NikitaSM5/ATmega-16-RTD/СМ5-81_ДЗ_Зельницкий_НА.docx

Gerb-BMSTU_01

| Министерство науки и высшего образования Российской Федерации Федеральное государственное бюджетное образовательное учреждение высшего образования «Московский государственный технический университет имени Н.Э. Баумана (национальный исследовательский университет)» (МГТУ им. Н.Э. Баумана)

ФАКУЛЬТЕТ | Специальное машиностроение

КАФЕДРА | Автономные информационные и управляющие системы

дисциплина | Цифровые устройства и микропроцессоры

домашнее задание

Устройство измерения температуры

название домашнего задания

Группа | СМ5-81

Студент | | | | | Зельницкий Н.А.
| | | подпись | | фамилия, и.о.

Преподаватель | | | Кичигин А.А.
| подпись | | фамилия, и.о.

1 Техническое задание

Устройство должно измерять температуру окружающей среды, выдавать ее на 4 семисегментных индикатора в формате "xx.xx" и записывать на sd карту с указанием метки времени в формате "<номер измерения> дд:мм:гггг чч:мм <температура>". В качестве датчика использовать RTD Pt100. В качестве микросхемы преобразователя данных с RTD использовать MAX31865. Измерение происходит каждый час. Должна быть предусмотрена возможность чтения данных записанных на sd карту на ПК (например, по интерфейсу RS-232). Так же на LCD дисплее отображается текущее время, количество измерений на SD карте. Должна быть предусмотрена возможность отображения сохраненных измерений на SD карте. Частота тактирования микроконтроллера ATmega-16 - 8МГц, питание микроконтроллера, индикаторов и дисплея LCD - 5В, периферийных устройств (MAX31865, SD карта, часы реального времени) - 3.3В.

2 Разработка схемы электрической структурной

Схема электрическая структурная приведена в приложении А.

Схема электрическая структурная состоит из следующих блоков:

1) кварцевый резонатор,

2) кнопки,

3) 4 семисегментных индикатора,

4) разъем SD,

5) микроконтроллер,

6) преобразователь UART RS-232,

7) разъем программирования SPI,

8) микросхема max31865,

9) разъем DB9,

10) датчик Pt100,

11) микросхема реального времени PCF 8583,

12) разъем питания 5В,

13) фильтр по питанию,

14) защита от переполюсовки,

15) линейный преобразователь напряжения.

Блок кварцевый резонатор предназначен для стабилизации тактовой частоты микроконтроллера.

Блок кнопки, состоит из 4-х кнопок подключенных к выводам PC3, PC5, PC6, PC7 микроконтроллера, назначение кнопок следующее: при удержании PC3 на семисегментные индикаторы выводится текущее время в формате "мм.сс", нажатие кнопки PC5 позволяет посмотреть следующую запись на SD карте, кнопка PC6 возвращает счетчик записей в начало (к первой записи), по нажатию PC7 все содержимое SD карты отправляется по UART на ПК.

Блок семисегментные индикаторы включает в себя четырехразрядный семисегментный индикатор для отображения температуры или времени.

Блок SD карты включает в себя SD карту, которая по интерфейсу SPI обменивается данными с микроконтроллером.

Блок микроконтроллер состоит из микроконтроллера ATmega-16PU, к нему подключены все остальные блоки.

Блок преобразователь UART RS-232, предназначен для подключения приемо-передатчика UART к физическому разъему DB9.

Блок разъем программирования SPI предназначен для программирования микроконтроллера.

Блок микросхема MAX31865 включает в себя микросхему MAX31865 представляющую собой 15-ти битный АЦП, обменивающийся с микроконтроллером по интерфейсу SPI.

Блок разъем DB9 предназначен для передачи данных между ПК и микроконтроллером.

Блок датчик Pt100 представляет собой датчик температуры Pt100, на основе сопротивления данного датчика и микросхемы MAX31865 микроконтроллер получает данные о температуре.

Блок микросхема реального времени PCF 8583 представляет собой часы реального времени, необходимые для фиксирования времени измерения температуры, а также часовых интервалов, обменивается с МК по интерфейсу I2C.

Блок разъем питания 5В предназначен для подключения питания к микроконтроллеру.

Блок фильтр по питанию необходим для фильтрации питания МК.

Блок защита от переполюсовки предназначен для защиты МК от переполюсовки питания.

Блок линейный преобразователь напряжения предназначен для питания периферийных устройств, таких как SD карта, и MAX31865.

3 Разработка схемы электрической принципиальной

Схема электрическая принципиальная и перечень элементов приведены в приложении А.

Блок кварцевый резонатор, представлен кварцевым резонатором ZQ1 8 МГц, кристалл подключён между выводами XTAL1/XTAL2, каждая нога заземлена через конденсаторы C16 и C17 по 22 пФ.

Блок кнопки, SB1 — аппаратный «RESET»: при нажатии замыкает вывод RESET МК на землю, а R7 10 кОм держит линию подтянутой к питанию в остальное время. SB2–SB5 — пользовательские. Каждый соединён с портами PC3, PC5, PC6, PC7. Перед микроконтроллером стоят токоограничивающие резисторы R15–R18 по 1 кОМ; сами выводы подтянуты к VDD внутренним pull-up МК, поэтому логика «активный 0».

Блок четырёхразрядный 7-сегментный индикатор, сам индикатор HG1 CC56-12SRWA подключён по классической схеме мультиплексирования: сегменты A…DP (всего 8 линий) подключены к порту A; общие катоды/аноды разрядов коммутируют транзисторы VT1–VT4 (маломощные NPN) через базовые резисторы R9–R12 10 кОм. Базы управляются портом PB0–PB3. МК быстро «перещёлкивает» VT1–VT4, выводя в тот же момент код сегментов.

Блок разъем SD, X1 «SD_card» имеет выводы CMD (MOSI), CLK (SCK), DAT0 (MISO), CS, CD. На линиях данных стоят подтяжки R1, R3, R5, R6 по 10 кОм к шине 3V3, чтобы SD корректно себя вела до инициализации. Сразу у разъёма стоят конденсаторы C3, C4 0,1 µF для борьбы с импульсными бросками тока.

Передача идёт по SPI, линию SCK формирует PB7, MOSI — PB6, MISO — PB7, а PC4 служит выбором CS (совместно с MAX31865).

Блок микроконтроллер, чип разбит на два УГО D2.1/D2.2. Питается от +5 В (VCC): локальная развязка выполнена керамиками C2, C5, C7 по 0,1 µF прямо у ножек питания.

Блок преобразователь UART RS-232, Функциональный узел реализован одной микросхемой MAX202CDR (позиция D3) . MAX202 содержит два драйвера и два приёмника с интегрированным зарядовым насосом, формирующим на базе внешних конденсаторов C1–C4 = 0,1 µF уровни V+ ≈ +9 В и V − ≈ −9 В из однополярного питания +5 В. TTL-выводы T1IN/R1OUT связаны соответственно с линиями TXD (PD1) и RXD (PD0) микроконтроллера, а выходы T1OUT/R1IN подают сигналы уровня EIA-232 на разъём DBR-9M (X2), контакты 2 (TX) и 3 (RX). Такой подход обеспечивает двусторонний обмен данными со скоростями до 120 кбит/с при гальванической развязке по потенциалам ±10 В, что соответствует спецификации TIA/EIA-232-F.

Блок разъем программирования SPI, Разъём XP4 «PLD-4» предоставляет стандартный шлейф AVR-ISP (MISO, MOSI, SCK, RESET, VCC, GND). Проводимость линий SPI обеспечивается непосредственно выводами МК (PB5/MOSI, PB6/MISO, PB7/SCK), а общий сброс формируется выводом RESET через подтяжку R7 = 10 kОМ. Такой интерфейс позволяет выполнять внутрисистемное программирование флэш-памяти ATmega16 без демонтажа микросхемы.

Блок микросхема max31865, Измерительный канал построен на специализированном Δ-Σ-АЦП MAX31865 (D1). Эталонный резистор R2 = 430 Ом формирует токовый источник ≈ 2,05 мА для платинового датчика. Четырёхпроводное подключение (пары FORCE ± и RTDIN ±) компенсирует омическое сопротивление линий. Декуплирующие конденсаторы C1, C6, C8 = 0,1 µF шунтируют аналого-цифровое и цифровое питания чипа. Управление осуществляется по интерфейсу SPI (SDI, SDO, SCLK), однако для защиты временных шин модуль имеет индивидуальный сигнал CS. MAX31865 выполняет 15-битное оцифровывание, что даёт разрешение ≈ 0,0076 °C на диапазоне 0–400 °C при Pt100.

Блок разъем DB9, разъём DBR-9M (X2) служит физическим интерфейсом к внешнему СOM-порту персонального компьютера, принимая уровни ±9 В с микросхемы MAX202. Назначения ножек выведены прямо на схеме: 2 — RS232TX, 3 — RS232RX, 5 — GND.

Блок датчик Pt100, к контактам FORCE ± подаётся стабильный токовый источник чипа MAX31865, напряжение на выводах RTDIN ± считывается тем же чипом; возвратный токовый вывод ISENSOR позволяет измерителю контролировать реальный ток через датчик. Трех проводная схема исключает погрешность, вызванную омическим сопротивлением кабеля и разъёмов.

Блок микросхема реального времени PCF 8583, микросхема PCF8583P (D2) питается от стабилизированного напряжения 3,3 В и стабилизируется кварцевым резонатором ZQ2 = 32,768 кГц с нагрузочными конденсаторами C18, C19 = 22 пФ. Информационный обмен ведётся по шине I²C (SCL — PC0, SDA — PC1). Вывод NINT обеспечивает аппаратное прерывание будильника на вход МК PC2. Локальная фильтрация питания реализована конденсаторами C11–C13 = 0,1 µF, что позволяет RTC сохранять ход времени при импульсных помехах.

Блок разъем питания 5В, Коннектор XP3 (DJB-02B) имеет нумерацию: контакт 1 — +5 В, контакт 3 — GND . Далее напряжение поступает на цепи защиты и фильтрации, после чего распределяется по функциональным узлам.

Блок защита от переполюсовки, выполнен шоттки-диодом VD1 в прямом включении между входом +5 В и потребителями. При обратном подключении источника питания диод запирается, ограничивая обратный ток до единиц микроампер и предотвращая выход из строя downstream-электроники. Применение шоттки-структуры минимизирует прямое падение (≈ 0,3 В) при штатной полярности.

Блок фильтр по питанию, представлен конденсатором C2.

Блок линейный преобразователь напряжения, LDO ADP165 (DA1) формирует шину 3V3 из входных +5 В . Типичный ток нагрузки — до 150 мА; остаточное падение напряжения ΔV ≈ 250 мВ при 100 мА. Конденсаторы C3, C4, C12 = 0,1 µF рекомендуются даташитом для устойчивости петли обратной связи и подавления шумов. Логический вход EN подтянут резистором R4 = 10 kОм к выходному напряжению, что обеспечивает автозапуск без внешнего сигнала. Сформированная шина 3,3 В питает SD-накопитель, MAX31865, PCF8583 и логические каскады индикации, что снижает тепловые потери и электромагнитные выбросы относительно прямого питания от 5 В.

4 Разработка алгоритма программы

Блок схема алгоритма программы представлена в приложении А.

Таблица 1 — Глобальные переменные объявленные в main

Переменная | Тип | Назначение
fwd_hold_cnt, bwd_hold_cnt | volatile uint16_t | Сколько миллисекунд удерживается соответствующая кнопка «вперёд/назад»; используется для определения долгого нажатия.
fwd_rep_cnt, bwd_rep_cnt | volatile uint16_t | Таймер повтора событий при удержании кнопок (автоповтор навигации).
ms_ticks | volatile uint32_t | Счётчик миллисекунд, увеличивается в прерывании TIMER0_OVF; служит единой «системной» временной базой.
nav_end_event, nav_start_event | volatile uint8_t | Одноразовые флаги «перейти в конец лога» / «в начало лога», выставляются на двойной клик соответствующих кнопок.
last_sent_meas | volatile uint32_t | Кол-во записей, уже выгруженных по UART, чтобы продолжать нумерацию после дампа.
meas_no | uint32_t | Текущий номер измерения, считая с 1 (заполняется при старте размером файла SD).
nav_pos | uint32_t | «Курсор» при просмотре лога: номер строки, показанной на LCD.
rtc_time | struct pcf_time | Последнее прочитанное время из RTC PCF8583.
disp_digits[4] | volatile uint8_t[4] | Четыре BCD-разряда, которые мультиплексно отображаются на 7-сегментном индикаторе.
linebuf[32], linebuf_hist[32] | char[32] | Рабочие буферы для текущей строки лога (основной/исторический режим).
scroll_buf[32], scroll_len, scroll_ofs, scroll_t0 | char[32], uint8_t, uint8_t, uint32_t | Хранят текст бегущей строки на LCD и параметры её прокрутки.
last_sent_entry | uint32_t | Запоминает номер последней строки, успешно отправленной по UART (для прогресс-бара во время дампа).

Таблица 2 — Глобальные массивы с областью видимости во всем проекте

Модуль | Массив | Назначение
main.c | disp_digits | Данные для 7-сегментника.
sdcard.c | sec_buf[512] | RAM-буфер целого сектора SD-карты; заполняется перед чтением/записью.
sevseg.c | dec2sevseg[10] | Таблица кодов сегментов для цифр 0–9. ctrl_pins[4] — маски выводов катодов/анодов.

Файл main.c — это центральный модуль, управляющий всей работой измерительного стенда на МК ATmega16

Подключаемые файлы и стандартные заголовки: в начале подключаются пакеты для работы с семисегментными индикаторами, MAX31865, шины TWI, часов RTC PCF8583, SD-карты, LCD 16×2, а также стандартные заголовки AVR (avr/io.h, avr/interrupt.h, util/delay.h, stdlib.h, string.h). Благодаря этим включениям в main.c почти нет «ручной» работы с аппаратными регистрами — исключение составляет настройка таймеров и портов ввода-вывода.

Макросы и константы: частота F_CPU задаётся 8 000 000 Гц, чтобы функции _delay_ms() и _delay_us() рассчитывали правильные паузы. Определены маски кнопок (PC3 — переключение режима, PC5 и PC6 — навигация вперёд / назад, PC7 — дамп журнала и регистр маски всех семисегмент-катодов. Для автоповтора кнопок заданы задержка перед первым повтором 250 мс, базовый период повторов 500 мс и минимально допустимый период 1 мс. Для бегущей строки на LCD заданы пауза в начале и конце 1000 мс и шаг прокрутки 250 мс.

Глобальные переменные ms_ticks — глобальный счётчик миллисекунд, который увеличивается в прерывании TIMER0. fwd_hold_cnt и bwd_hold_cnt — время удержания кнопок «вперёд» и «назад» в миллисекундах. fwd_rep_cnt и bwd_rep_cnt — обратные таймеры автоповтора для тех же кнопок. last_sent_meas — число строк, уже переданных на ПК; нужно, чтобы после дампа продолжить нумерацию журнала. scroll_t0, scroll_len и scroll_ofs — параметры бегущей строки (момент запуска, общая длина текста и текущий сдвиг). Структура flags (8 бит) содержит флаги: one_sec, ten_sec, nav_fwd, nav_bwd, uart_dump, btn_lock, history, hist. Первый выставляется каждую секунду, второй — раз в десять секунд (для проверки) или раз в час согласно тз, следующие два инициируют навигацию на одну строку, uart_dump стартует выгрузку лога в UART, btn_lock временно блокирует действия кнопок во время записи или дампа, history сообщает, что пользователь нажал кнопку переключения режима, а hist хранит текущий режим «история активна / неактивна». disp_digits[4] — четыре ВCD-цифры для семисегментника. linebuf — строка с актуальным измерением, выводимая во втором ряду LCD в режиме Live. linebuf_hist — строка, показанная в режиме History. scroll_buf[32] — копия той же строки для плавной прокрутки.

Вспомогательные функции bcd2dec() преобразует один BCD-байт из регистра часов в десятичное число. time2str() формирует строку «ЧЧ:ММ:СС» из структуры времени RTC.

temperature_to_digits_tenth() переводит число с плавающей точкой (градусы) в четыре BCD-разряда с одной десятичной точкой и знаком, помещая результат в disp_digits. go_to_log_start() и go_to_log_end() позиционируют взаимодействующий с SD-картой итератор на первую или последнюю запись журнала, считывают строку, обрезают перевод строки, перерисовывают вторую строку LCD и запускают скролл.

scroll_update() каждые 250 мс сдвигает 16-символьное «окно» по scroll_buf и печатает его на LCD; в начале и в конце строки выдерживается секундная пауза. uart_putc() и uart_puts() передают байт или строку по UART, опрашивая флаг готовности UDRE. uart_dump_log() перебирает все записи SD-карты, отправляет их в UART, выводит прогресс на LCD, корректирует счётчик last_sent_meas, а в конце очищает SD-файл.

Обработчики прерываний ISR(TIMER1_COMPA_vect) срабатывает раз в 1024 мс, поднимает флаг one_sec; через 10/60 итерации устанавливает ten_sec. ISR(TIMER0_OVF_vect) тикает каждую миллисекунду. Он обслуживает динамическую индикацию семисегментника (если не идёт дамп), увеличивает ms_ticks, опрашивает кнопки, ловит фронты, измеряет длительность удержания и двойные клики, рассчитывает период автоповтора и выставляет соответствующие флаги навигации, переключения режима или запуска дампа.

Инициализационные функции: uart_init() включает передатчик и приёмник, настраивает скорость 56 кбод в режиме удвоенной скорости. timer0_init() задаёт предделитель 64, разрешает прерывание TOIE0. timer1_init() включает режим CTC, ставит делитель 256 и значение OCR1A = 1023, что даёт ровно 1024 тиков F_CPU и интервал ≈ 1,024 с. port_init() переводит PC3, PC5, PC6 и PC7 во входы с подтяжками; остальные линии настраиваются драйверами периферии.

Ход работы функции main(): после подключения заголовков и объявления глобальных переменных вызываются: uart_init, port_init, sevseg_init, lcd_init. На LCD временно выводится цифра 1 как индикатор этапа загрузки. Затем выполняется max31865_init (на LCD появится цифра 2), функция timer0_init, функция timer1_init, далее — sd_iter_reset (логический «курсор» ставится на конец файла на SD-карте), twi_init, глобальное разрешение прерываний sei() и инициализация RTC pcf_init(). Число уже существующих записей считывается функцией sd_get_entry_count и сохраняется в переменную meas_no.

Далее запускается бесконечный цикл. Если установлен флаг history, программа меняет текущий режим: если режим History выключен, она копирует текущую строку лога из linebuf_hist на LCD и подготавливает скролл; если включён — возвращается к режиму Live. При флаге one_sec считывается время через TWI из RTC, запускается преобразование RTD-значения в температуру, число формируется на семисегментнике, LCD получает строку «ЧЧ:ММ:СС #N». При флаге ten_sec (и если кнопки не заблокированы) формируется строка «HH:MM:SS;T=xx.x», записывается на SD-карту, копируется в linebuf_hist, а режим History при необходимости обновляет индикацию и бегущую строку; после записи кнопки вновь разрешены. При флагах nav_fwd или nav_bwd итератор двигается на одну запись вперёд или назад; при nav_*_event (двойной клик) он прыгает в начало или конец журнала соответственно. При флаге uart_dump вызывается uart_dump_log, после чего SD-карта очищается, а переменные счётчика и буферы обновляются. Каждую итерацию цикла вызывается scroll_update, которая сдвигает бегущую строку.

Алгоритм обработки кнопок и автоповтора ISR TIMER0 обнаруживает фронт кнопки, сохраняет время нажатия, через 250 мс активирует первую автоповторную прокрутку и далее уменьшает интервал до 1 мс пропорционально объёму журнала. Второй фронт, пришедший раньше 70 мс после первого, трактуется как двойной клик; это поднимает специальные флаги nav_start_event или nav_end_event.

Сенсор через MAX31865 работает в непрерывном режиме; каждую секунду считывается регистр RTD, преобразуется в температуру и отображается. Каждые десять секунд строка журнала записывается на SD; при удержании кнопки PC7 весь журнал побайтно передаётся в UART и затем файл на карте очищается. Семисегментник обновляется из ISR TIMER0, а LCD обновляется только из главного цикла, чтобы не нарушать тайминги дисплея.

Назначение модуля: sevseg.c реализует полный пакет для работы четырёхразрядного семисегментного индикатора. Драйвер выполняет инициализацию портов, преобразует двоичное 16-битное число в BCD-4, обеспечивает циклический вывод разрядов с возможностью гашения ведущих нулей, установки десятичной точки и отображения знака «минус».

Аппаратная привязка: в начале файла заданы макросы DATA_PORT/ DATA_DDR, указывающие на порт A, к которому подключены сегменты, и CTRL_PORT/CTRL_DDR, указывающие на порт B, где расположены управляющие выводы общих анодов/катодов разрядов. Для индивидуальных линий выбраны биты PB0…PB3, а маска CTRL_PIN_MASK объединяет их для массовых операций. Эта схема даёт возможность за один такт гасить все разряды или включать любой из них.

Глобальные статические параметры: dot_pos хранит номер разряда (0–3), возле которого следует зажечь точку; значение 0xFF означает, что точка выключена. Флаг blank_leading определяет, нужно ли подавлять вывод ведущих нулей. Для знака «минус» зарезервирован сегментный шаблон SEVSEG_MINUS_CODE = 0b00000010, соответствующий зажиганию только среднего горизонтального сегмента.

Константные таблицы: ctrl_pins[4] и dec2sevseg[10] помещены в flash-память (PROGMEM), чтобы не расходовать ОЗУ. Первая таблица содержит готовые маски включения нужного разряда, вторая — коды сегментов для цифр 0…9. Использование pgm_read_byte() исключает лишнее копирование в SRAM и ускоряет доступ.

Инициализация: sevseg_init() переводит все восемь линий порта A и четыре линии порта B в режим выхода, гасит сегменты (DATA_PORT = 0) и разряды (CTRL_PORT &= ~CTRL_PIN_MASK). В конце дополнительно активируется первый индикатор; замечание TODO в комментарии предлагает проверить необходимость этой строки, но она полезна как тест на целостность схемы при старте.

Преобразование числа: sevseg_bin2bcd() разбивает 16-битное беззнаковое значение на тысячи, сотни, десятки и единицы простой последовательностью делений и модулей. Заполнение массива идёт от старшего разряда к младшему, поэтому достаточно один раз сдвинуть указатель в конец и декрементировать его по мере работы. Максимально поддерживаемое число — 9999.

Внутренний счётчик разрядов: статическая функция inc_number_digit() инкрементирует локальную переменную num_dig и маскирует её по & 0x03, получая циклическую последовательность 0 → 1 → 2 → 3 → 0. Такой счётчик позволяет вызывать диспетчер вывода из прерывания таймера с частотой ≈1 кГц, обеспечивая частоту обновления каждого разряда ≈250 Гц без избытка вычислений. sevseg

Отрисовка одного разряда: display_digit() сначала гасит всё (обнуляет порт данных и снимает все управляющие биты), затем выбирает нужный символ: если код ≤ 9, берётся шаблон из dec2sevseg; если код 0x0A, отображается «минус»; любые иные коды игнорируются, что даёт универсальный «пустой» символ. Для подавления лидирующих нулей функция проверяет, нет ли ненулевых разрядов старше текущего; если их нет и цифра равна нулю, разряд просто остаётся выключенным. При совпадении num_dig с dot_pos в шаблон OR’ом добавляется бит десятичной точки (LSB). После формирования маски сегментов она выводится в DATA_PORT, а в CTRL_PORT устанавливается бит выбранного разряда. Cхема алгоритмаCхема алгоритма

Процесс отображения: sevseg_display_process() является внешним интерфейсом для приложения. На каждый вызов она запрашивает очередной номер разряда у inc_number_digit() и передаёт управление display_digit(). Таким образом за четыре последовательных вызова (например, четыре тика таймера) отрисовывается полное число.

Выключение: sevseg_off() сбрасывает DATA_PORT, мгновенно гасит все сегменты и может использоваться для экономии энергии во время длительного сна МК или при передаче буфера UART, когда световой шум нежелателен.

Взаимодействие с остальной прошивкой: главный модуль (main.c) предварительно преобразует температуру или счётчики в BCD-4 через sevseg_bin2bcd(), затем помещает результат в глобальный массив disp_digits. Прерывание TIMER0 вызывает sevseg_display_process(disp_digits) с частотой 1 кГц; если идёт дамп журнала, отображение временно останавливается, и порт A обнуляется.

Назначение модуля: max31865.c формирует полностью автономный драйвер SPI-конвертера, обеспечивая инициализацию, считывание «сырых» данных RTD, перевод сопротивления сенсора Pt100 в температуру по уравнению Каллендара–Ван Дюзена, а также обработку и сброс флагов неисправностей.

Аппаратная привязка: вывод CS приёмника назначен PB4; макросы MAX31865_CS_PORT, MAX31865_CS_DDR, MAX31865_CS_PIN задают этот вывод и используются в inline-процедурах cs_low() и cs_high() для формирования SPI-кадров .

Регистровая карта: заголовок описывает восьмибитные адреса 0×00…0×07; конфигурационный регистр (адрес 0) содержит биты CFG_BIAS, CFG_MODE_AUTO, CFG_3WIRE, CFG_FILT50HZ и проч., а регистр RTD_MSB/LSB (адреса 1/2) хранит 15-битное измеренное значение сопротивления.

Калибровочные константы: номинальное сопротивление RTD R0 = 100 Ω, опорный резистор платы RREF = 430 Ω, а также коэффициенты A, B и C классического полинома Pt100 (значение C используется только ниже 0 °C).

Базовые операции SPI: функции write_reg() и read_reg() формируют однобайтовые транзакции (бит 7 адреса отвечает за признак записи), read_reg16() расширяет процедуру до приёма двух последовательных байт; каждая транзакция обрамляется опусканием и подъёмом CS, что гарантирует атомарность обмена.

Процедура инициализации: max31865_init(three_wire, filter50Hz) настраивает CS-пин как выход, активирует общий драйвер SPI, производит начальную инициализацию SD-карты, формирует байт cfg, в который при необходимости включаются биты трёхпроводной компенсации и 50-герцового фильтра, далее включает ток RTD (CFG_BIAS), выдерживает 10 мс для термостабилизации и переводит микросхему в непрерывный режим измерения (CFG_MODE_AUTO).

Чтение «сырых» данных: max31865_read_raw() извлекает 16-битное поле RTD, сдвигает его вправо на 1 бит (убирая флаг ошибки) и маскирует до 15 бит – результат соответствует диапазону 0…32767 .

Нормирование сопротивления: функция max31865_read_temperature() умножает «сырое» число на RREF/32768, получая реальное сопротивление Rt; далее вычисляет относительное значение Z = Rt/R0 .

Диагностика: max31865_read_fault() читает регистр FAULT_STATUS и возвращает маску флагов обрыва, короткого замыкания и других сбоев; max31865_clear_fault() временно останавливает преобразования, записывает в CFG_CLEAR_FAULT, затем перезапускает режим bias + auto, полностью очищая регистр ошибок max31865max31865.

Интеграция с прошивкой: главный цикл проекта извлекает температуру через max31865_read_temperature() раз в секунду и передаёт её в процедуру temperature_to_digits_tenth() для отображения; кроме того, «сырое» значение может быть журналировано на SD для последующего анализа. Модуль не содержит блокирующих задержек, кроме 10-миллисекундной паузы в инициализации, и поэтому не препятствует выполнению остальных задач системы.

Назначение модуля: sdcard.c реализует фундаментальный слой доступа к съёмному энергонезависимому запоминающему устройству стандарта Secure-Digital в режиме SPI. Принята парадигма «одна строка журнала — один логический сектор»: каждое сообщение длиной до 510 байт помещается целиком в сектор объёмом 512 байт, завершается символом LF, а оставшееся пространство заполняется маркером 0xFF — этот приём избавляет от расчётов смещения внутри блока и ускоряет навигацию по журналу.

Аппаратная привязка и базовые макросы: линия Chip-Select карты подключена к выводу PC4. Шаблоны spi_x() (полудуплексная передача) опираются на универсальный драйвер spi_transfer() и используются во всех транзакциях протокола SD SPI.

Глобальные структуры данных: статический буфер sec_buf[512] хранит содержимое текущего сектора; флаг card_sdhc различает карты адресных пространств SDSC (байтовая адресация) и SDHC (блочная адресация); счётчики next_sector и it_sector задают точку очередной записи и позицию итератора чтения соответственно; переменная eeprom_next_sector, размещённая в области EEPROM, обеспечивает устойчивость журнала к выключениям питания .

Командный интерфейс: функция sd_cmd() формирует пять-байтную команду SD-SPI (префикс 0x40|CMD, аргумент 32 бит, контрольная сумма) и далее опрашивает карту до появления ответа с битом ready=0 . Такой неспешный 10-байтовый цикл выбран как компромисс между латентностью и совместимостью с медленными носителями.

Процедура инициализации (sd_init): 1) CS переводится в высокий уровень (passive); 2) передаются 80 тактных импульсов SCK «вхолостую» для выхода карты из приёмника ; 3) выполняется команда CMD0 — переход в состояние IDLE; 4) через CMD8 проверяется поддержка напряжения 3,3 В и версии V2.0; 5) циклическим ACMD41 карта выводится из IDLE с возможным указанием бита HCS; 6) CMD58 считывает регистр OCR, по 30-му биту которого устанавливается тип SDHC/SDSC . Завершается инициализация чтением сохранённого в EEPROM номера хвостового сектора; при отсутствии корректного значения задействуется резервная процедура поиска хвоста (find_tail).

Низкоуровневое чтение: read_sector(lba) запрещает обращение к логическому сектору 0 (защита MBR), затем, учитывая тип карты, конвертирует LBA в адрес (для SDSC — умножение на 512), посылает CMD17, ждёт токен 0xFE не более 100 мс, и считывает 512 байт полезных данных плюс фиктивный CRC .

Низкоуровневая запись: write_sector(lba) выполняет пред-ожидание готовности шины (wait_ready ≤ 250 мс), посылает CMD24, токен 0xFE, пересылает содержимое буфера и две фиктивные контрольные суммы, после чего анализирует поле data-response (ожидается 0b101) и вновь ждёт выхода карты из состояния busy.

Логический формат хранилища: строка измерения копируется в начало sec_buf, после чего запись завершается переводом строки '\n', а оставшиеся байты сектора инициализируются 0xFF. Ограничение 510 байт гарантирует, что вместе с \n и заполняющим шаблоном объём строго равен 512 байтам. Длина 0 запрещена — это рассогласовывает нумерацию и даёт код ошибки 4 sdcard.

Функции журналирования: sd_write_line() сохраняет сектор по адресу next_sector, затем атомарно увеличивает счётчик и асинхронно обновляет копию в EEPROM, обеспечивая сохранность индекса даже при внезапном обесточивании sdcardsdcard. sd_clear_log() заполняет заданное число секторов 0xFF и сбрасывает указатель хвоста в 1.

Итеративное чтение: sd_iter_reset() обнуляет позицию, а sd_read_line(dir, dst, sz) реализует двунаправленный алгоритм: при dir>0 сектора читаются по возрастанию, при dir<0 — по убыванию, пропуская пустые блоки 0xFF; данные копируются функцией copy_line(), которая отсекает либо символ LF, либо маркер конца блока — 0xFF sdcardsdcard. Функция sd_read_line_at() поддерживает прямую адресацию по номеру записи; диапазон контролируется относительно динамического next_sector для предотвращения вычитки вне текущего журнала.

Обнаружение хвоста: резервная функция find_tail() (в данный момент закомментирована ради ускорения старта) последовательно просматривает карту от сектора 1, пока не встретит полностью пустой блок 0xFF; найденное значение становится новым next_sector.

Хранение указателя хвоста: использование ячейки EEPROM как однонаправленного счётчика позволяет не тратить ресурс перезаписи — счётчик инкрементируется строго вперёд и обнуляется только при ручном очистке лога, что соответствует циклическому ресурсу >10⁵ записей.

Синхронизация по времени: задержки wait_token() и wait_ready() реализованы на основе миллисекундных busy-loop с _delay_ms(1), что обеспечивает детерминированную верхнюю границу ожидания и минимизирует влияние скорости конкретного носителя.

Обработка ошибок: все публичные API возвращают ненулевой код при отказе, детализируя причину (тайм-аут, некорректный ответ, попытка записи в LBA 0, выход за границы журнала, превышение длины строки и т.д.); значения кодов документированы в комментариях возле каждого return sdcardsdcard.

Взаимодействие с системой: модуль вызывается из главного цикла для периодического sd_write_line(), из навигационных обработчиков для sd_read_line() и из процедуры дампа -‐ uart_dump_log(). Благодаря полносекторному формату запись никогда не требует предварительного чтения, а чтение — лишних копирований, что снижает латентность и упрощает энергобаланс микроконтроллера при работе с картой.

Модуль TWI: драйвер формирует полный стек обмена по дву-проводной шине I2C в режиме Master-transmitter/Master-receiver с частотой 100 кГц. После вызова twi_init() регистр TWBR вычисляется как (F_CPU / LINE_FREQ – 16)/2, что при 8 МГц генерирует требуемый SCL≈100 кГц. Биты TWEN и TWIE одновременно включают модуль и разрешают прерывание по любому событию на шине; глобальный маркер twi_status переводится из состояния “не инициализирован” в TWI_STATUS_READY. Для каждой транзакции высокоуровневые процедуры twi_write() и twi_read() вызывают скрытую twi_txrx(), которая заполняет структуру twi { SLA+W, начальный регистр, указатель буфера, счётчик байт } и запускает состояние START, записав в TWCR комбинацию TWINT|TWSTA|TWEN|TWIE. Сразу после запуска twi_status выставляется в TWI_STATUS_TX_BUSY либо TWI_STATUS_RX_BUSY, что позволяет остальной прошивке опрашивать завершение операции.

Вектор ISR(TWI_vect) реализует конечный автомат: код состояния (TWSR & 0xF8)>>3 служит индексом в таблице указателей функций line_actions_table[LINE_CNT] — таким образом логика развёрнута в компактный jump-table в PROGMEM. Базовые под-процедуры включают line_send_slaw(), line_send_reg_addr(), line_tx_data() (передача данных при записи или генерация повторного START для чтения), line_rx_data() и line_rx_last_data(); есть и line_error_stop(), замыкающая TWI на STOP при любой ошибке — потеря арбитража, NACK или bus-error .

При передаче драйвер сначала посылает SLA+W, получает ACK, отсылает адрес регистра, а затем n-байт полезных данных; когда счётчик reach 0, ISR выставляет TWSTO, а twi_status переключается на TWI_STATUS_TX_COMPLETE. При чтении после повторного START и SLA+R приём каждого байта подтверждается ACK, пока не останется последний — для него ISR очищает TWEA, тем самым формируя NACK и закрывая цикл; по приходу последнего байта выставляется STOP и статус TWI_STATUS_RX_COMPLETE. Любая ошибка сразу переводит twi_status в TWI_STATUS_ERROR, что гарантирует выход из неопределённого состояния шины.

Таким образом, обмен выполняется полностью неблокирующим образом: основной код лишь инициирует twi_write/twi_read и затем асинхронно ждёт смены twi_status, как это сделано в main.c перед использованием свежих данных часов реального времени twi.

Модуль PCF8583: заголовок pcf8583.h определяет SLA-адрес 0xA0 (байт SLA+W), внутренние адреса регистров PCF8583 и компактную структуру pcf_time { seconds, minutes, hours }. Функция pcf_init() формирует массив из пяти байтов: секунды, минуты, часы, дата/месяц и день недели. Значения кодируются прямо из макросов TIME и DATE, переводя каждую цифру в BCD; дата конкатенируется по правилу производителя (два бита номера года, поля даты и месяца). Затем twi_write() передаёт массив в регистр SEC устройства, тем самым одновременно задавая полный набор временных счётчиков. Функция блокируется busy-loop’ом до тех пор, пока ISR не поставит twi_status = TWI_STATUS_TX_COMPLETE, после чего драйвер возвращается к состоянию READY, что гарантирует, что часы действительно приняли новые данные twimain.

Для выборки времени используется pcf_read_time(): она вызывает twi_read() с тем же базовым адресом SEC и размером структуры pcf_time. Из-за неблокирующего характера TWI чтению не требуется ждать — главный цикл опрашивает twi_status, и как только ISR завершит транзакцию, данные уже находятся в буфере, готовые к обработке (преобразованию bcd→dec и отображению) pcf8583.

В совокупности два модуля образуют иерархию: низкоуровневый twi.c реализует реентерабельный конечный автомат I2C, а pcf8583.h использует его абстракцию для инициализации и периодического опроса аппаратных часов PCF8583 без участия задержек в основном потоке программы, что соответствует требованиям реального времени и минимизирует джиттер в цикле измерений.

Назначение модуля lcd16x2: реализация низкопроизводительного драйвера символьного индикатора HD44780-совместимого формата 2×16 знаков, работающего в 4-битном полудуплексном режиме. Модуль обеспечивает программное (bit-bang) формирование полубайтового интерфейса, начальную и вторичную инициализацию контроллера, передачу команд и данных, управление курсором и простые высокоуровневые сервисы вывода буфера/строки.

Структура аппаратной привязки: сигнал RS размещён на PD2, строб E на PD3, линии данных DB7…DB4 — на PD7…PD4 (старшие биты порта D). Маска LCD_DATA_MASK==0xF0 позволяет атомарно обновлять лишь нужные линии, не затрагивая нижние четыре бита порта.

Алгоритм инициализации: функция lcd_init() после 15-мс паузы, описанной в datasheet, трижды посылает полубайт 0b0011 (команда «8-битный интерфейс»), постепенно сокращая паузу до 100 мкс, затем однократно — 0b0010 (переход в 4-битный протокол). Далее передаются полноформатные команды Function Set (0b0010 0100 — двухстрочный, 5×8 точек), Clear Display и Display ON; строгие задержки 1,5 мс/50 мкс соблюдаются документированными вызовами _delay_ms/_delay_us.

Примитивы передачи: lcd_send_hfbyte() выставляет старший полубайт на шину, генерируя фронт E→0—1, тем самым защёлкивая данные в HD44780. lcd_send_byte() упаковывает полный байт, вызывая hfbyte-процедуру дважды с длительностью 50 мкс. lcd_send_cmd()/lcd_send_char() различаются лишь состоянием RS: команда «0», данные «1» .

Высокоуровневые сервисы: lcd_disp_buf() и lcd_disp_str() выводят массив фиксированной длины или С-строку соответственно, пузырьковой логикой «post-increment», что экономит четыре такта AVR на циклическом условии lcd16x2. lcd_mov_cursor() конвертирует абсолютную позицию 0…31 в два окна DDRAM и формирует адресную команду (1<<LCD_DDRAM)|addr; таким образом достигается унификация двух строк дисплея.

Чистая программо-ориентированная модель задержек (busy-flag HD44780 не читается) облегчает разводку платы — требуется только выходное соединение; побочным эффектом является гарантированная верхняя граница длительности операций, критичных для real-time цикла измерений.

Назначение модуля spi: предоставление минимального, но полнофункционального драйвера аппаратного контроллера SPI периферии ATmega16 для режима Master, CPOL=1, CPHA=1 (SPI-mode-1). Константа fCLK/16 (500 кГц при F_CPU = 8 МГц) задаётся битом SPR0, обеспечивая безопасную частоту для SD-карт и MAX31865.

Инициализация: spi_init() конфигурирует PB5 (MOSI) и PB7 (SCK) как выходы, PB6 (MISO) как вход; регистр SPCR получает маску (SPE|MSTR|CPOL|CPHA|SPR0). Такой набор одновременно включает модуль, фиксирует полярность SCK «неактивный 1» и выборку данных по заднему фронту, согласуя фазы со слэйвами SD и MAX31865, указанные в их datasheet .

Базовая транзакция: spi_transfer() заносит байт в SPDR, циклически опрашивает SPSR & SPIF и немедленно возвращает принятый байт. Отсутствие побочных эффектов (функция нечувствительна к прерыванию) допускает вызовы из ISR и из основного потока без аренды шины — координация доступа возложена на вышестоящие модули SD и MAX31865 lcd16x2spi.

Верхнеуровневое использование: В SD-драйвере spi_transfer() участвует в формировании CMD-кадров, в приёме токенов 0xFE и обработке busy-time-out, что иллюстрируется блок-схемой SPI стр. 1–2 • В max31865.c вызовы spi_transfer() лежат в основе write_reg/read_reg16, где на уровне CS-процедур создаётся атомарный «транзакционный» контур Cхема алгоритмаCхема алгоритма.

5 Проверка программы в симуляторе – результаты компиляции, описание методики проверки в симуляторе и результаты самой проверки.

Рисунок 1 — Результат компиляции, количество используемой памяти

Из рисунка Рисунок 1, видно, что используется 10720 байт памяти программ, 762 байта памяти данных, 4 байта EEPROM памяти.

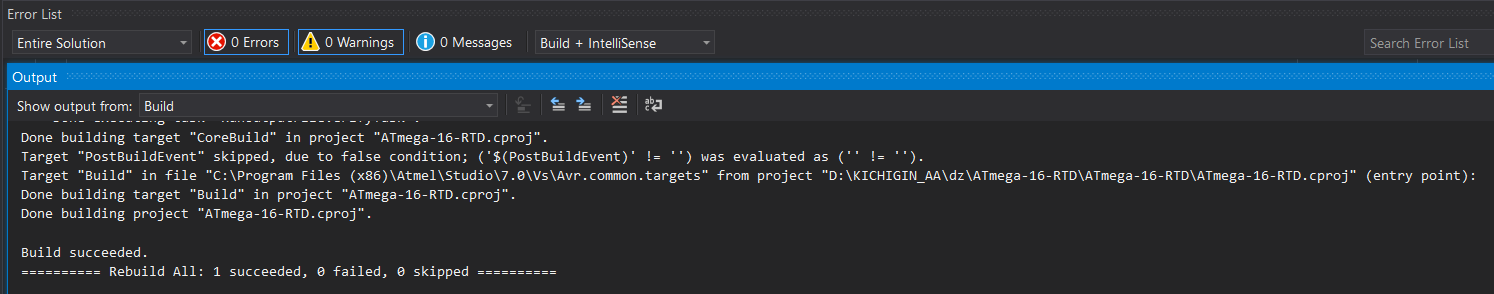
[picture p2: figure]

Рисунок 2 — Результат компиляции, предупреждения и ошибки

Из рисунка Рисунок 2 видно, что компиляция завершена успешно, ошибок и предупреждений нет.

Методика проверки в симуляторе: собрать в симуляторе Proteus схему в соответствии со схемой электрической принципиальной, проверить ее на правильность работы.

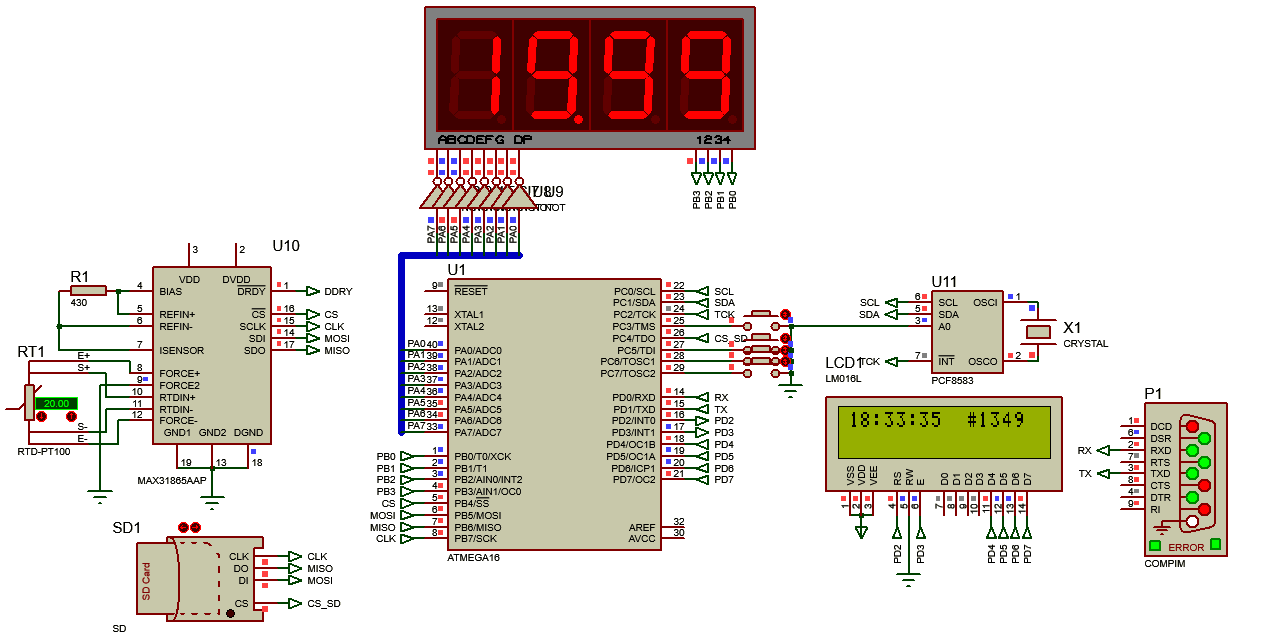
[picture p3: figure]

Рисунок 3 — Схема устройства в симуляторе Proteus

На схеме на рисунке 3 показана схема устройства в симуляторе Proteus, данная схема полностью повторяет схему реального устройства, что позволяет проверить работу устройства сразу целиком.

При проверке устройства в симуляторе необходимо: запустить симуляцию, по умолчанию устройство включается сразу и на индикаторах отображается текущая температура с микросхемы MAX31865,

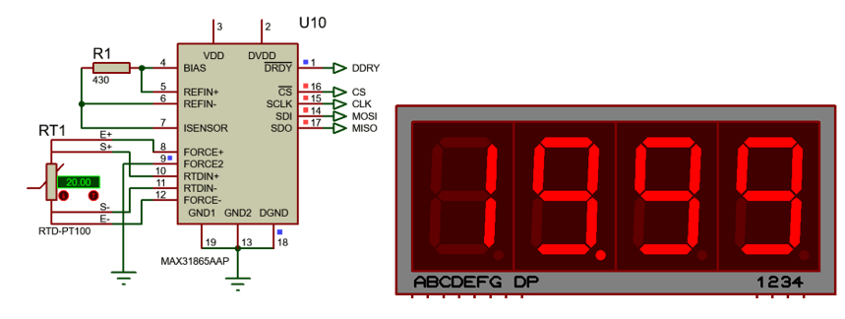
[picture p4: figure]

Рисунок 4 — Проверка устройства в симуляторе, сразу после включения

затем необходимо убедиться в том, что изменение температуры на датчике приводит к изменению отображаемой температуры на семисегментных индикаторах,

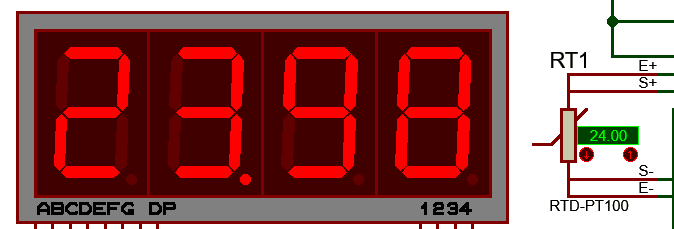
[picture p5: figure]

Рисунок 5 — Проверка устройства в симуляторе, реакция на изменение температуры

после этого необходимо убедиться в корректности записи данных на SD карту, для этого необходимо путем нажатия кнопок PC5, PC6 пролистать журнал записей и сравнить с показаниями датчика температуры,

Рисунок 6 — Проверка устройства в симуляторе, чтение с SD карты, 1 отчет

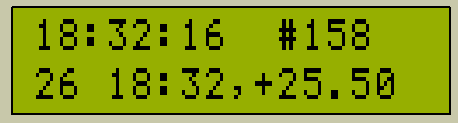
[picture p6: figure]

Рисунок 7 — Проверка устройства в симуляторе, чтение с SD карты, 26 отчет

так же в корректности данных записываемых на SD можно убедиться, открыв файл sdcard.mmc в текстовом редакторе,

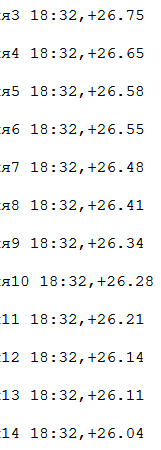
[picture p7: figure]

Рисунок 8 — Проверка устройства в симуляторе, чтение с SD, файл sdcard.mmc

после этого необходимо проверить удержание кнопок PC5, PC6, при их удержании журнал должен начать быстро перелистываться, так же при нажатии PC7 МК переходит в режим отправки данных по UART и на экране должна отобразится надпись UART.

Рисунок 9 — Проверка устройства в симуляторе, передача данных по UART

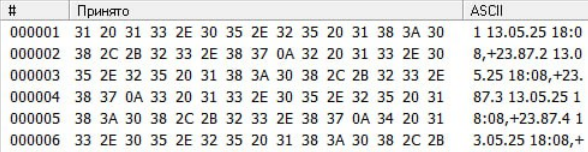
[picture p8: figure]

Рисунок 10 — Проверка устройства в симуляторе, принятые по UART данные

устройство должно отправлять данные на ПК единожды, то есть после отправки данных, вся информация на SD карте стирается, сохраняется только номер последнего измерения, чтение журнала и отправка данных, будет доступна только начиная с этого номера, при нажатии PC3 устройство переходит в режим отображения текущего измерения на LCD дисплее.

Рисунок 11 — Проверка устройства в симуляторе, проверка работы режима отображения текущего измерения

Таким образом результаты проверки работы программы в симуляторе показали, что работа программы в симуляторе полностью соответствует техническому заданию.

6 Проверка устройства на стенде – описание методики проверки на стенде EasyAVR6, настройки программатора, результаты проверки.

Методика проверки на стенде: собрать устройство согласно схеме электрической принципиальной, включить стенд, на экране должно отобразиться время, на семисегментных индикаторах - температура.

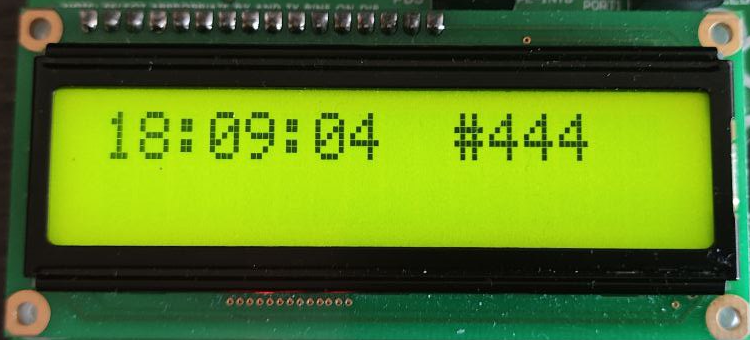
[picture p9: figure]

Рисунок 12 — Проверка устройства на стенде, сразу после включения

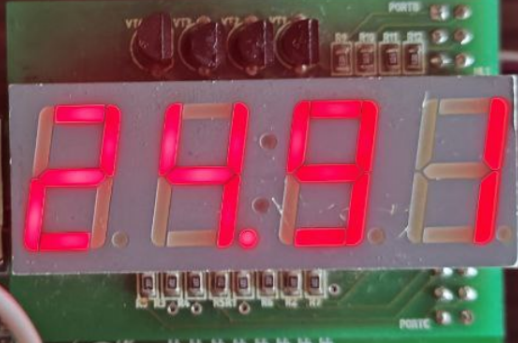
[picture p10: figure]

Рисунок 13 — Проверка устройства на стенде, сразу после включения, показания температуры

Проверить, что температура на индикаторе соответствует температуре датчика Pt100, затем нажатиями PC5 PC6 убедиться, что есть возможность чтения с SD карты, как вперед, так и назад, по двойному нажатию можно попасть, в конец/начало журнала.

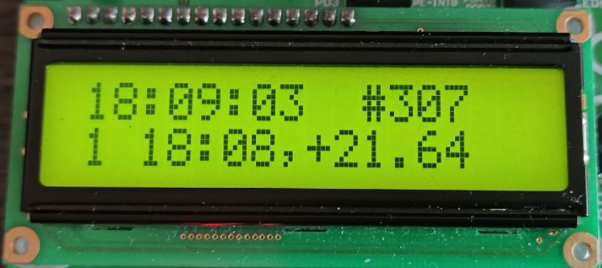
[picture p11: figure]

Рисунок 14 — Проверка устройства на стенде, отображение первой записи на SD карте

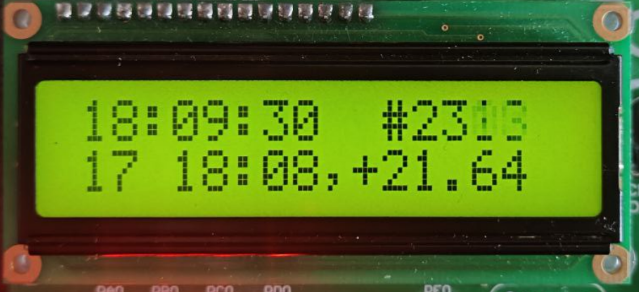
[picture p12: figure]

Рисунок 15 — Проверка устройства на стенде, отображение 17-й записи

При нажатии PC3 устройство должно переходить в режим истории и вторая строка дисплея должна отображать текущее измерение.

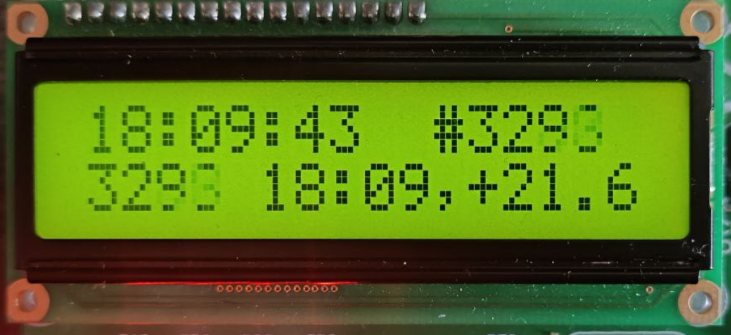
[picture p13: figure]

Рисунок 16 — Проверка устройства на стенде, режим истории

Проверить, что при отключении одного из периферийных устройств, измерения прекращаются.

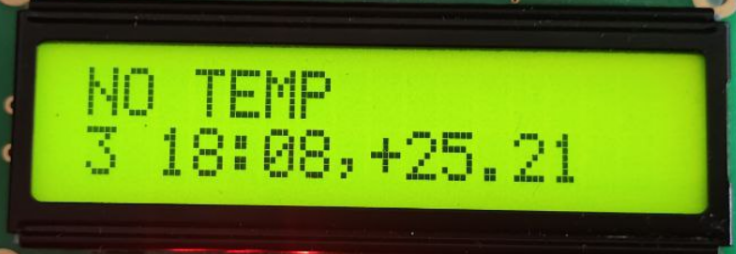
[picture p14: figure]

Рисунок 17 — Проверка устройства на стенде, нет соединения с микросхемой MAX 31865

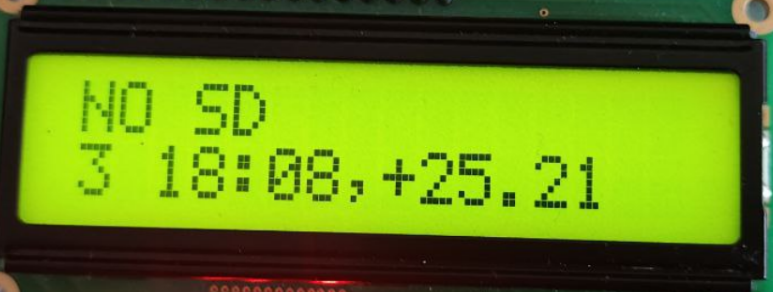
[picture p15: figure]

Рисунок 18 — Проверка устройства на стенде, нет соединения с микросхемой SD

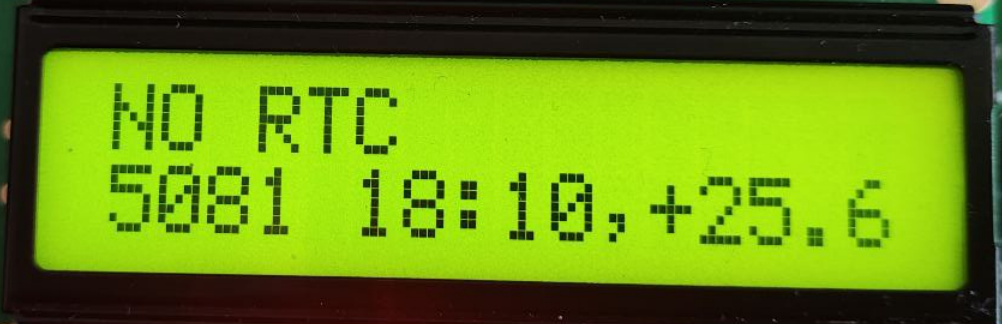
[picture p16: figure]

Рисунок 19 — Проверка устройства на стенде, нет соединения с микросхемой PCF8583

По нажатию PC7 все данные с SD карты отправляются по UART.

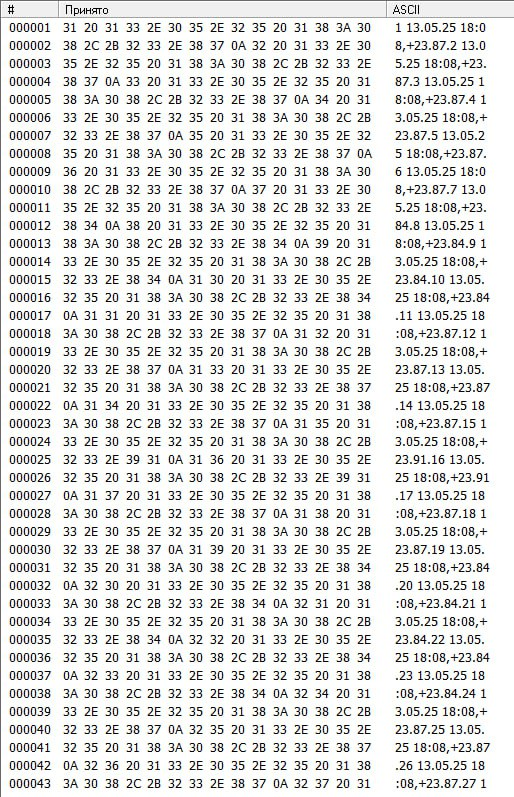
[picture p17: figure]

Рисунок 20 — Прием данных на ПК

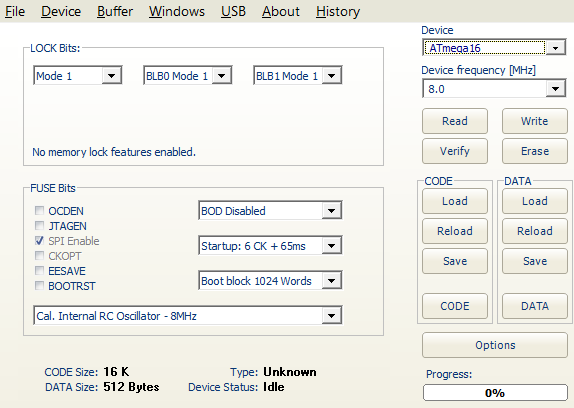
[picture p18: figure]

Рисунок 21 — Настройки программатора

Приложение А

1) схема электрическая структурная (рисунок А.1),

2) схема электрическая принципиальная (рисунок А.2),

3) перечень элементов (рисунки А.3, А.4),

4) схема алгоритма (рисунки А.5-А.33)

5) листинг файла main.c (страницы 64 - 72),

6) листинг файла lcd.h (страница 73),

7) листинг файла lcd.c (страницы 74 - 76),

8) листинг файла max31865.h (страница 77),

9) листинг файла max31865.c (страницы 78 - 79),

10) листинг файла sdcard.h (страница 80),

11) листинг файла sdcard.c (страницы 81 - 84),

12) листинг файла twi.h (страница 85),

13) листинг файла twi.c (страницы 86 - 89),

14) листинг файла sevseg.h (страница 90),

15) листинг файла secseg.c (страницы 91 - 93),

16) листинг файла spi.h (страница 94),

17) листинг файла spi.c (страница 95).

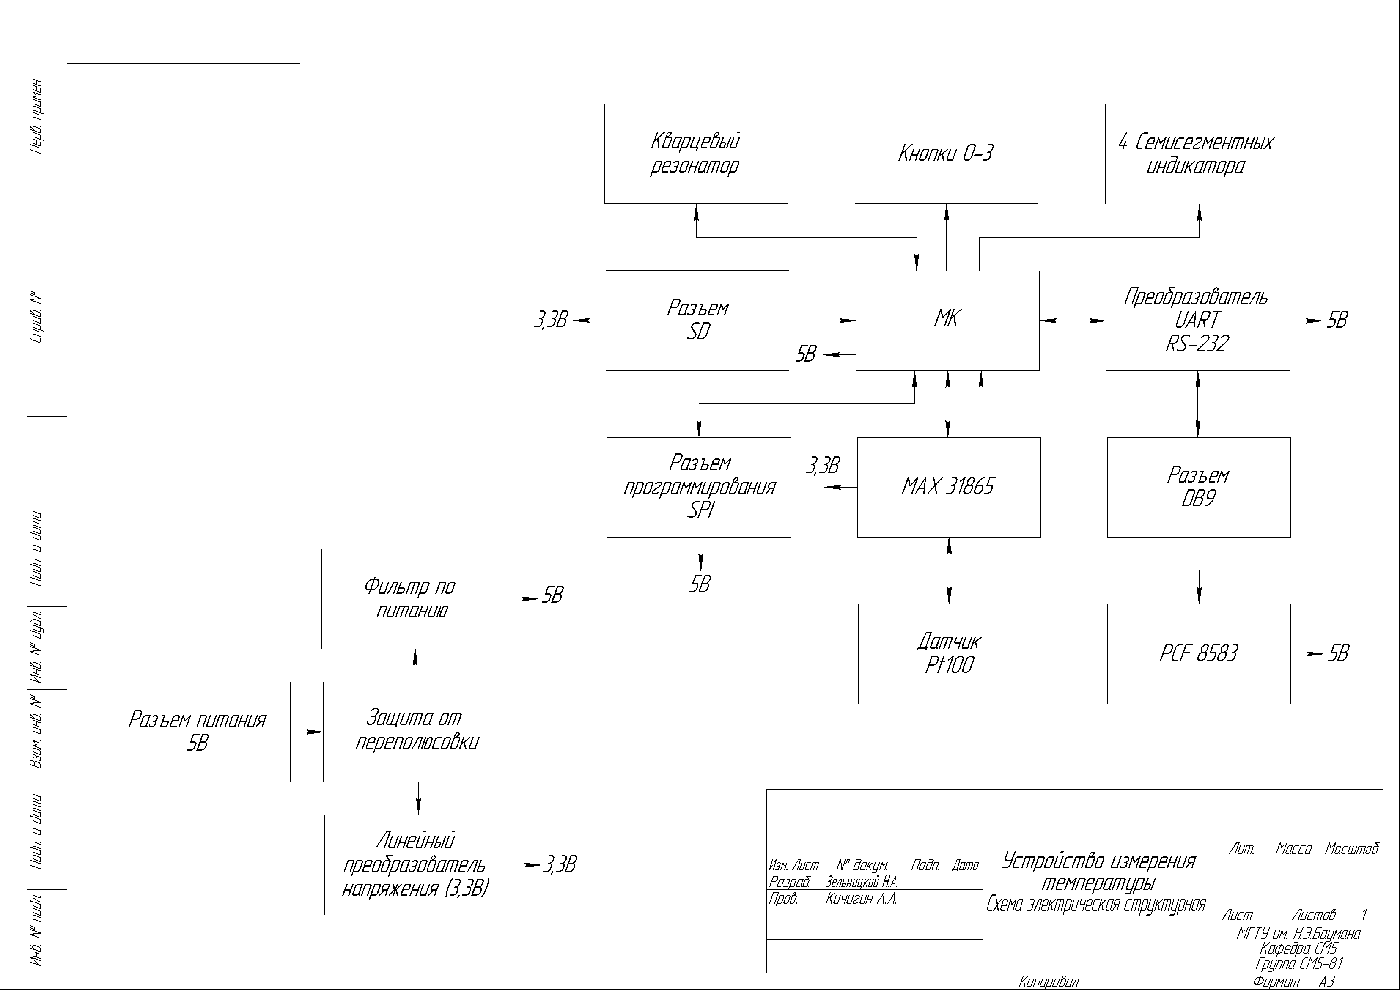
[picture p19: figure]

Рисунок А.1 — Схема электрическая структурная

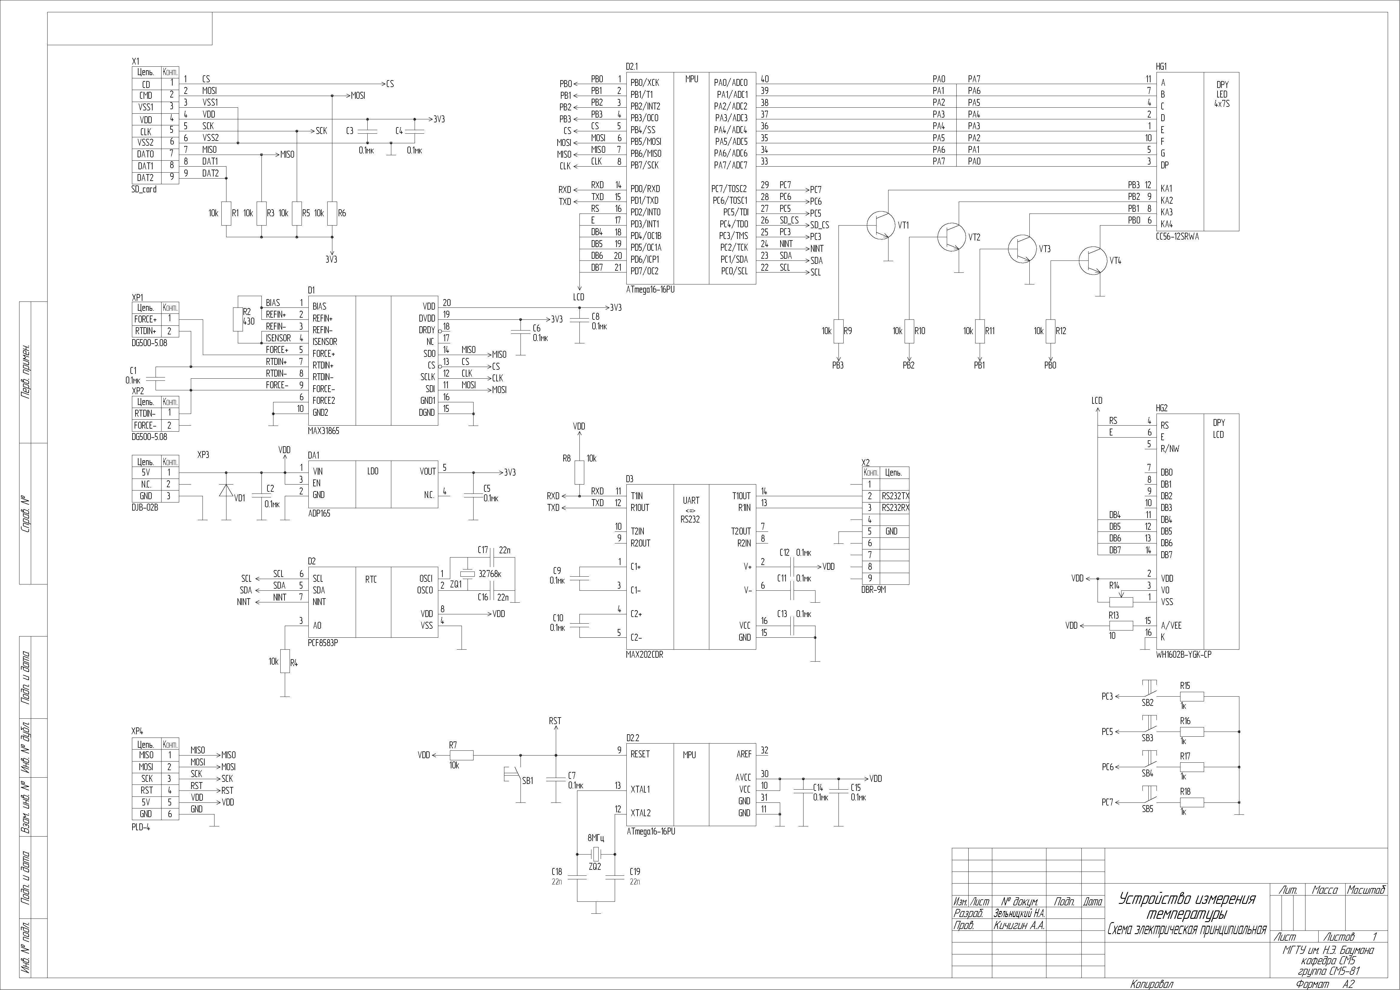
[picture p20: figure]

Рисунок А.2 — Схема электрическая принципиальная

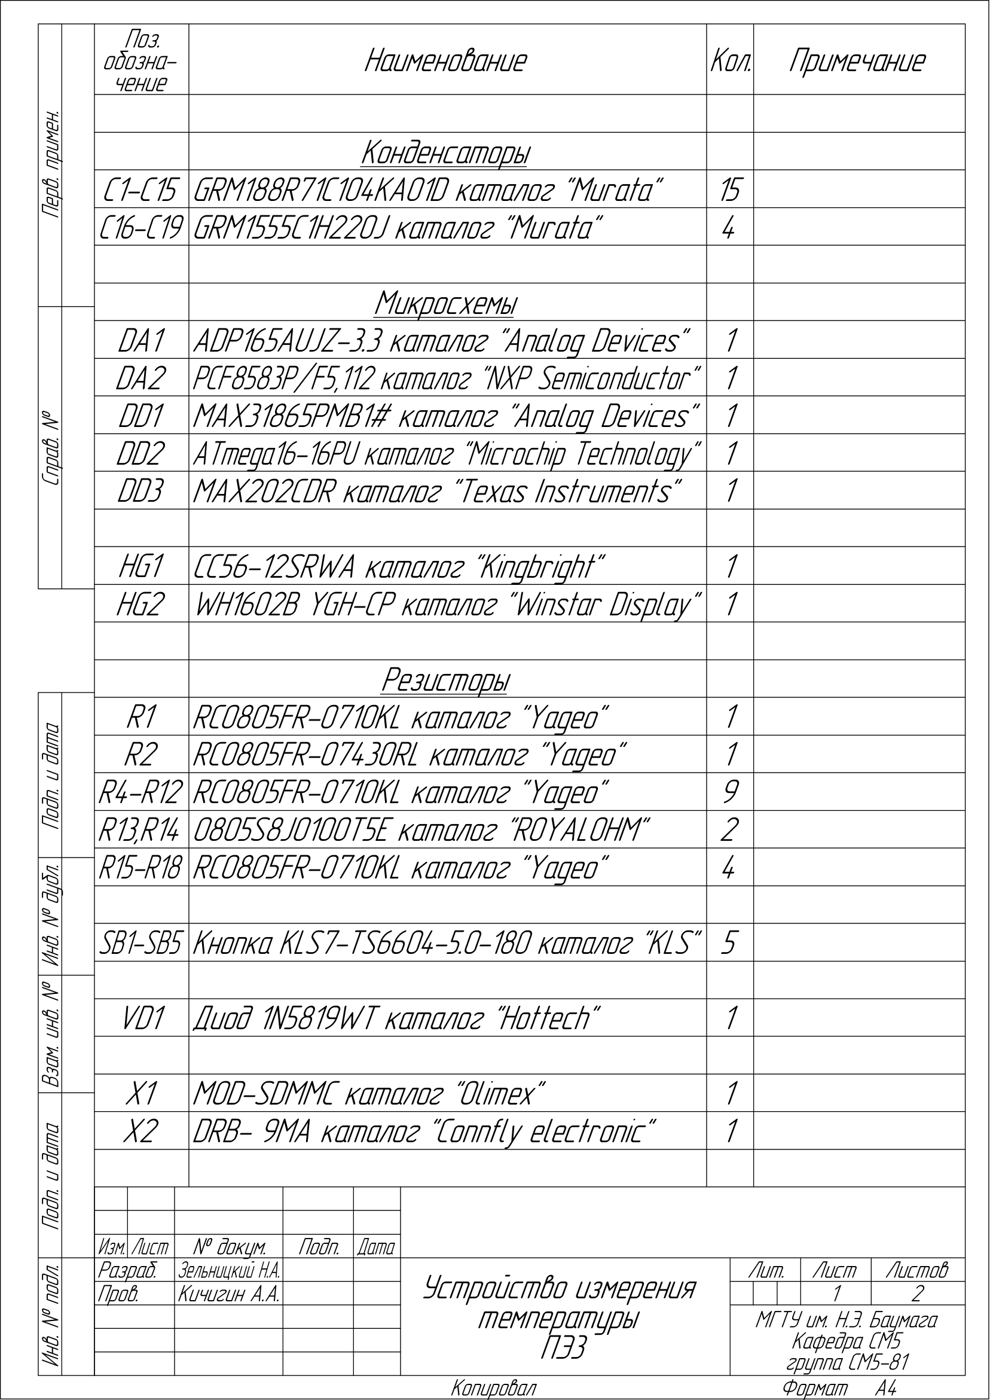
[picture p21: figure]

Рисунок А. 3 — Перечень элементов, лист 1

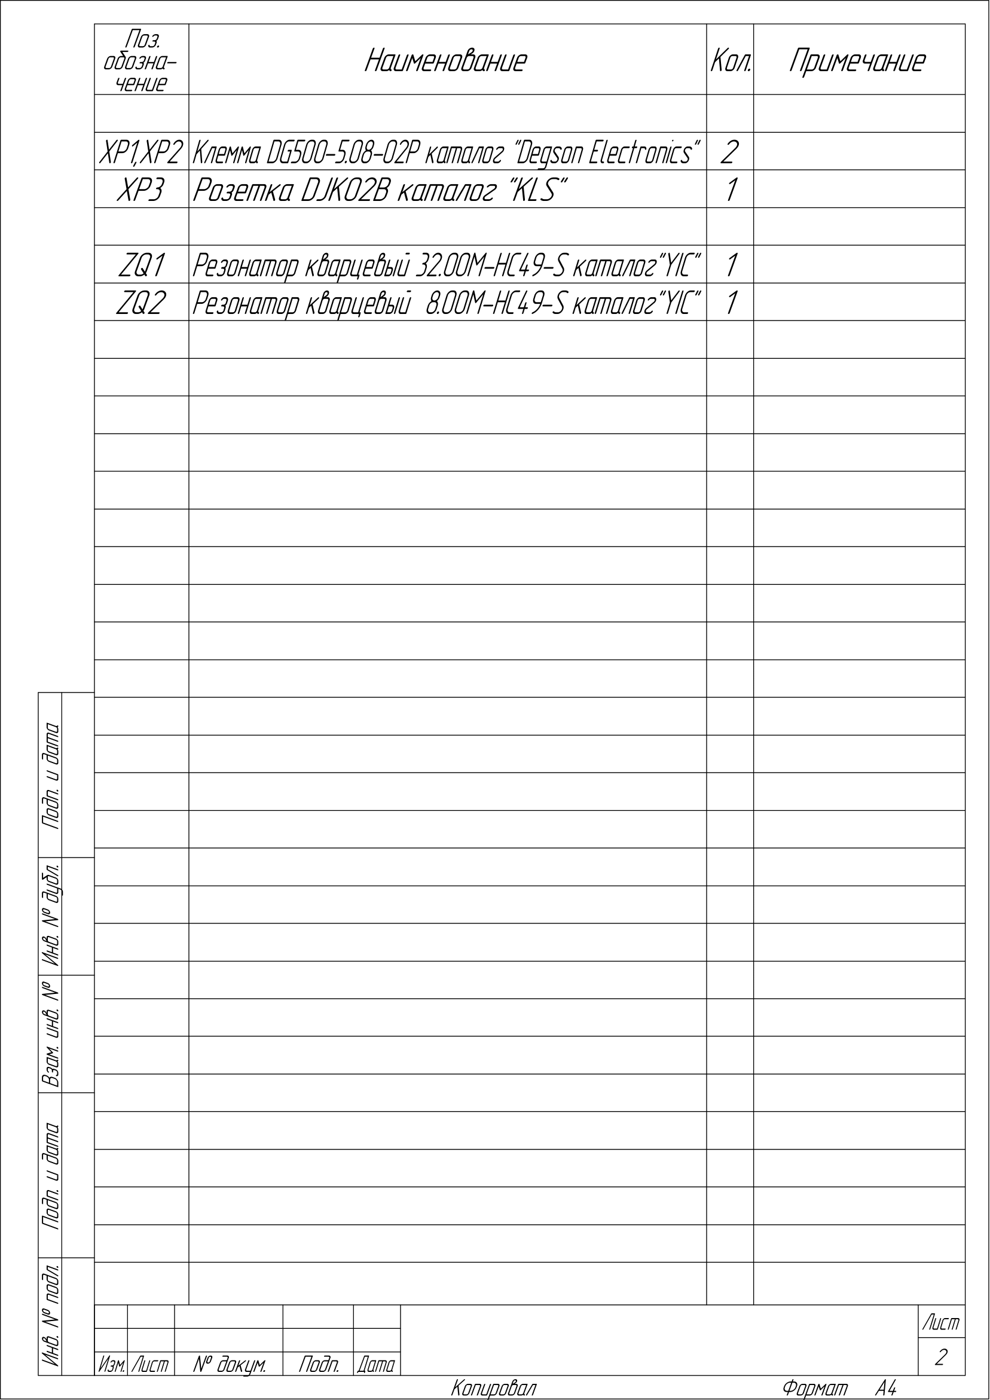
[picture p22: figure]

Рисунок А. 4 — Перечень элементов, лист 2

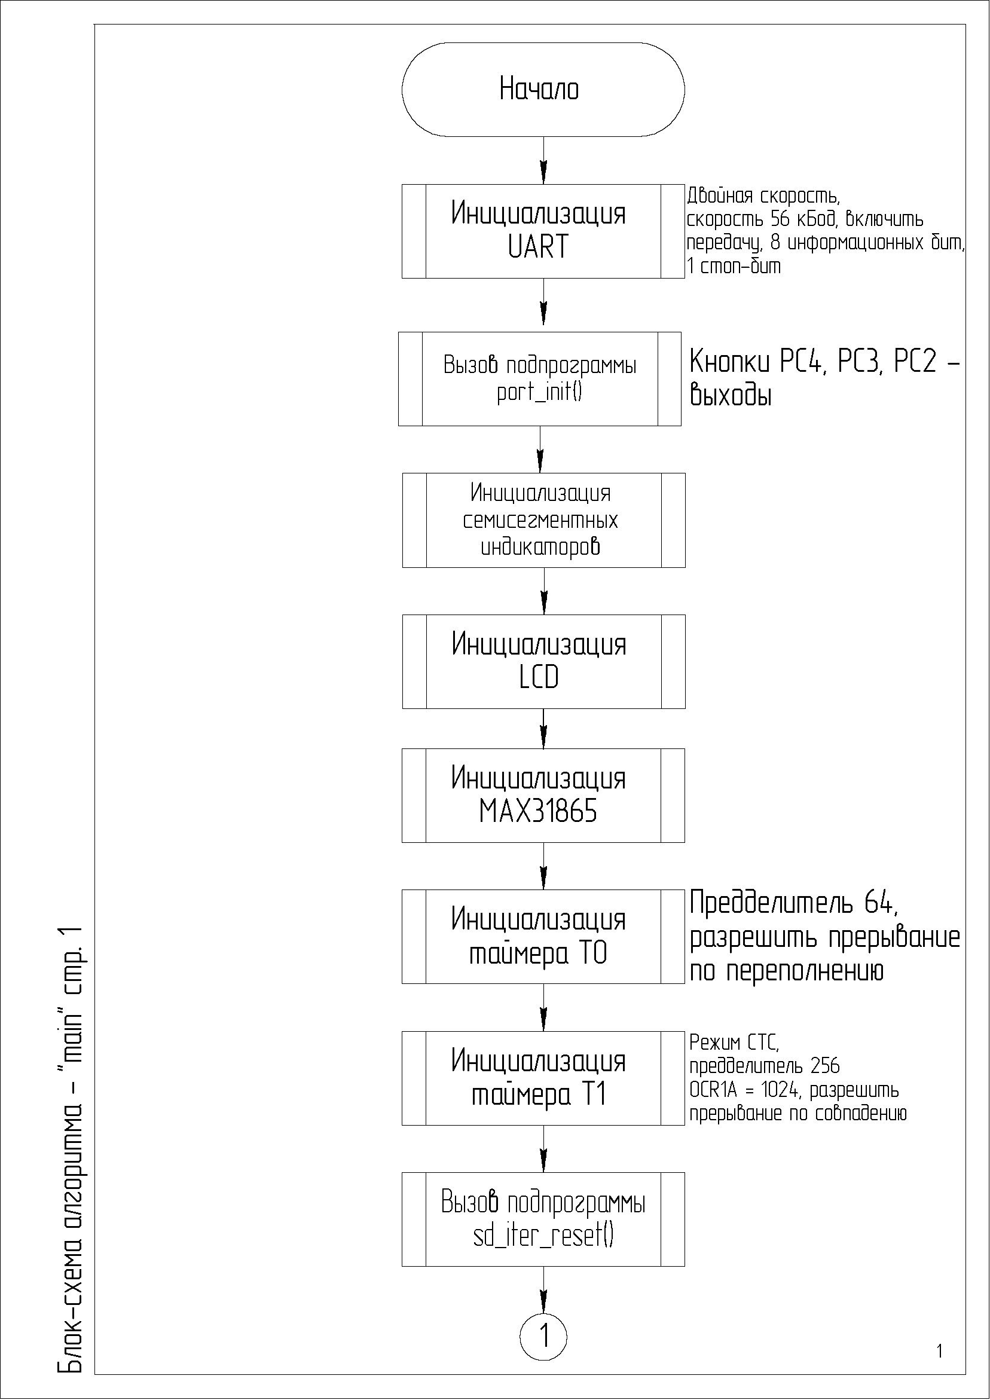
[picture p23: figure]

Рисунок А. 5 — Блок схема алгоритма, лист 1

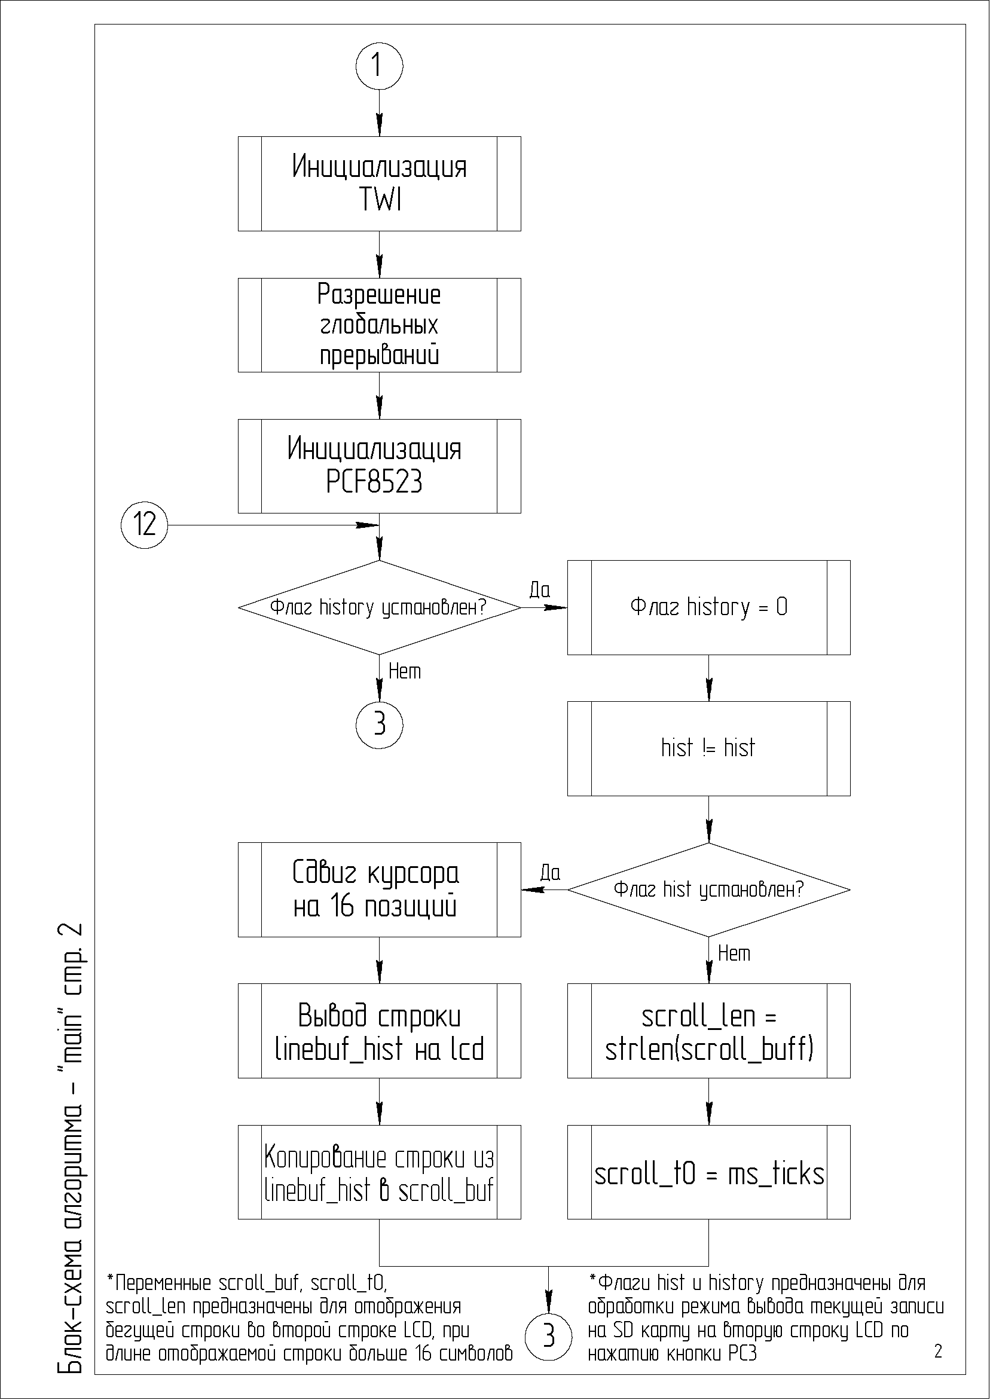
[picture p24: figure]

Рисунок А. 6 — Блок схема алгоритма, лист 2

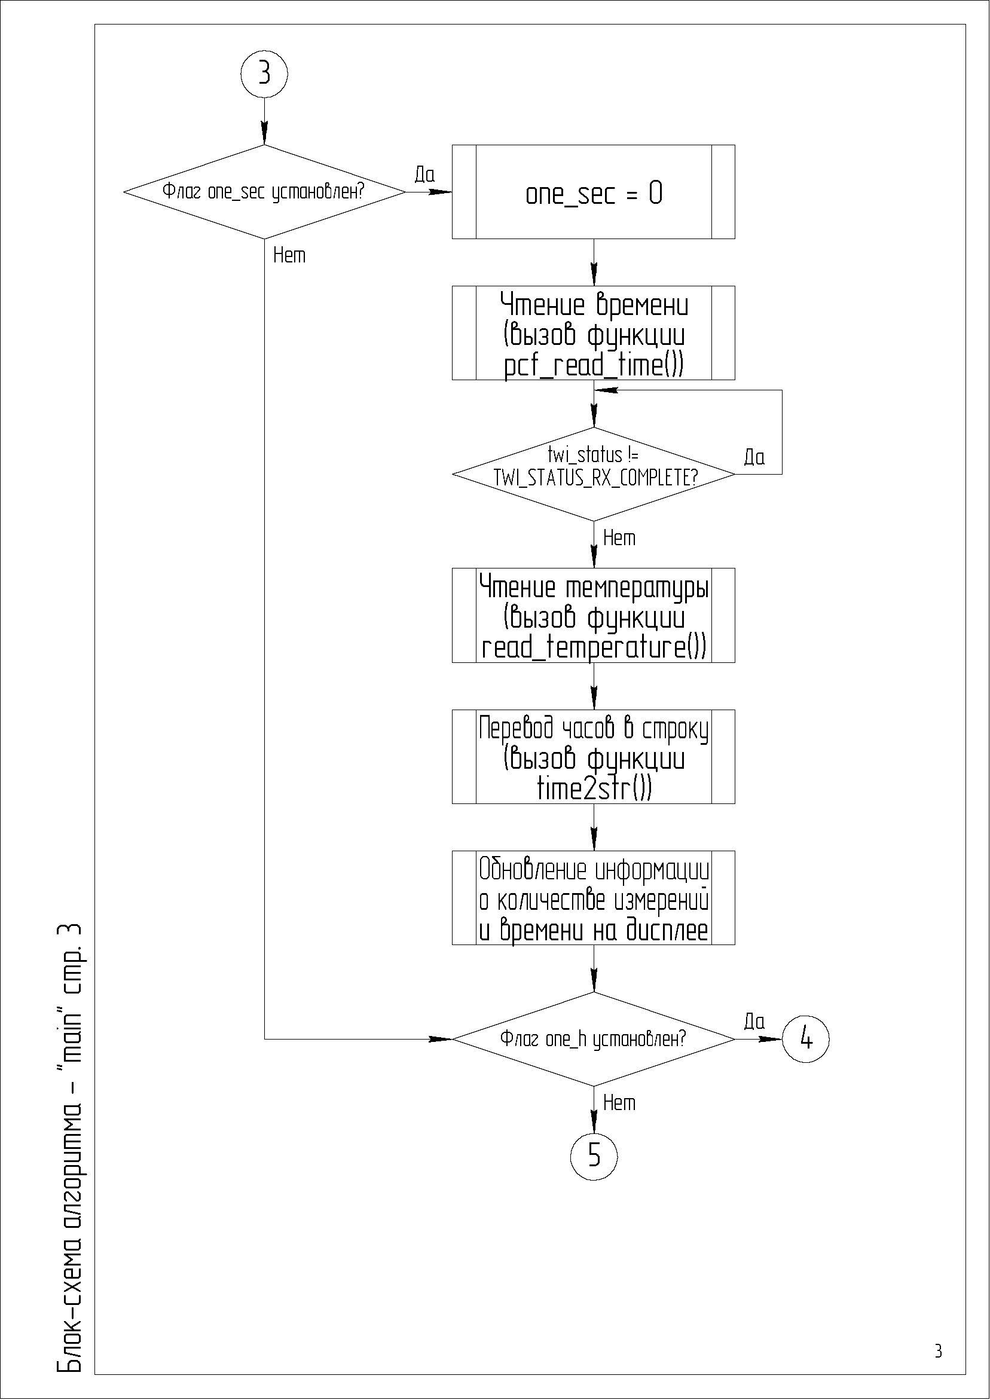
[picture p25: figure]

Рисунок А. 7 — Блок схема алгоритма, лист 3

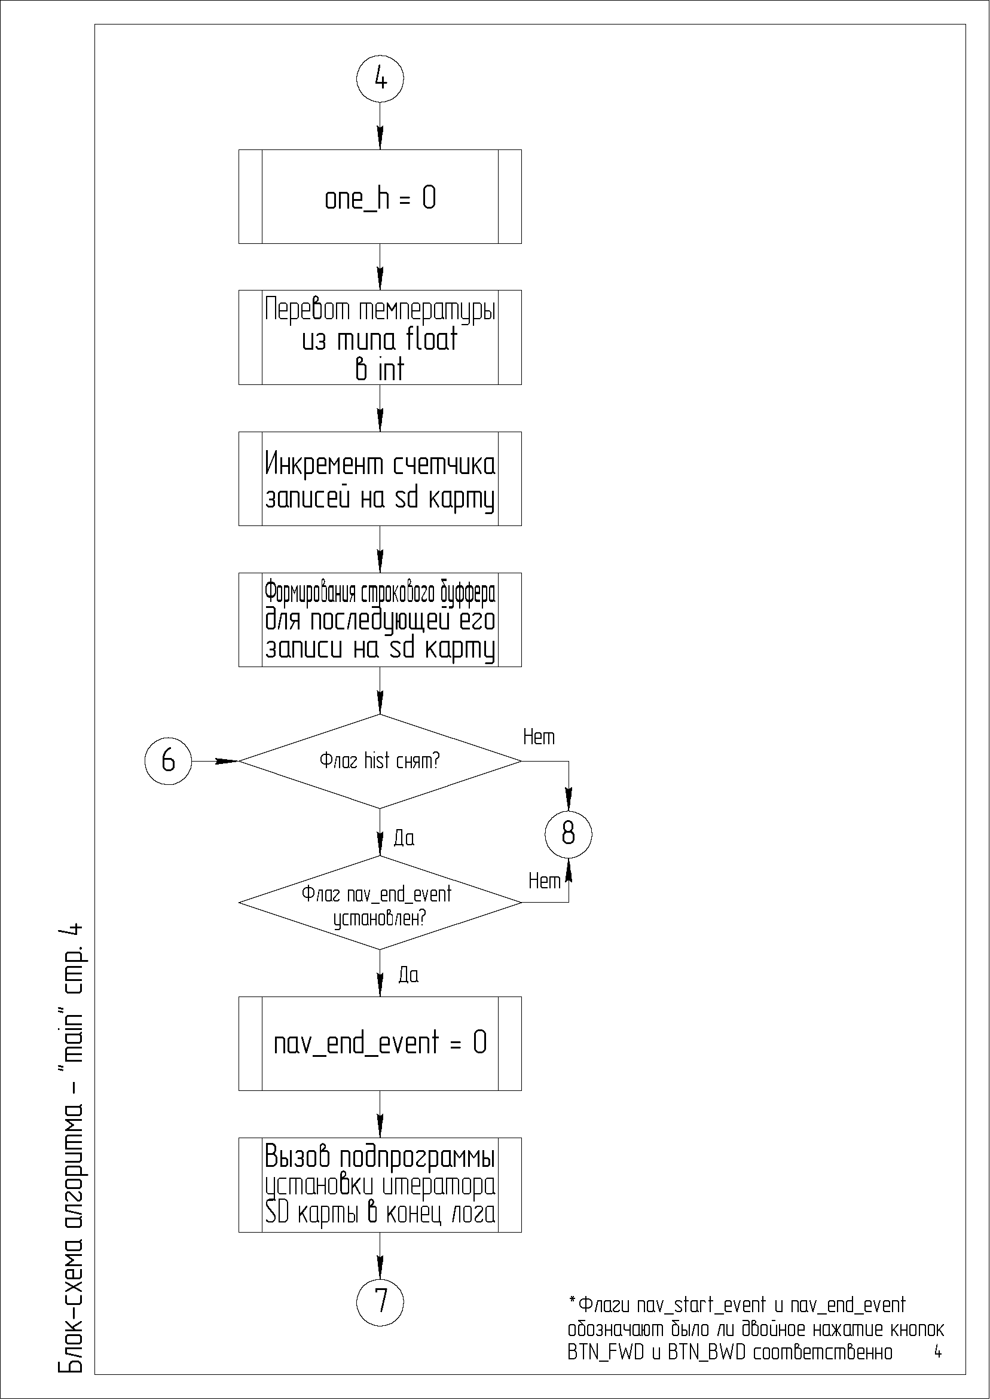
[picture p26: figure]

Рисунок А. 8 — Блок схема алгоритма, лист 4

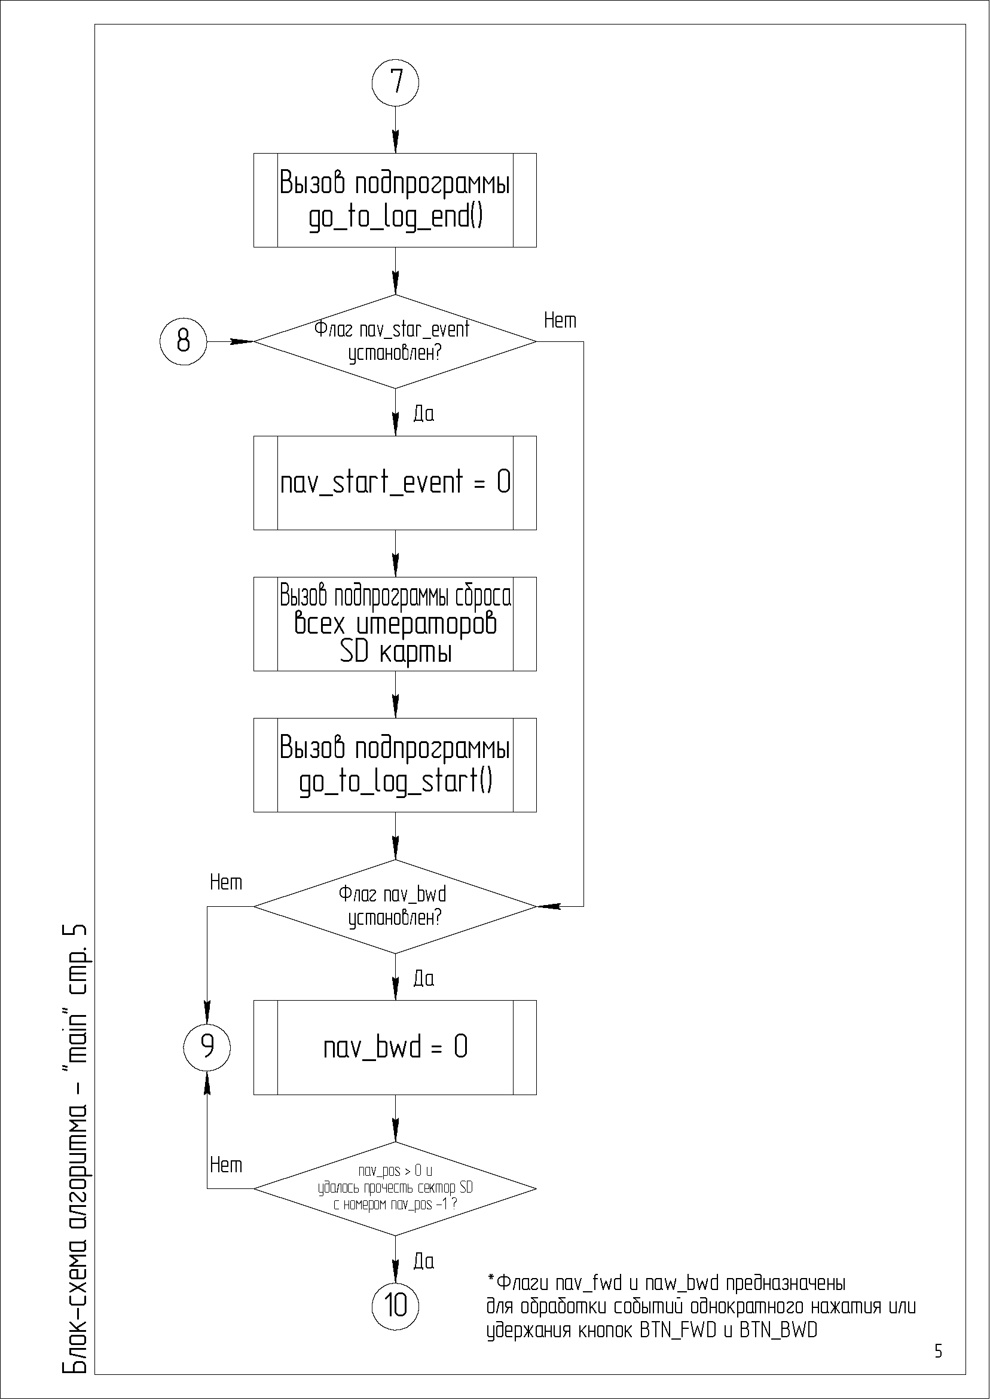
[picture p27: figure]

Рисунок А. 9 — Блок схема алгоритма, лист 5

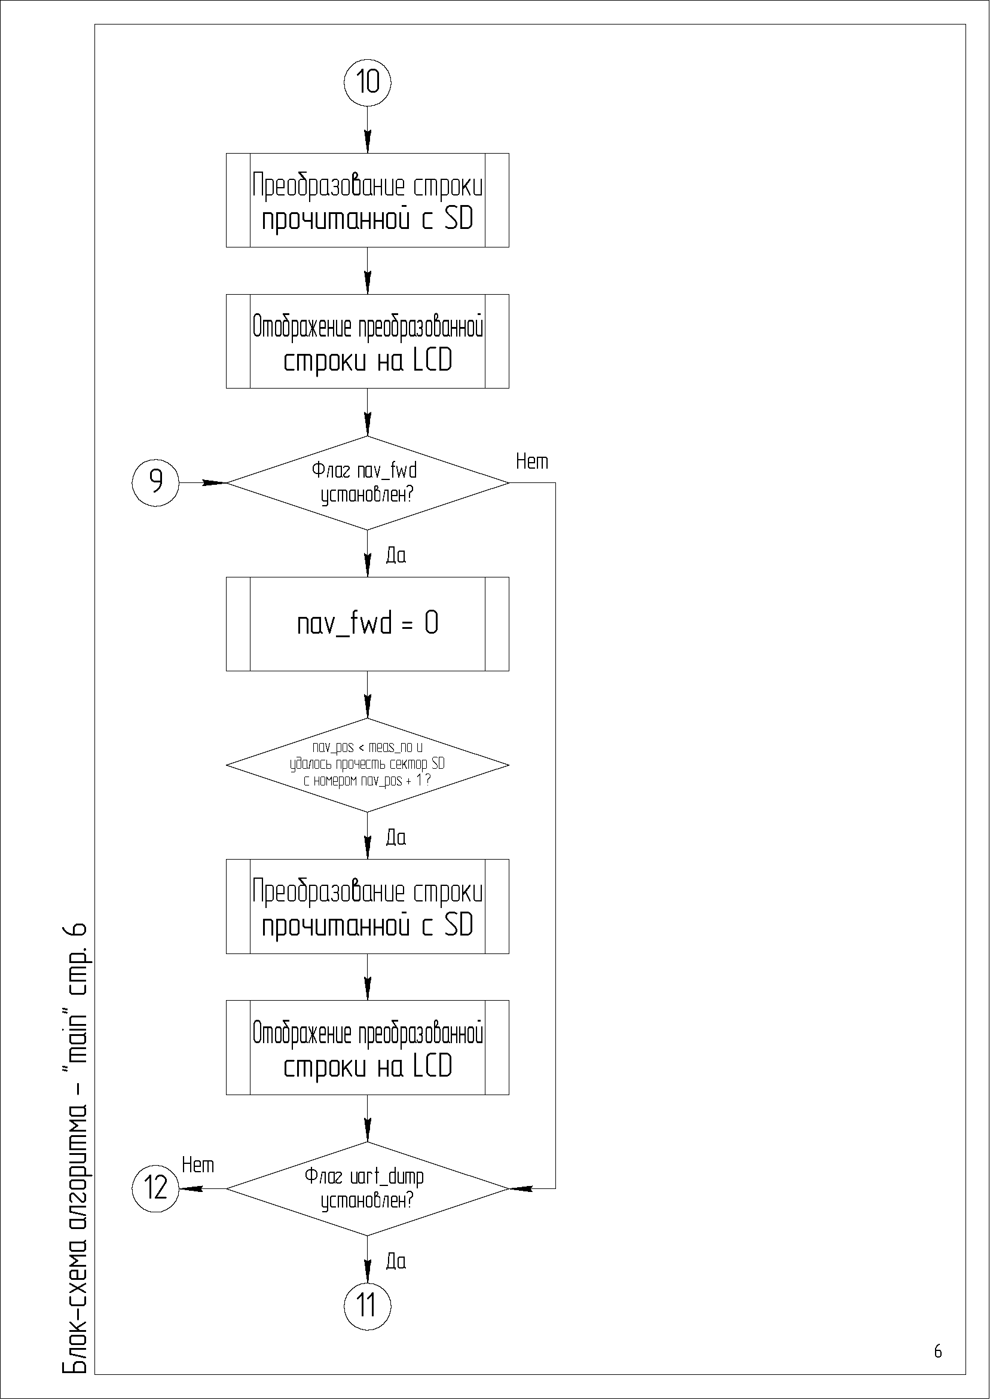
[picture p28: figure]

Рисунок А. 10 — Блок схема алгоритма, лист 6

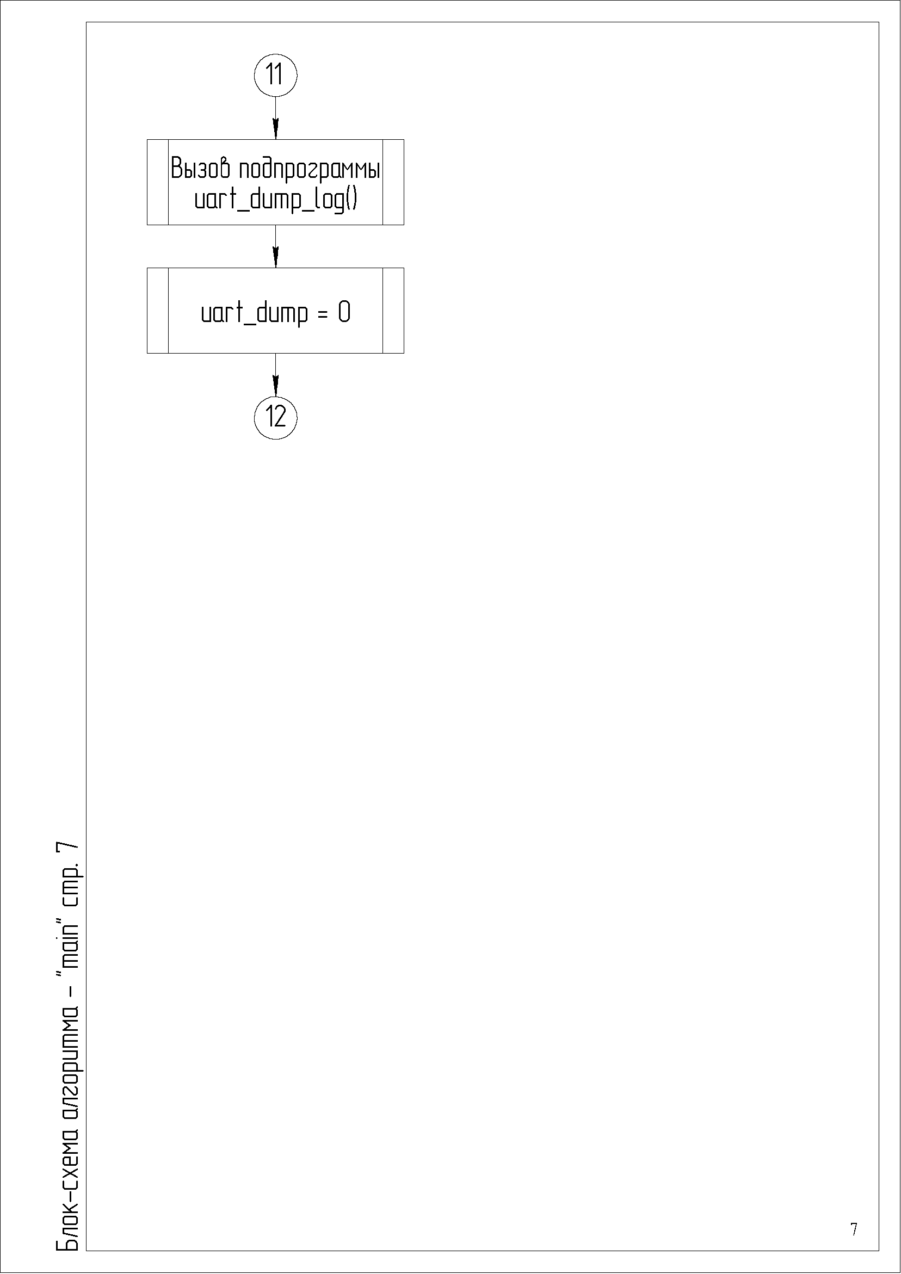
[picture p29: figure]

Рисунок А. 11 — Блок схема алгоритма, лист 7

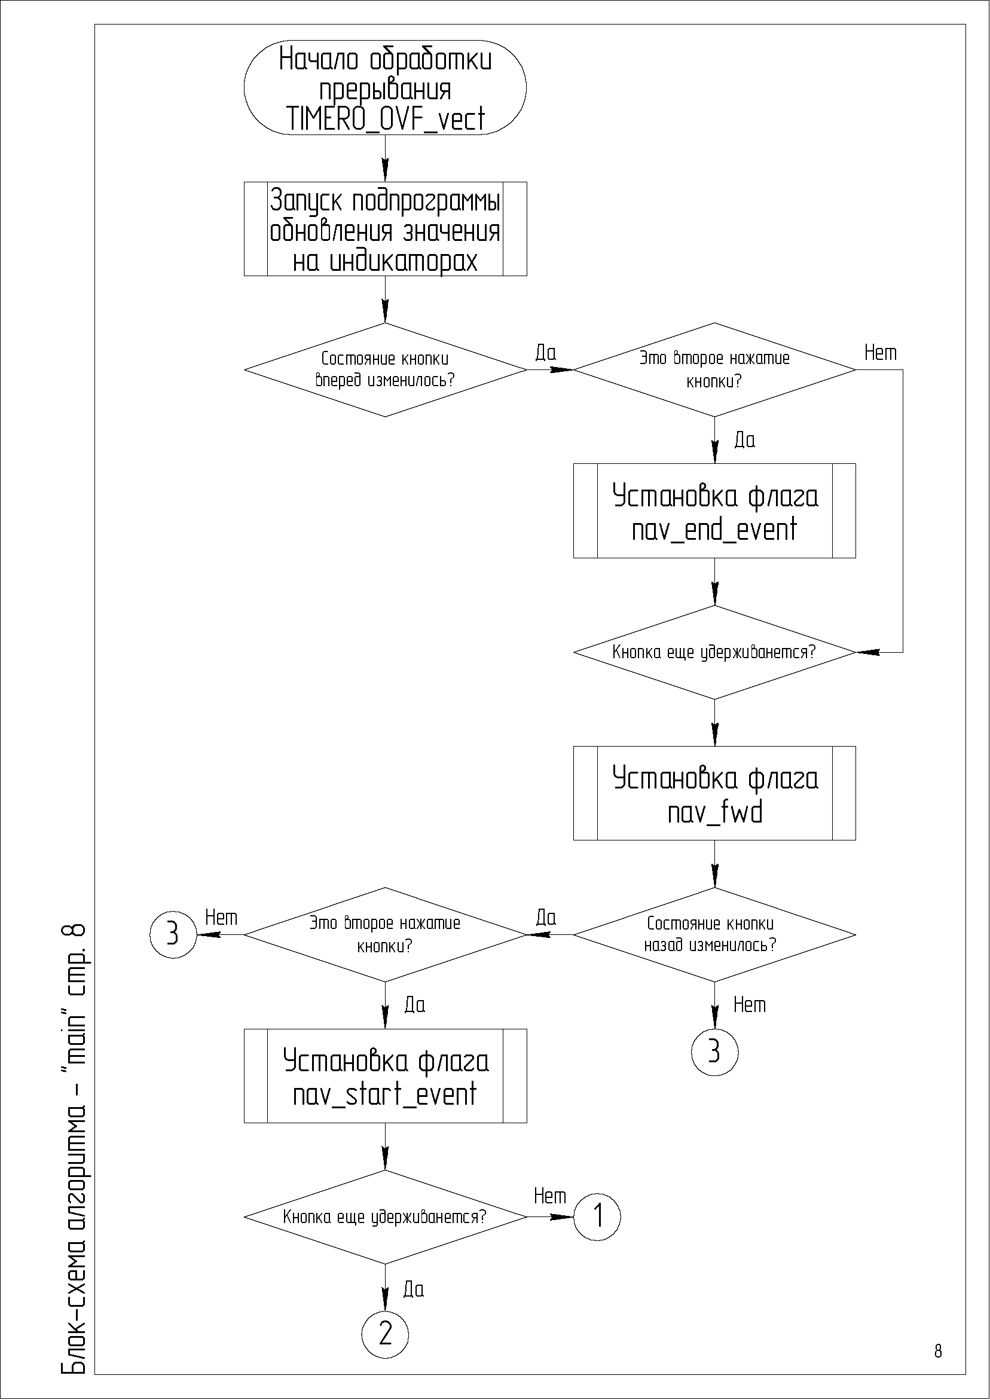
[picture p30: figure]

Рисунок А. 12 — Блок схема алгоритма, лист 8

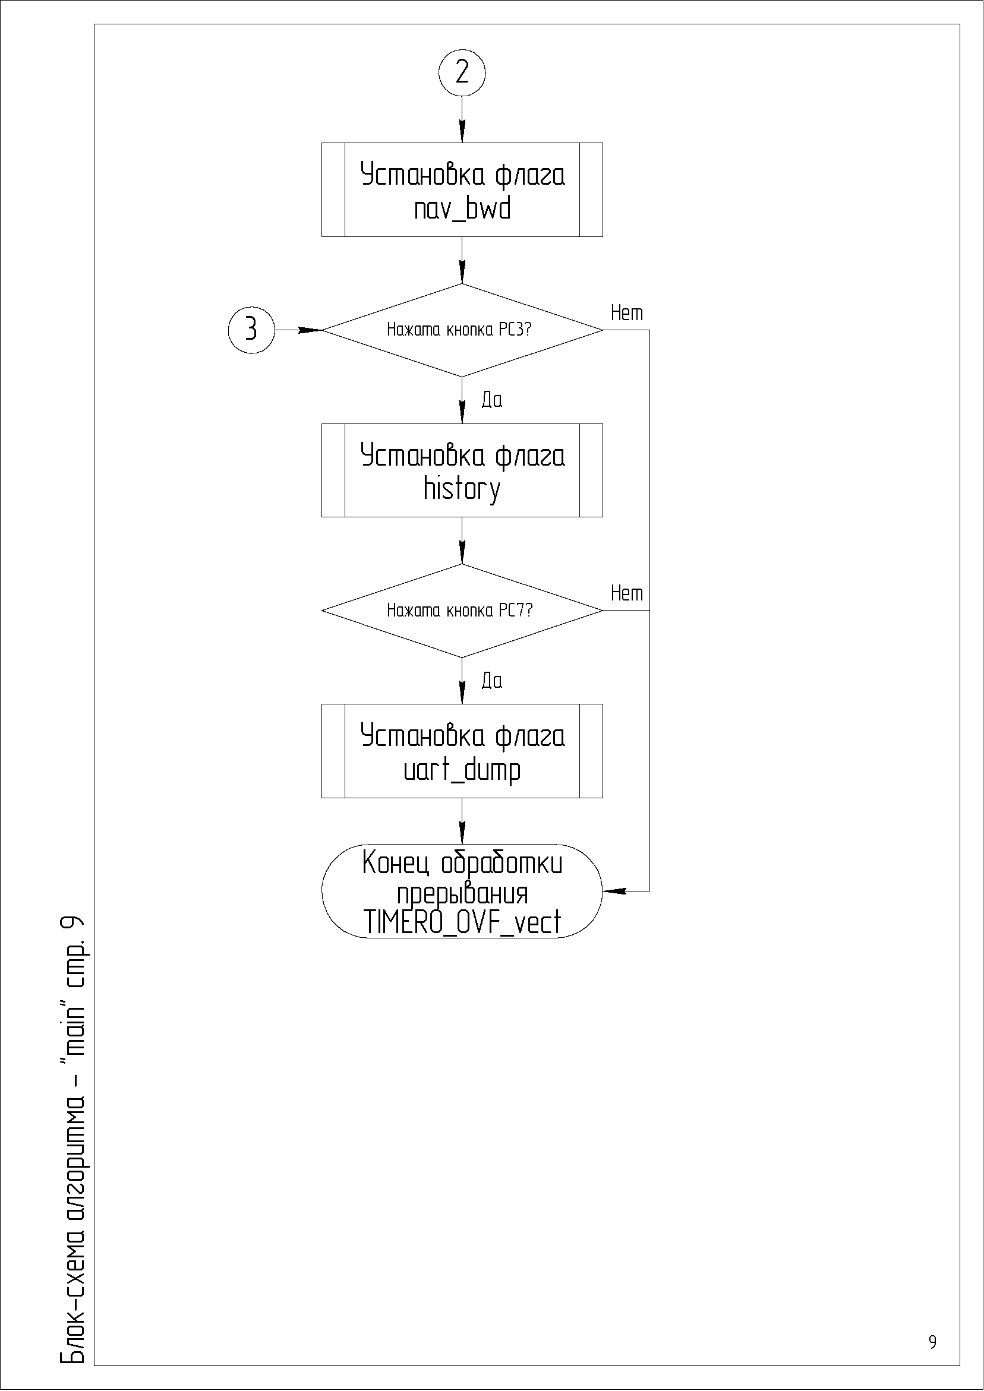
[picture p31: figure]

Рисунок А. 13 — Блок схема алгоритма, лист 9

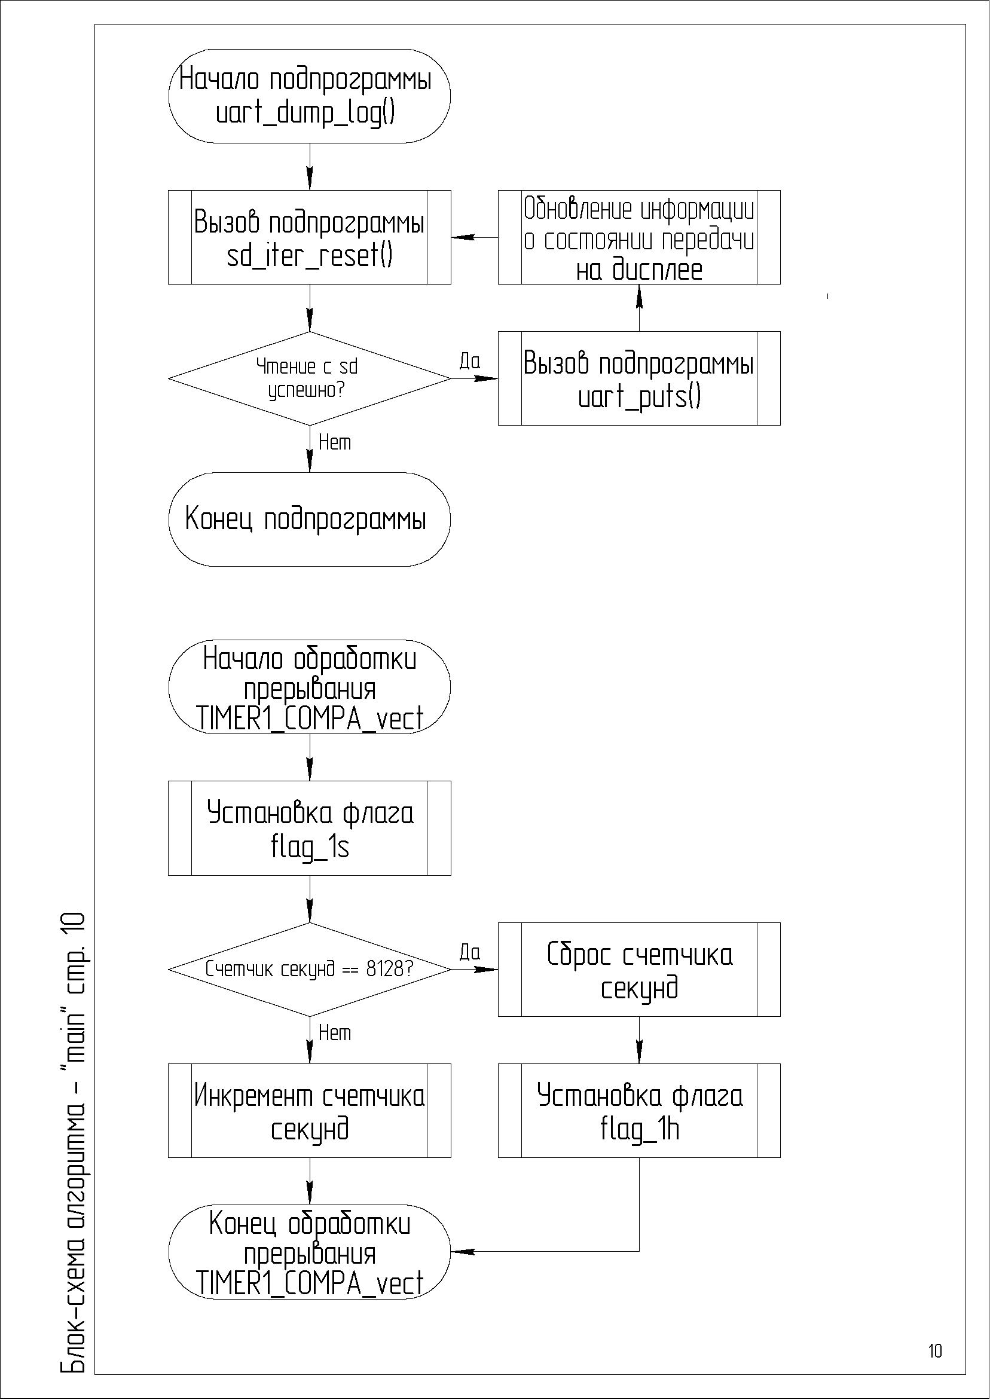
[picture p32: figure]

Рисунок А. 14 — Блок схема алгоритма, лист 10

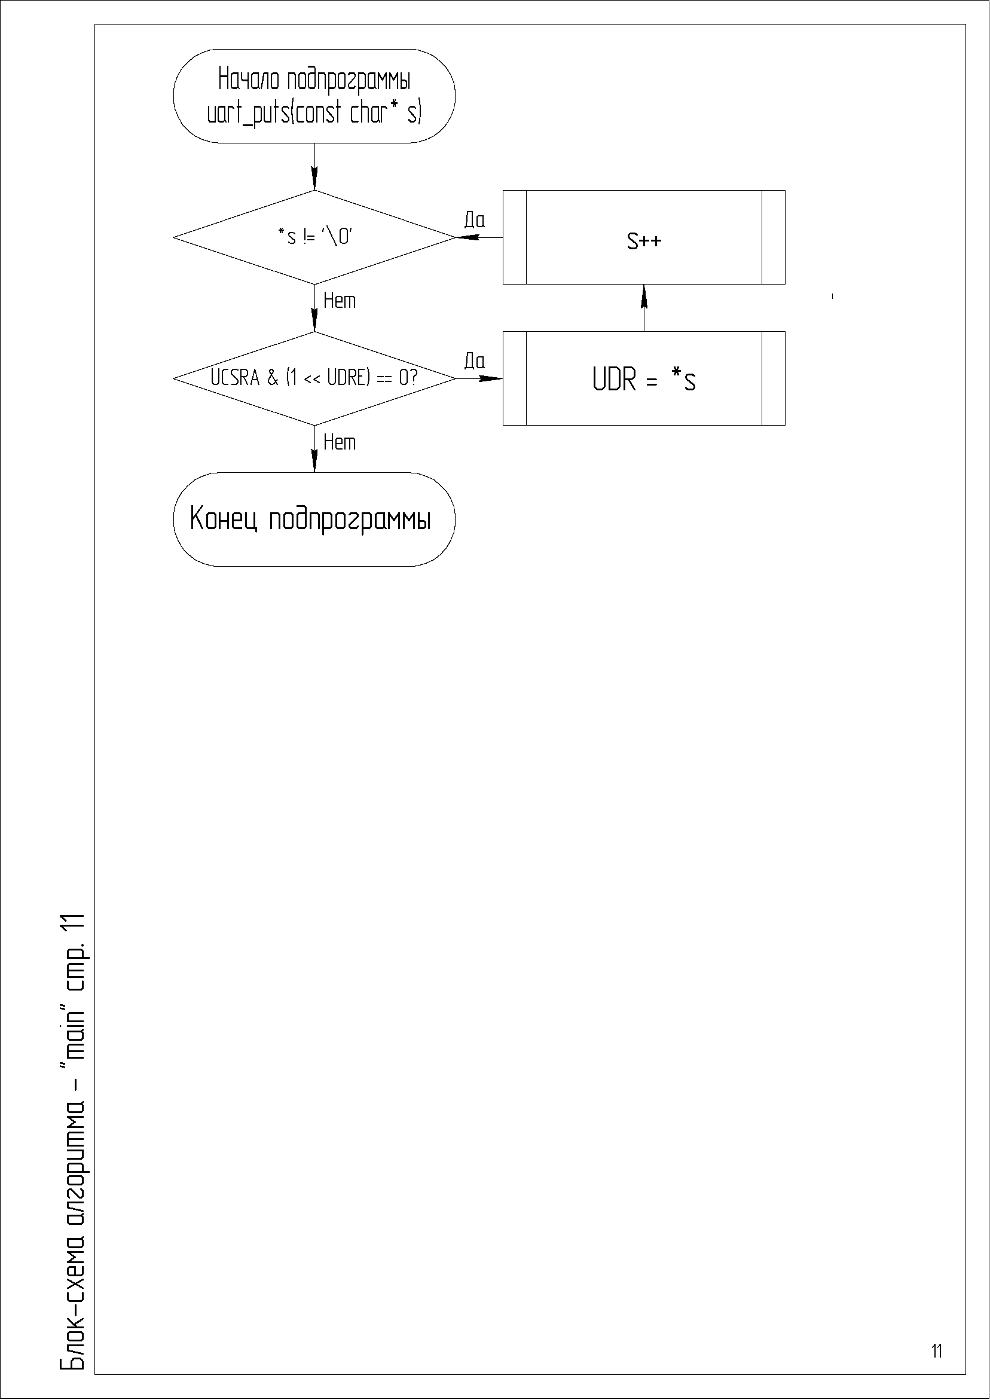
[picture p33: figure]

Рисунок А. 15 — Блок схема алгоритма, лист 11

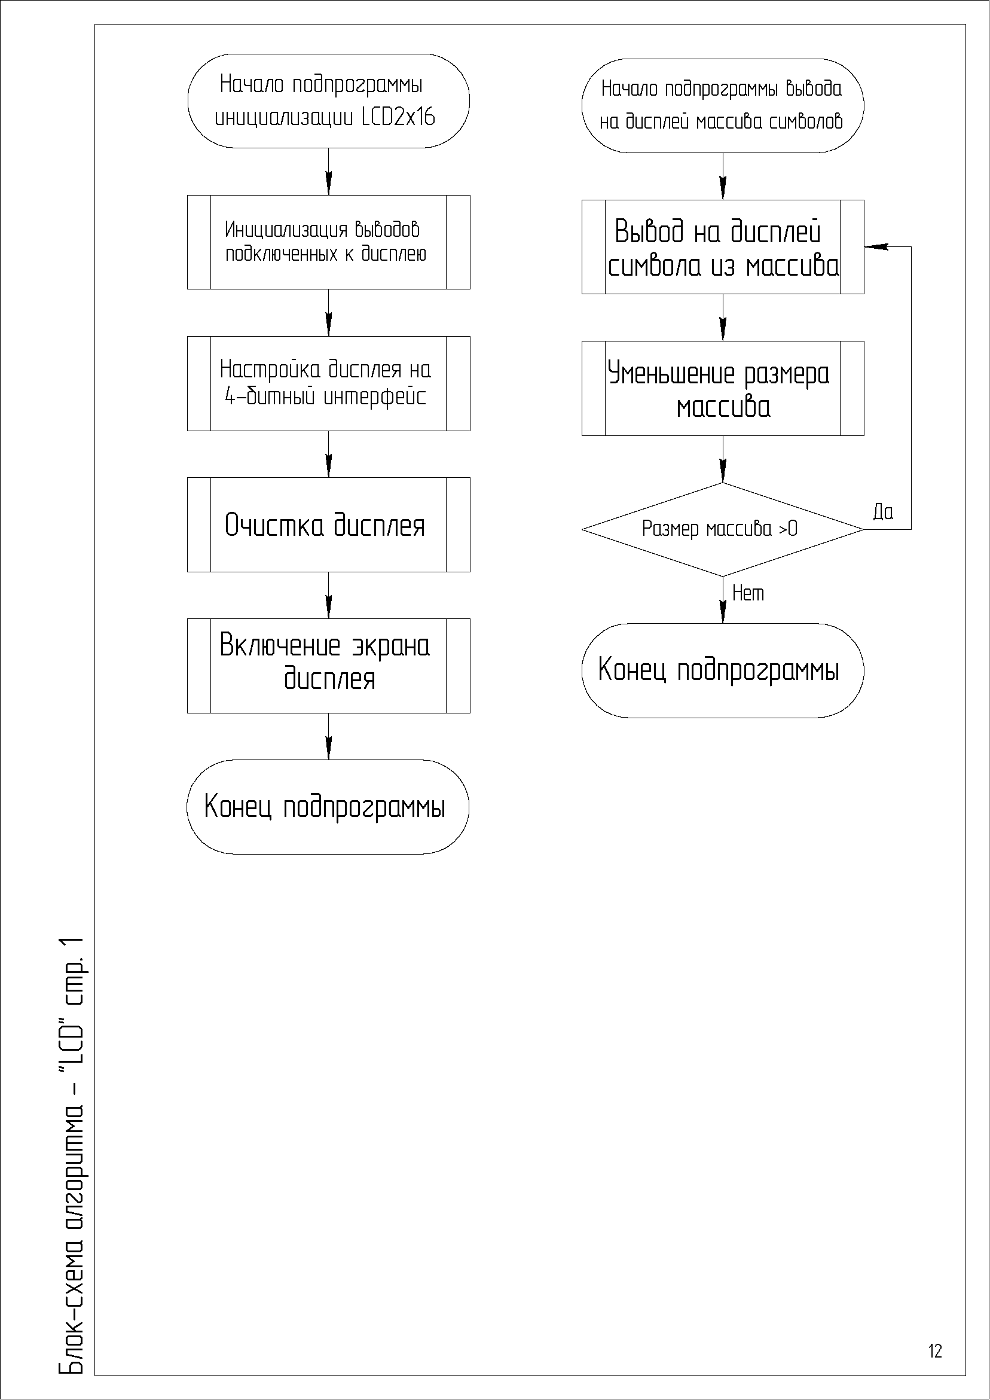
[picture p34: figure]

Рисунок А. 16 — Блок схема алгоритма, лист 12

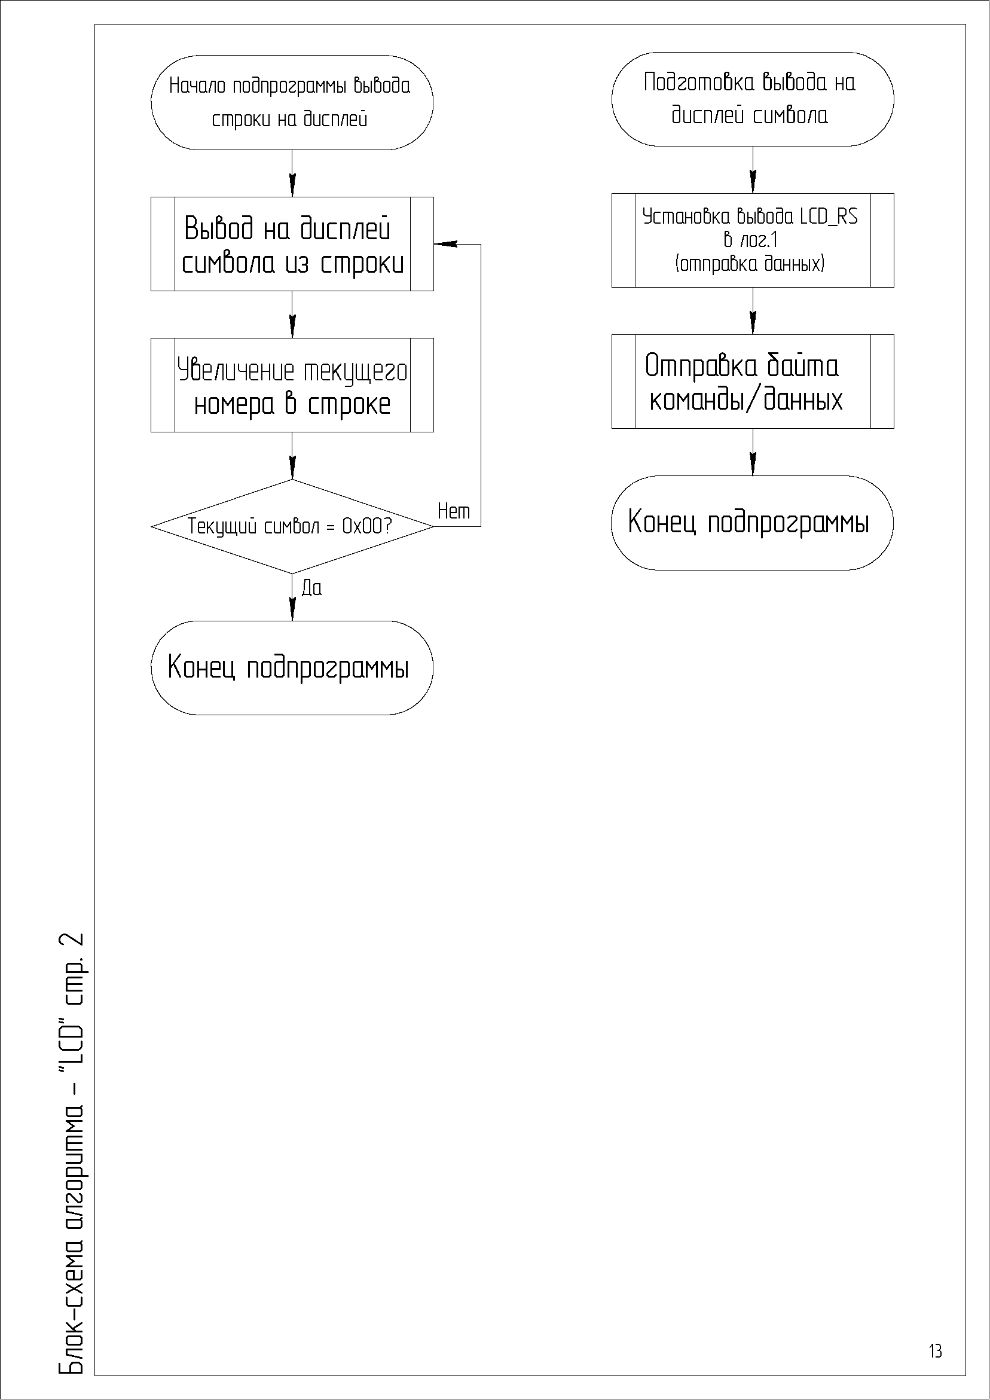
[picture p35: figure]

Рисунок А. 17 — Блок схема алгоритма, лист 13

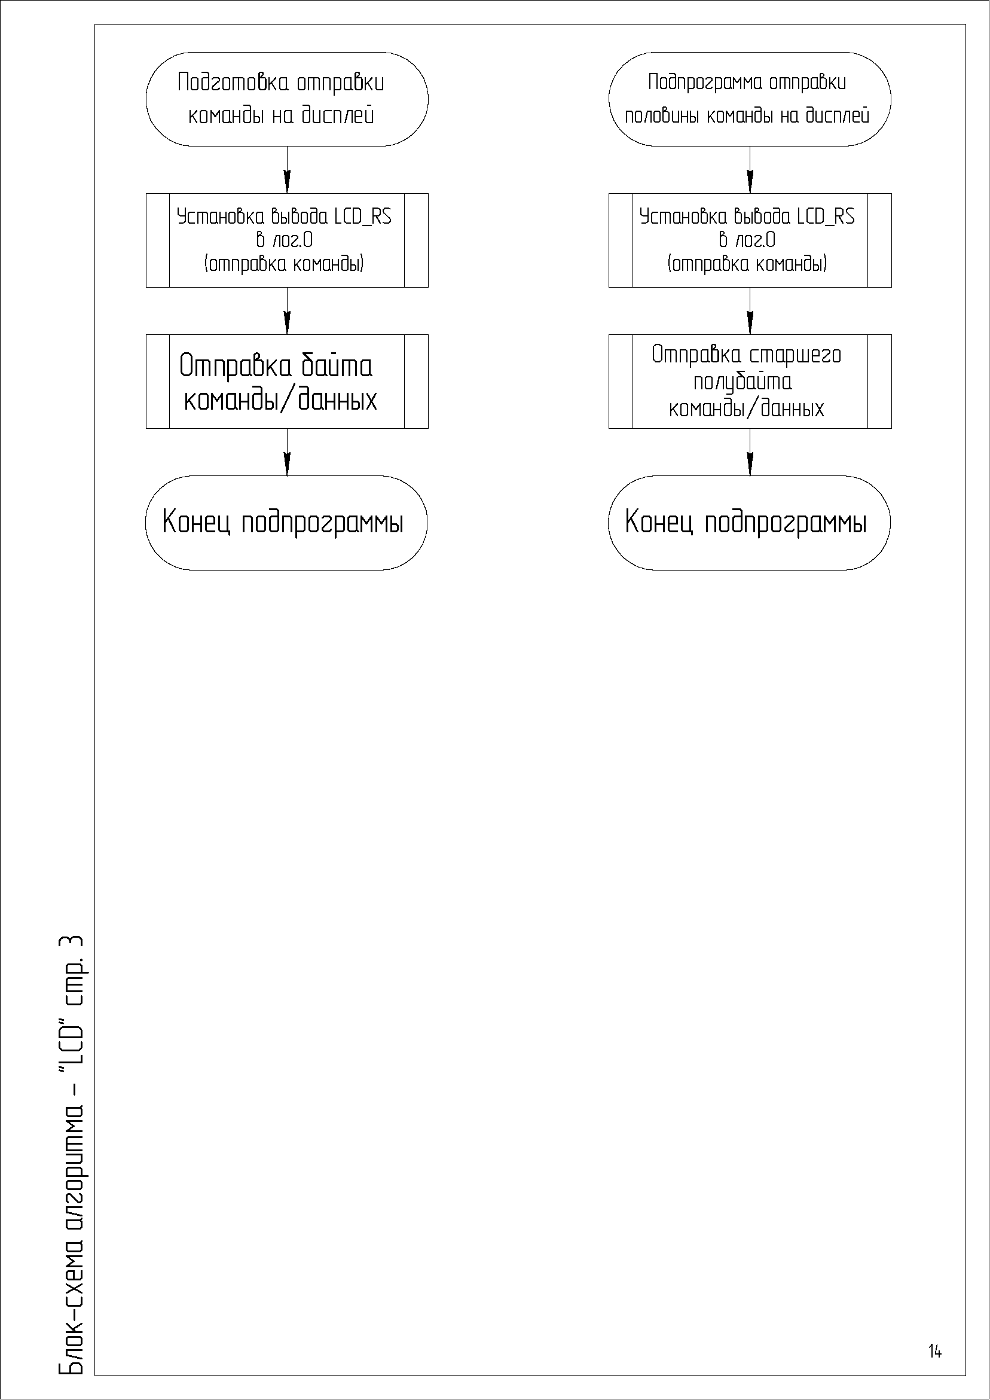
[picture p36: figure]

Рисунок А. 18 — Блок схема алгоритма, лист 14

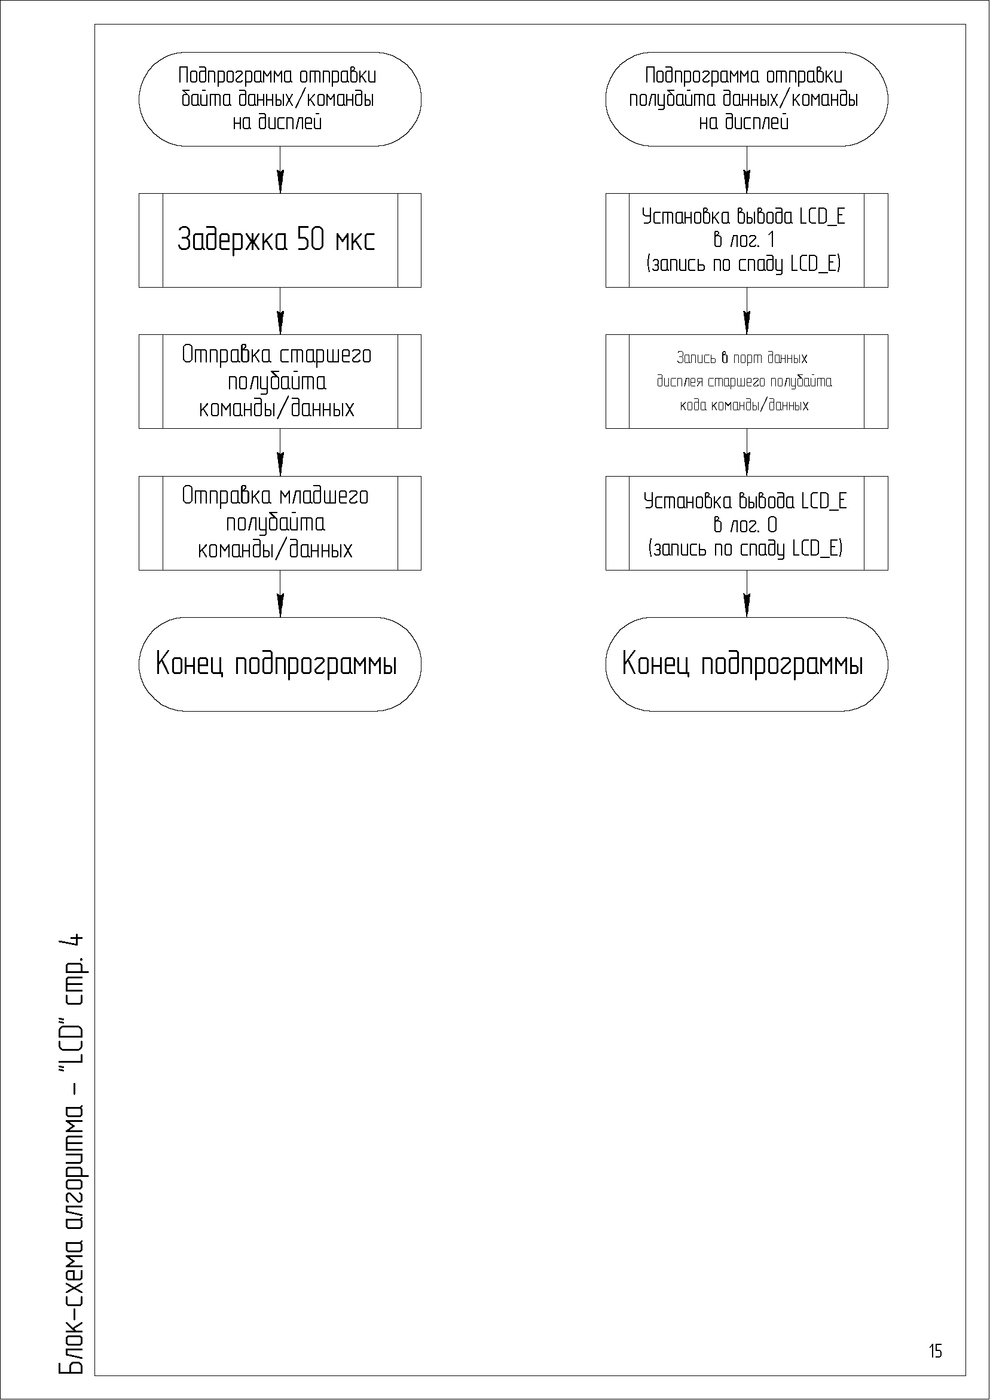
[picture p37: figure]

Рисунок А. 19 — Блок схема алгоритма, лист 15

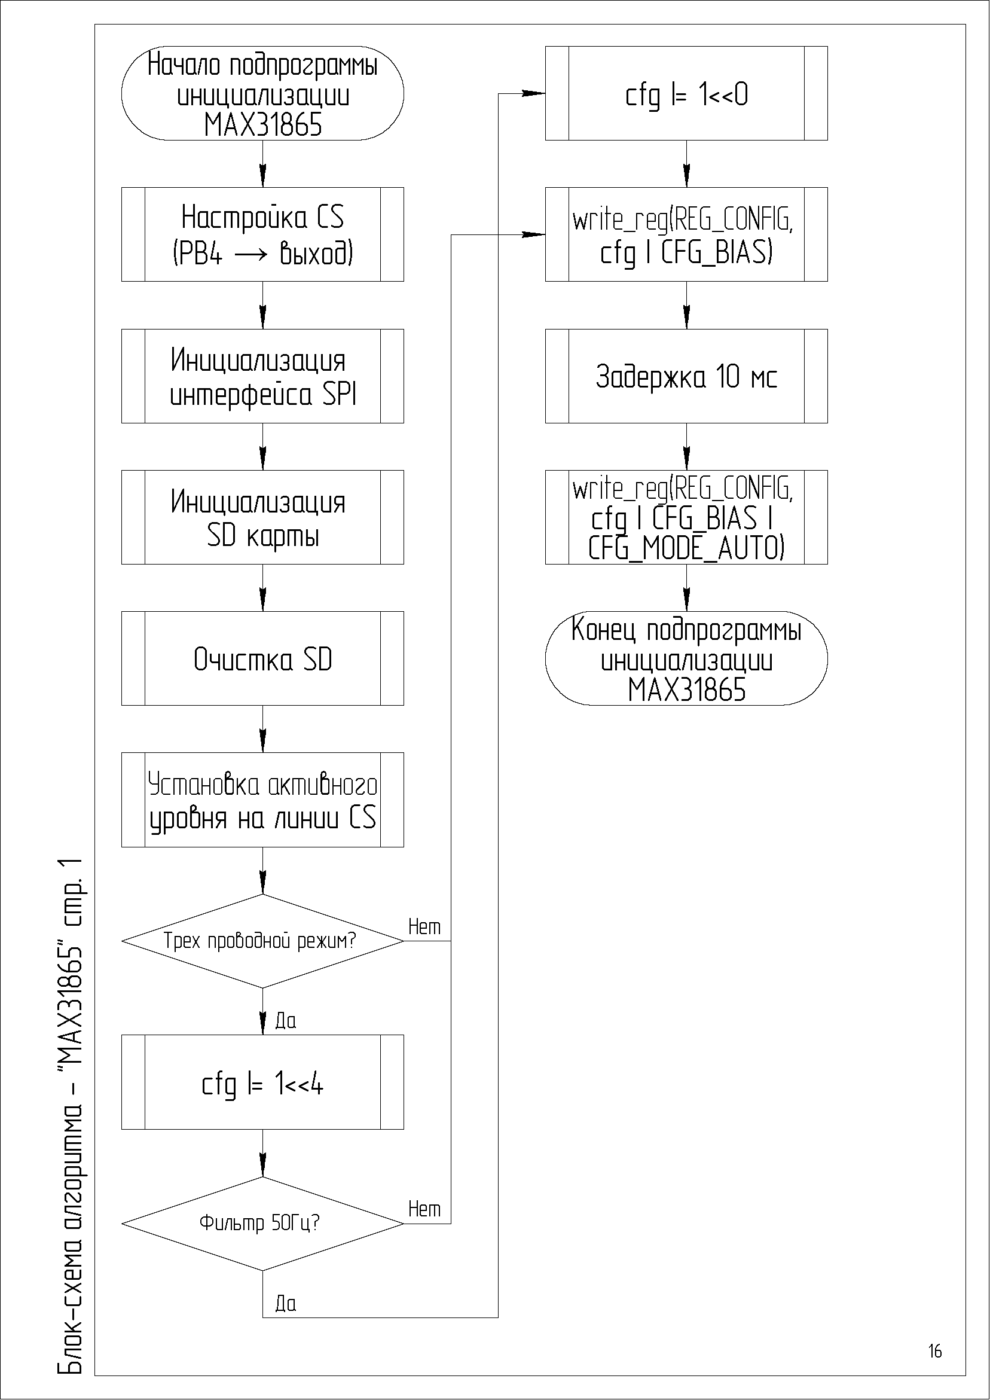
[picture p38: figure]

Рисунок А. 20 — Блок схема алгоритма, лист 16

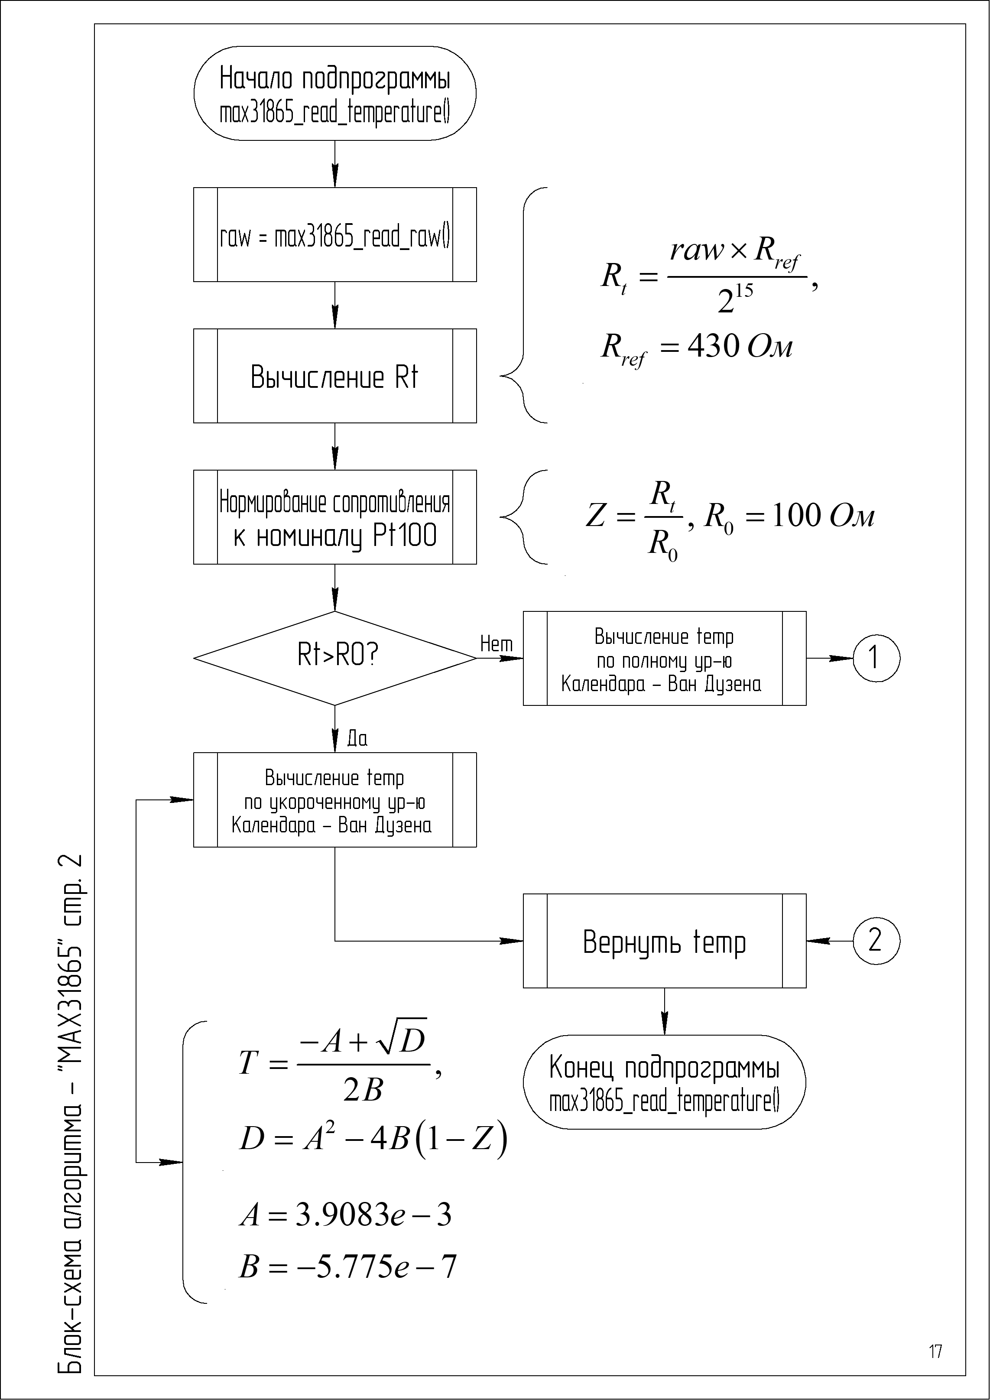
[picture p39: figure]

Рисунок А. 21 — Блок схема алгоритма, лист 17

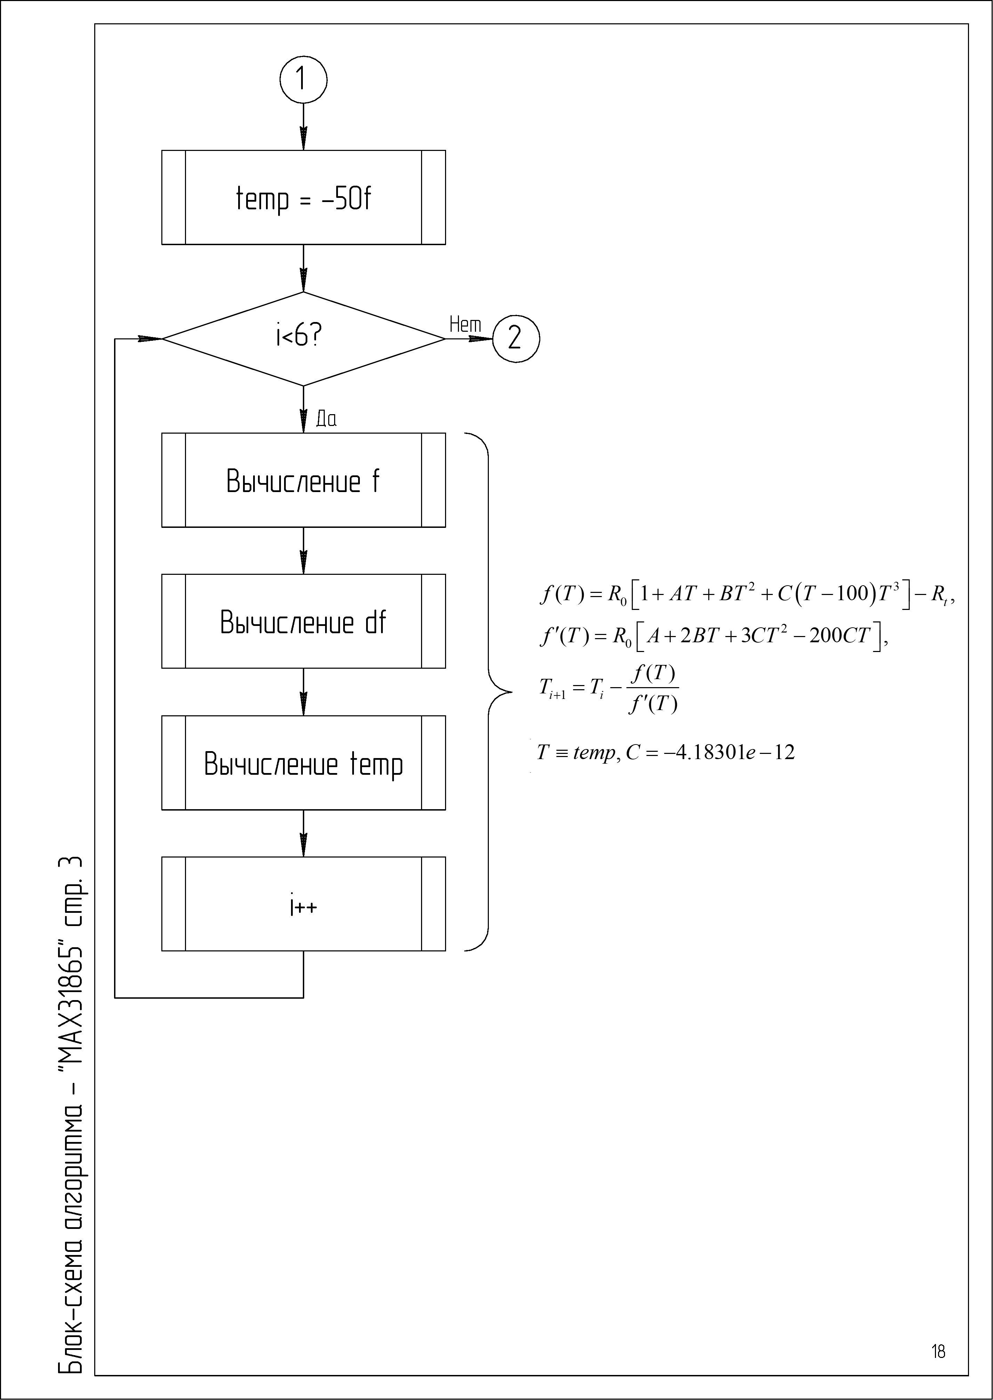
[picture p40: figure]

Рисунок А. 22 — Блок схема алгоритма, лист 18

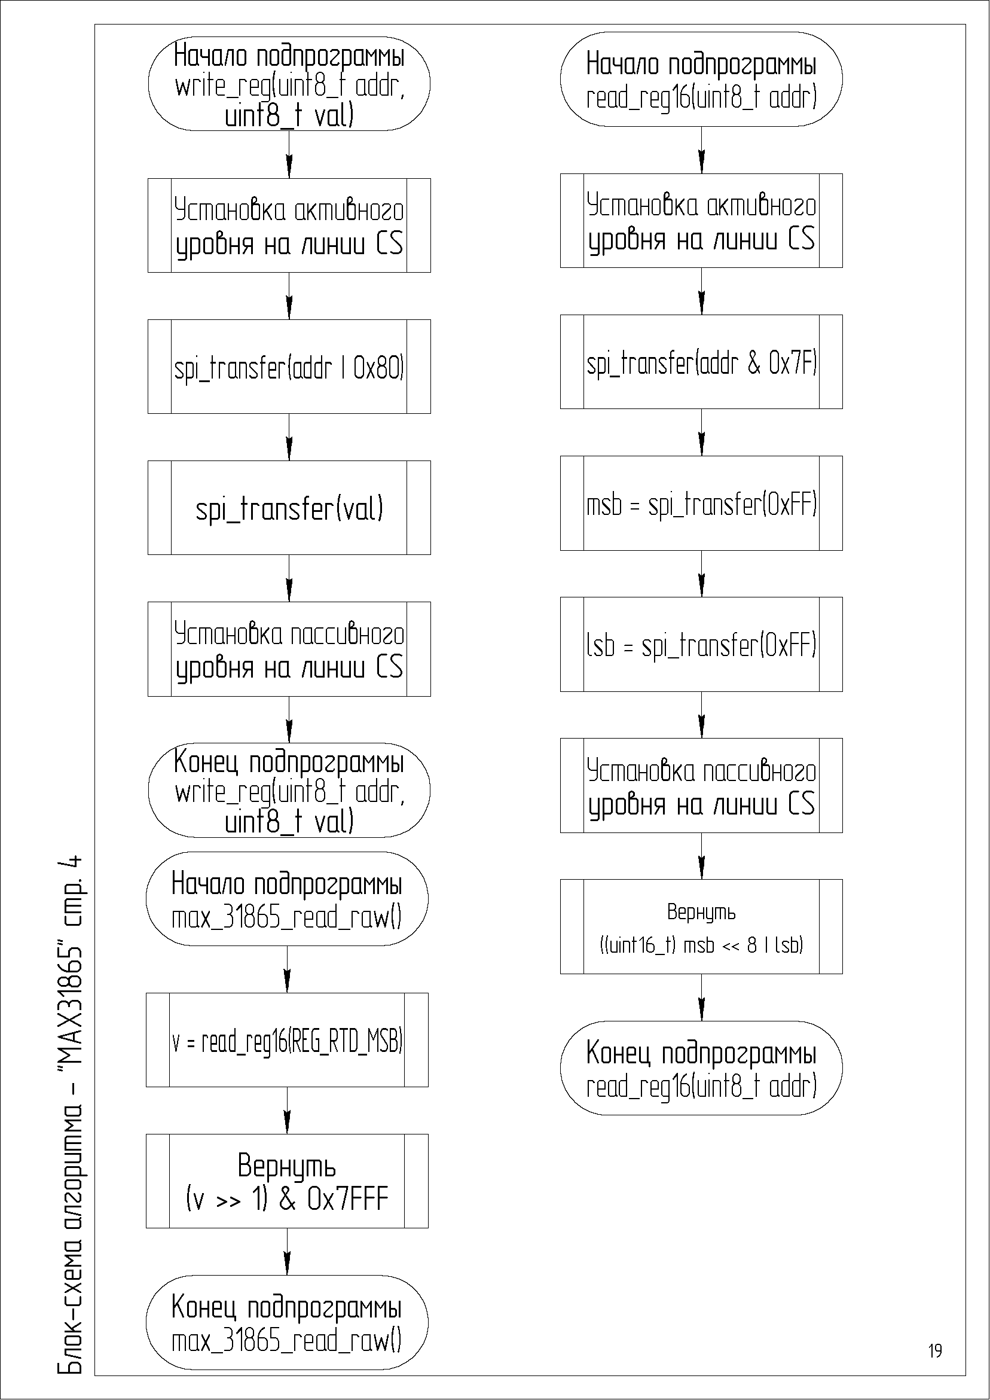
[picture p41: figure]

Рисунок А. 23 — Блок схема алгоритма, лист 19

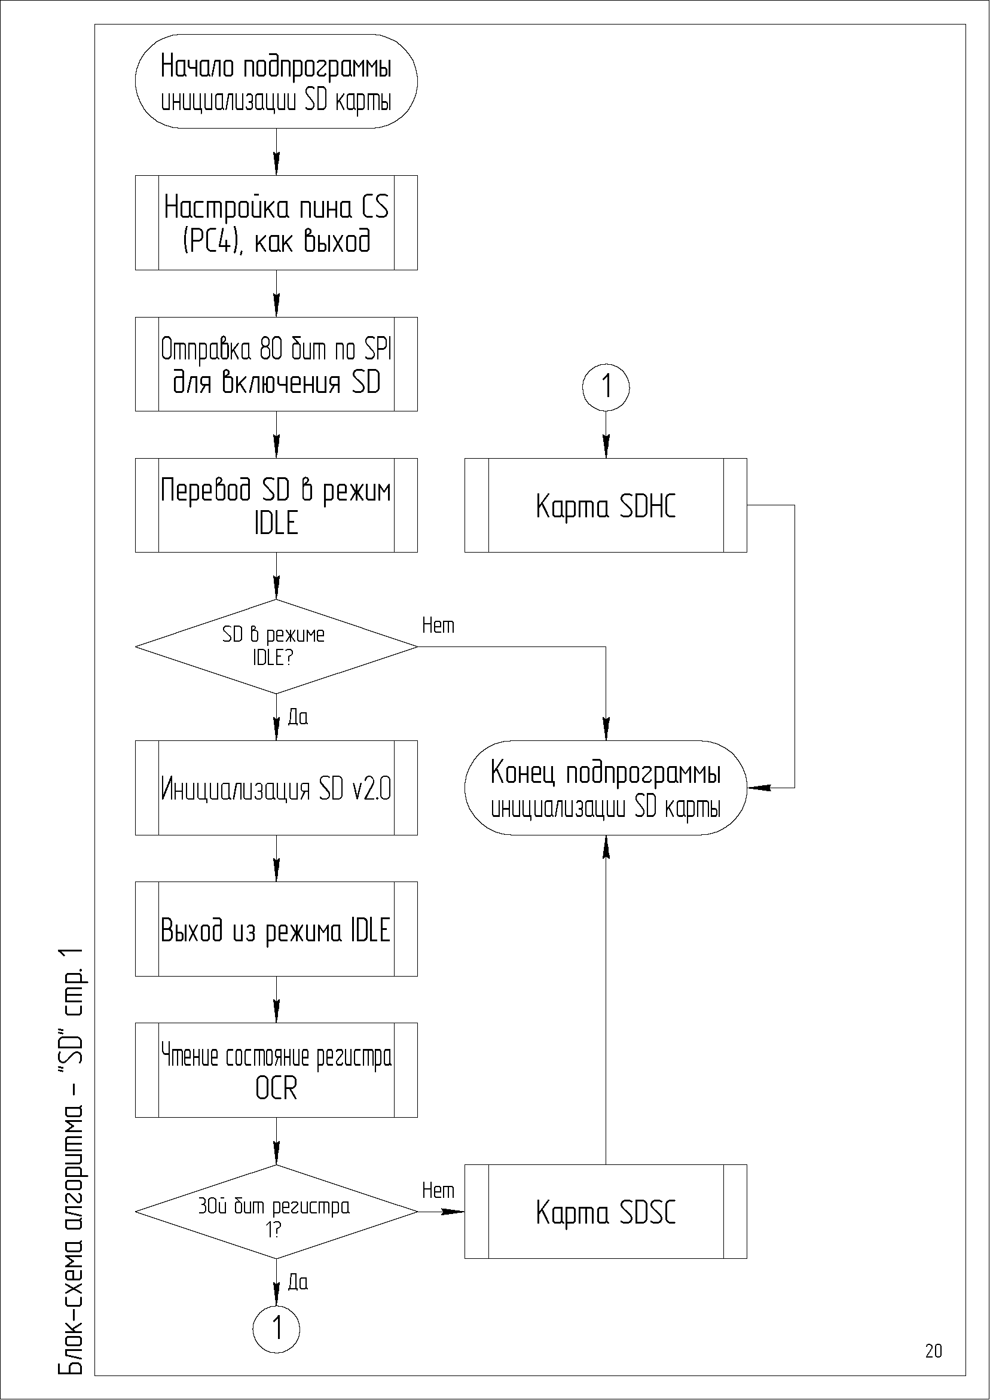
[picture p42: figure]

Рисунок А. 24 — Блок схема алгоритма, лист 20

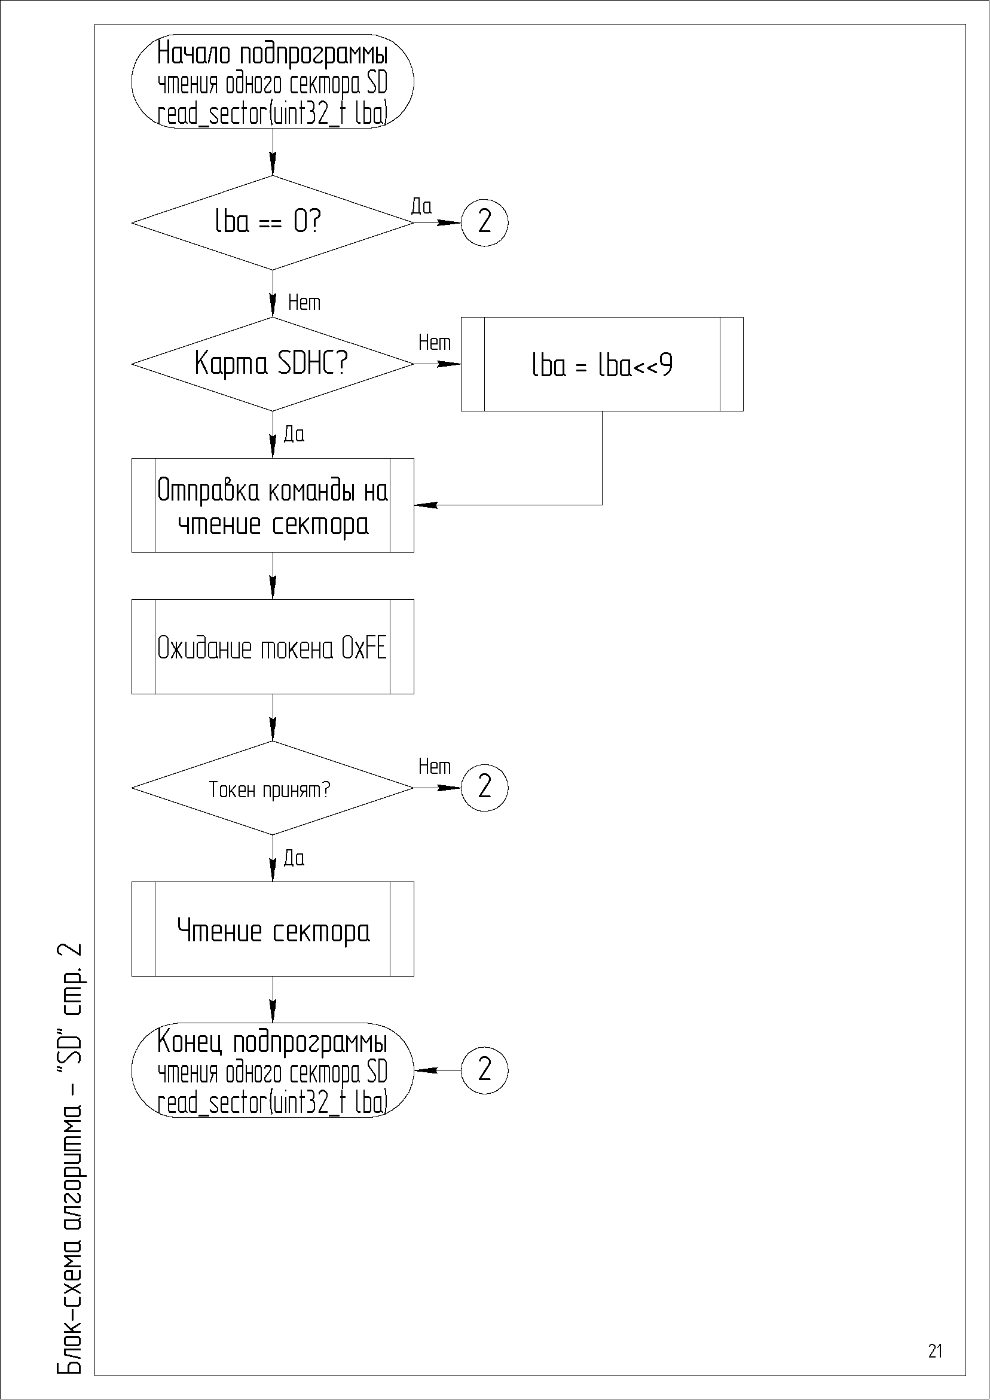
[picture p43: figure]

Рисунок А. 25 — Блок схема алгоритма, лист 21

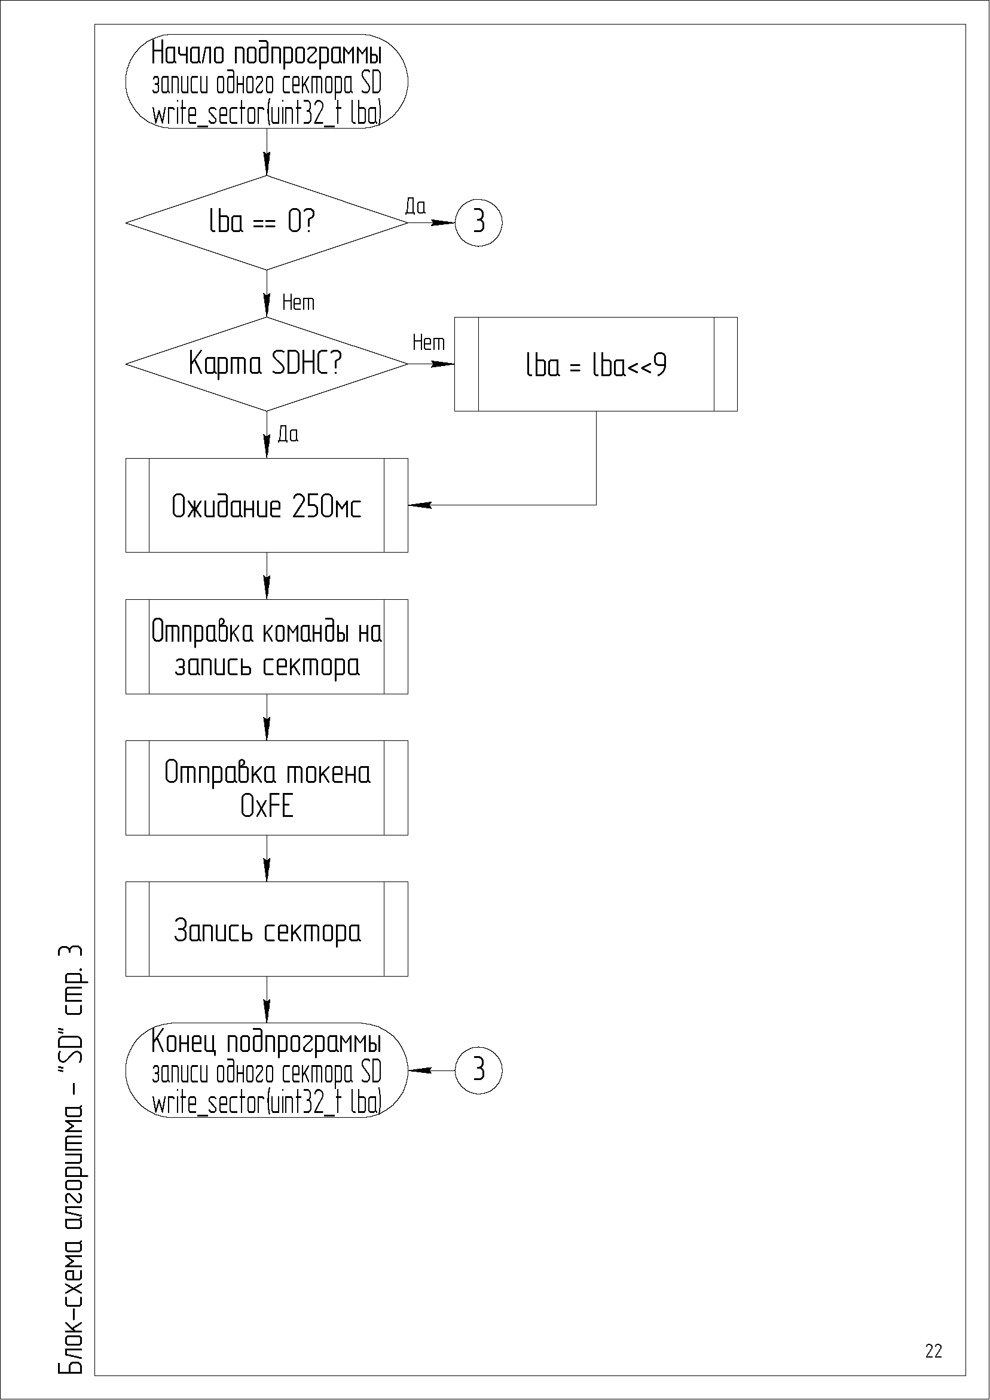
[picture p44: figure]

Рисунок А. 26 — Блок схема алгоритма, лист 22

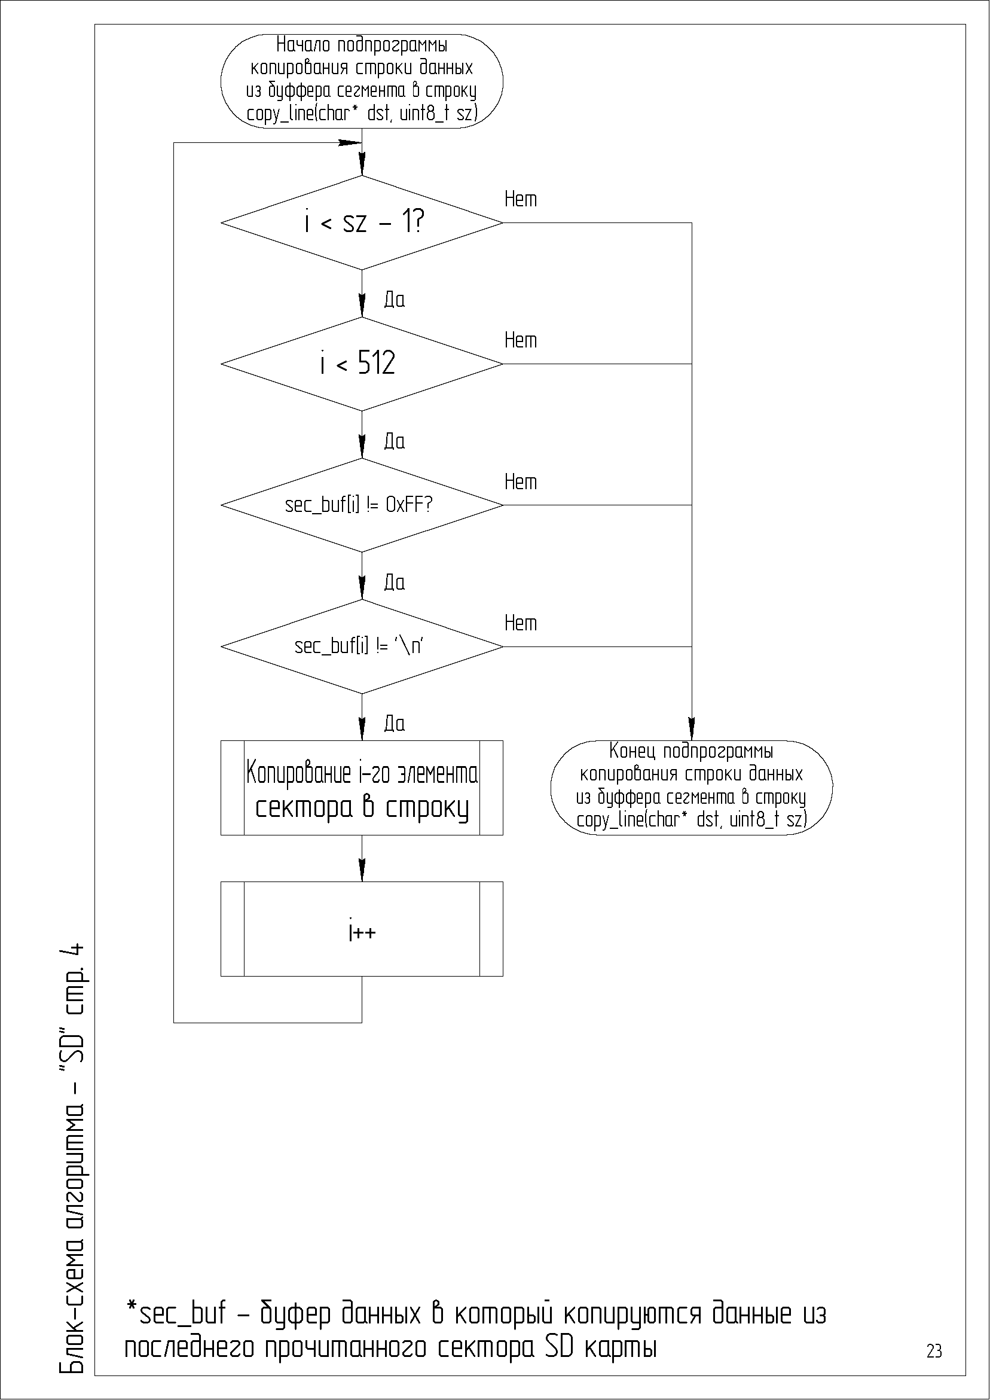
[picture p45: figure]

Рисунок А. 27 — Блок схема алгоритма, лист 23

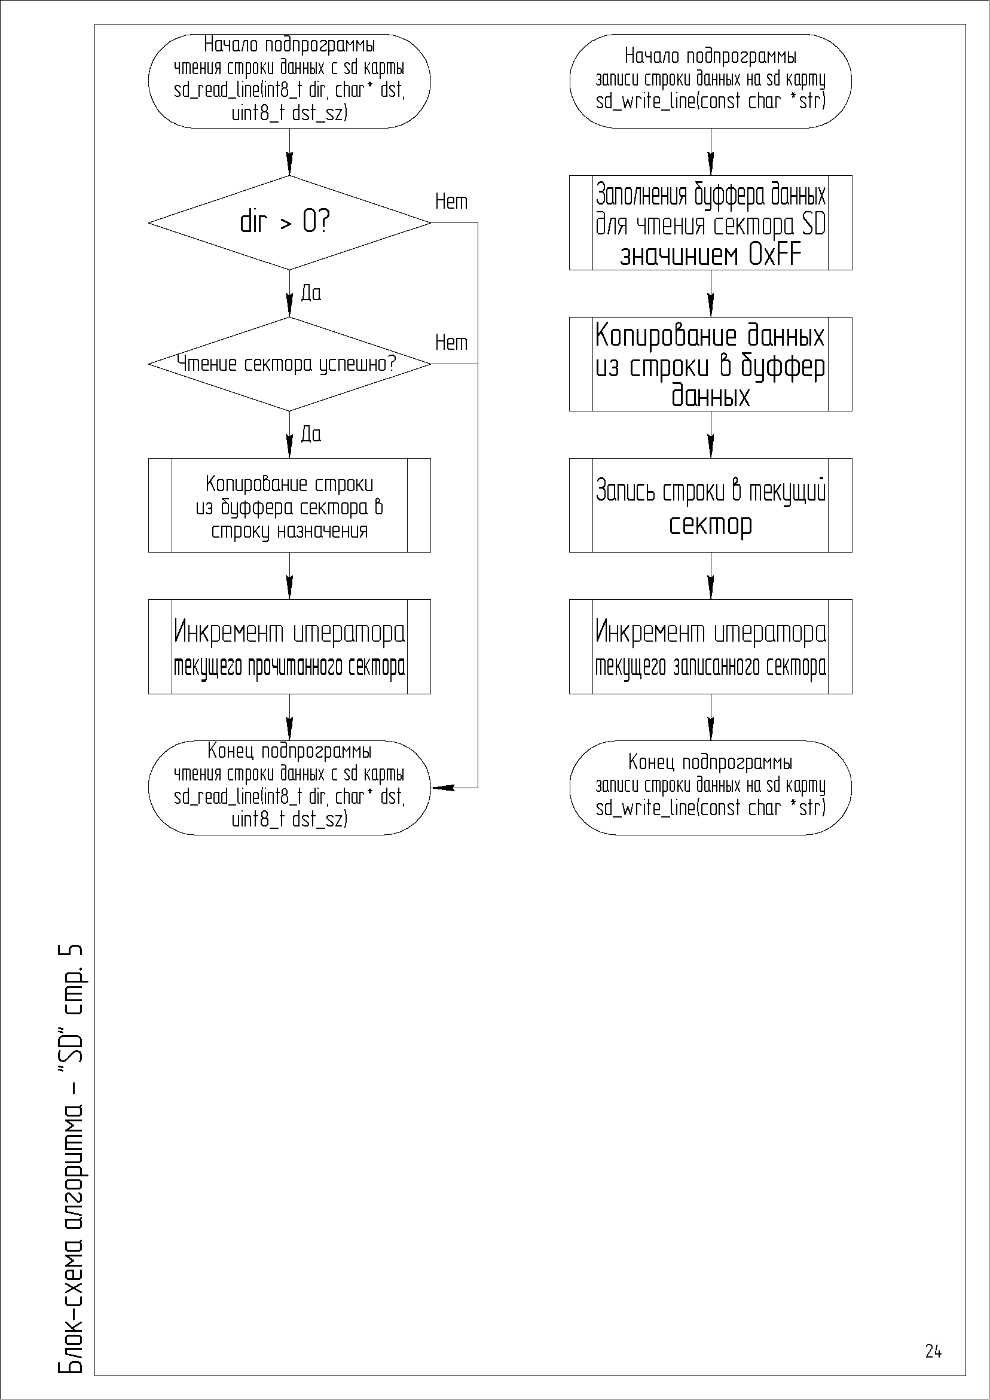
[picture p46: figure]

Рисунок А. 28 — Блок схема алгоритма, лист 24

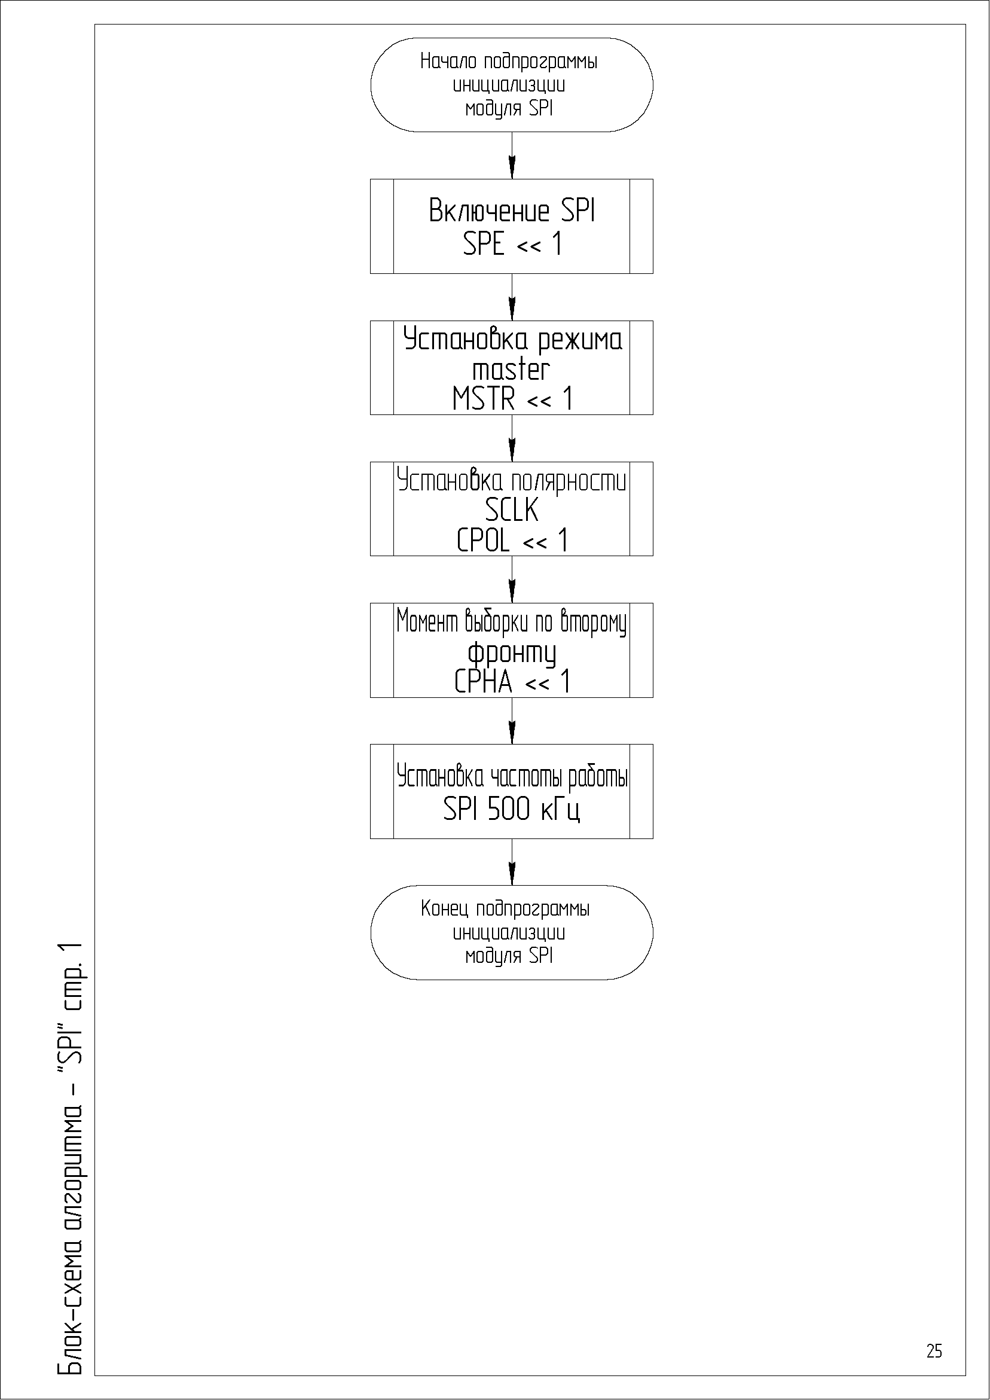
[picture p47: figure]

Рисунок А. 29 — Блок схема алгоритма, лист 25

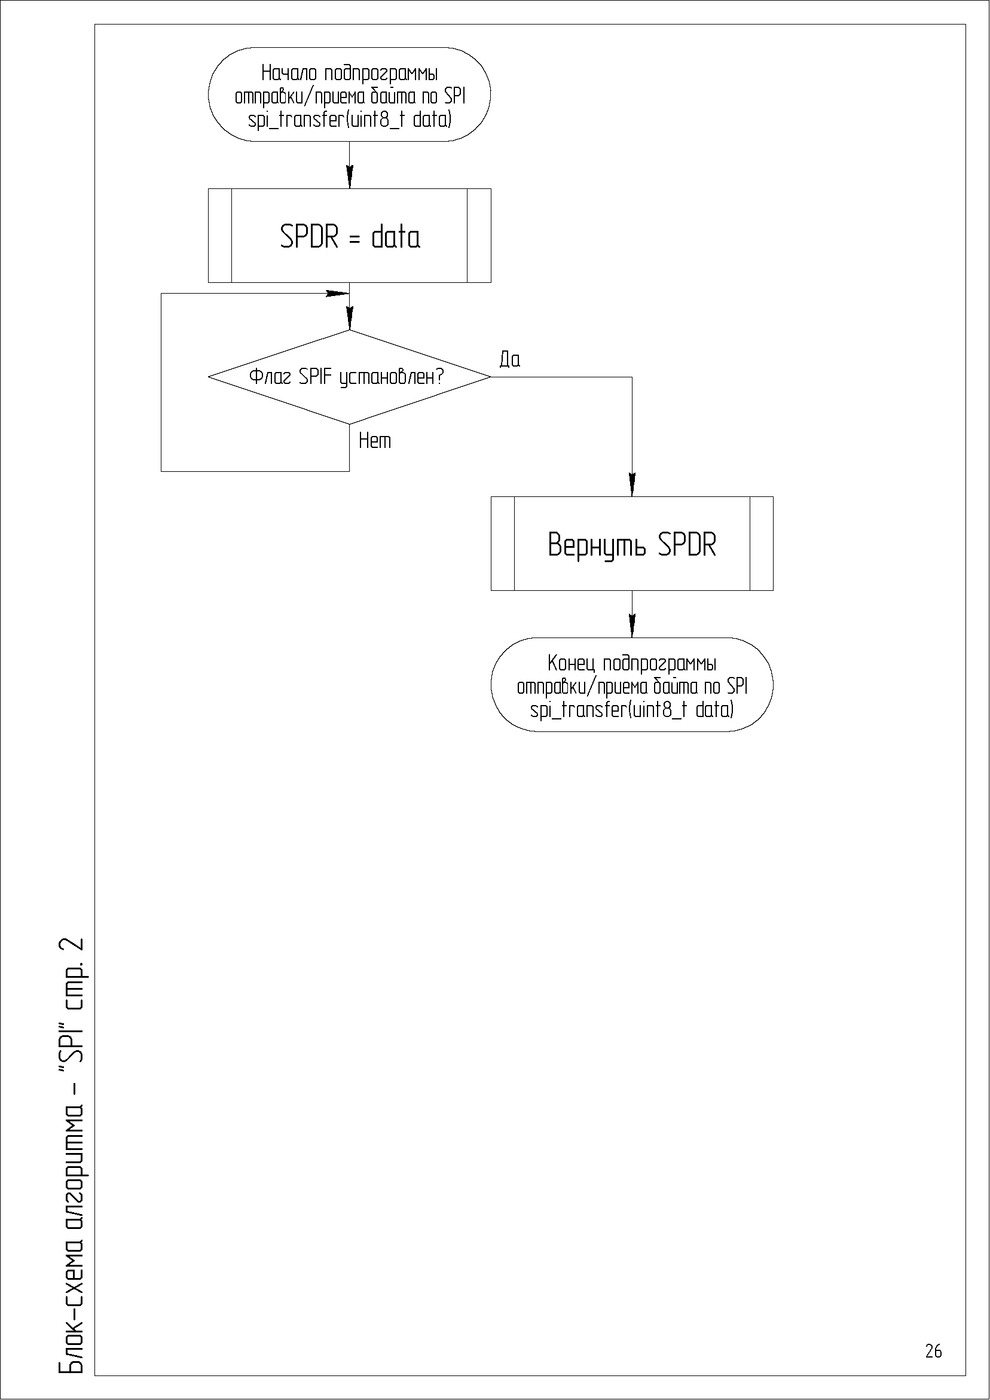
[picture p48: figure]

Рисунок А. 30 — Блок схема алгоритма, лист 26

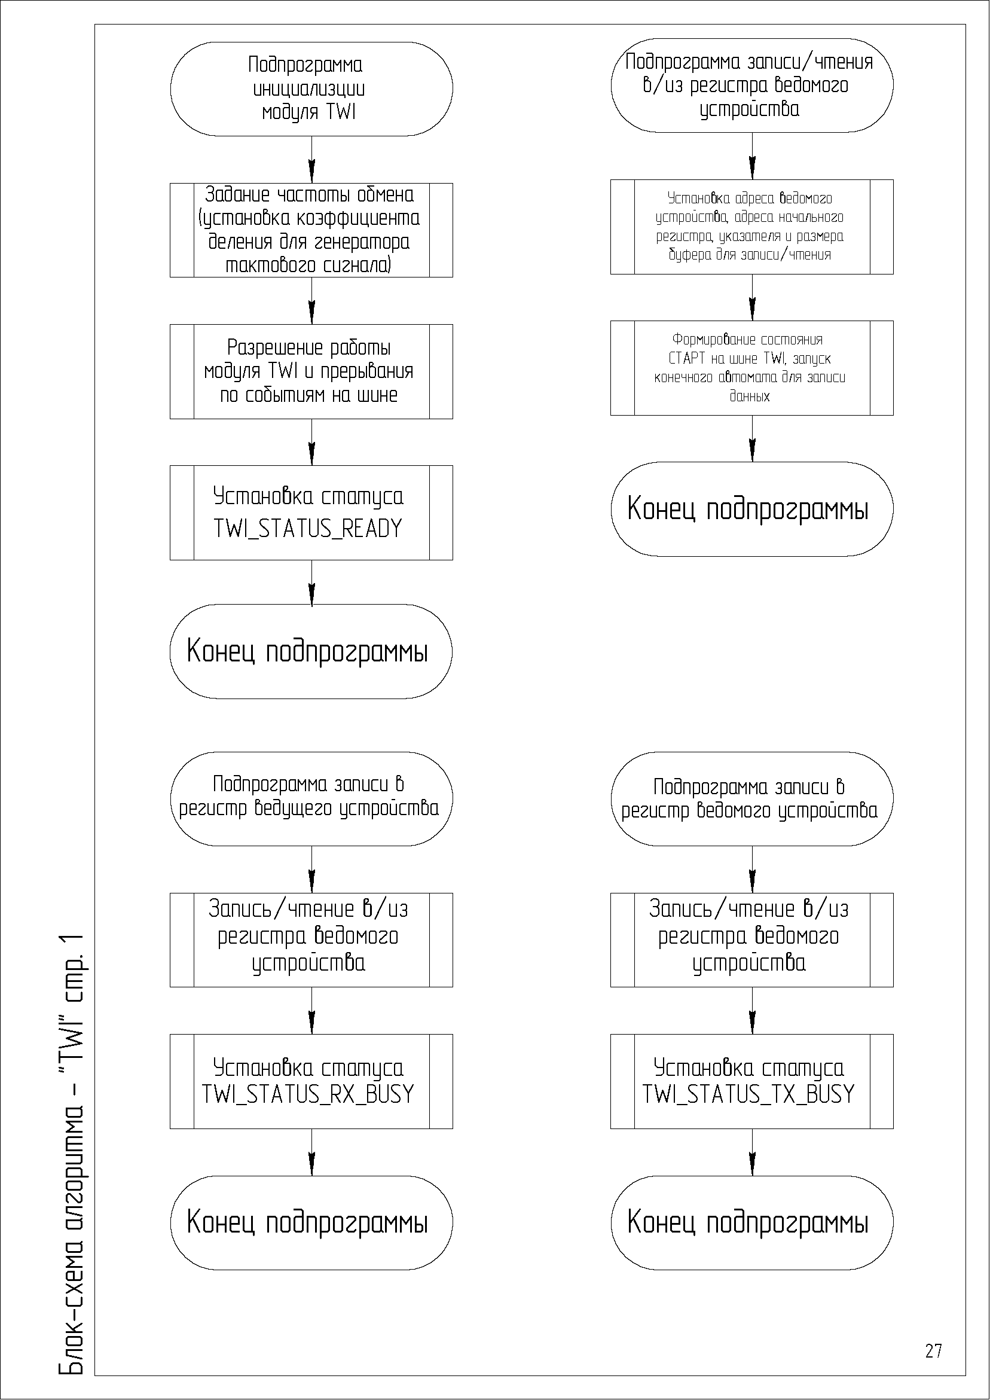
[picture p49: figure]

Рисунок А. 31 — Блок схема алгоритма, лист 27

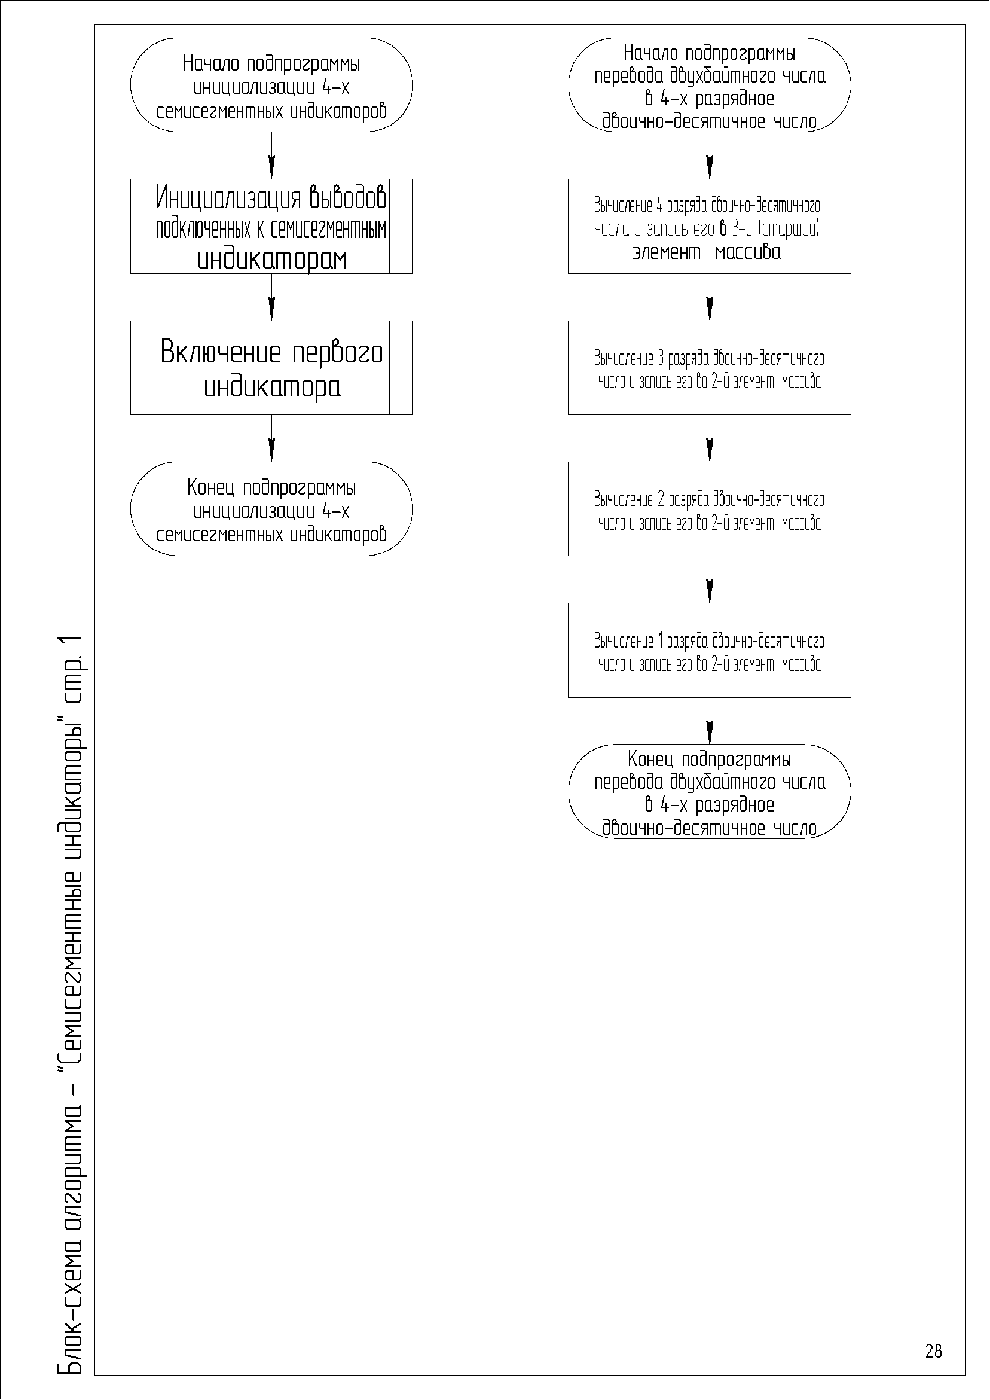
[picture p50: figure]

Рисунок А. 32 — Блок схема алгоритма, лист 28

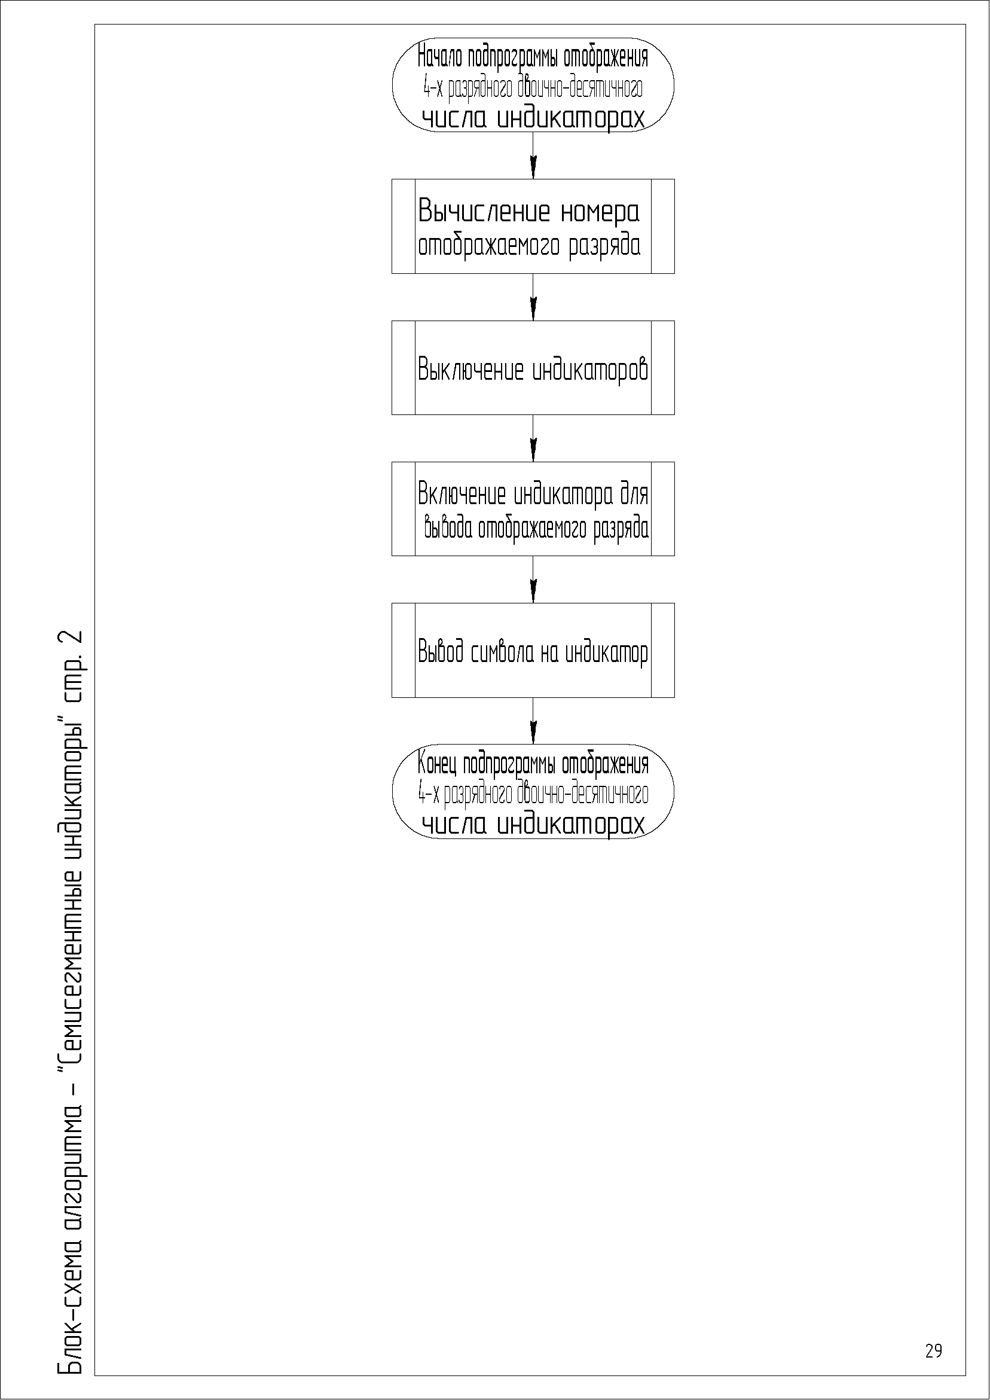
[picture p51: figure]

Рисунок А. 33 — Блок схема алгоритма, лист 2

Файл main.c

#include <avr/interrupt.h>

#include <avr/io.h>

#include <math.h>

#include <stdio.h>

#include <stdlib.h>

#include <string.h>

#include <util/atomic.h>

#include <util/delay.h>

#include "lcd16x2.h"

#include "main.h"

#include "max31865.h"

#include "pcf8583.h"

#include "sdcard.h"

#include "sevseg.h"

#include "twi.h"

#define F_CPU 8000000UL

#define BTN_MASK (1 << PC3)

#define BTN_FWD PC5

#define BTN_BWD PC6

#define BTN_FWD_MASK (1 << BTN_FWD)

#define BTN_BWD_MASK (1 << BTN_BWD)

#define LED_MASK (1 << PD7)

#define HOLD_INITIAL_DELAY_MS 250

#define REP_DELAY_MIN_MS 1

#define REP_DELAY_BASE_MS 500

#define SCROLL_PAUSE_MS 1000

#define SCROLL_STEP_MS 250

#define ERR_SD 1

#define ERR_RTC 2

#define ERR_TEMP 4

static volatile uint16_t fwd_hold_cnt, fwd_rep_cnt;

static volatile uint16_t bwd_hold_cnt, bwd_rep_cnt;

static volatile uint32_t ms_ticks = 0;

static volatile uint8_t nav_end_event = 0;

static volatile uint8_t nav_start_event = 0;

static volatile uint32_t last_sent_meas = 0;

static uint8_t error_state = 0;

struct {

uint8_t one_sec : 1;

uint8_t ten_sec : 1;

uint8_t nav_fwd : 1;

uint8_t nav_bwd : 1;

uint8_t uart_dump : 1;

uint8_t btn_lock : 1;

uint8_t history : 1;

uint8_t hist : 1;

uint8_t err : 1;

uint8_t lcd_clear : 1;

} volatile flags;

static uint32_t meas_no = 0;

static uint32_t nav_pos = 0;

static struct pcf_time rtc_time;

volatile uint8_t disp_digits[4];

static char linebuf[32];

static char linebuf_hist[32];

static char scroll_buf[32];

static uint8_t scroll_len = 0, scroll_ofs = 0;

static uint32_t scroll_t0 = 0;

static uint32_t last_sent_entry = 0;

static char* strip_date(char* s) {

char* p = strchr(s, ' ');

if (!p) return s;

char* q = strchr(p + 1, ' ');

if (!q) return s;

memmove(p + 1, q + 1, strlen(q + 1) + 1);

return s;

}

static inline uint8_t bcd2dec(uint8_t v) {

return ((v >> 4) * 10) + (v & 0x0F);

}

static inline void time2str(const struct pcf_time* t, char* buf) {

sprintf(buf, "%02u:%02u:%02u", bcd2dec(t->hours & 0x3F),

bcd2dec(t->minutes & 0x7F), bcd2dec(t->seconds & 0x7F));

}

static void temperature_to_digits_tenth(float temp) {

uint8_t digits[4];

uint8_t negative = (temp < 0);

if (negative) temp = -temp;

uint16_t hundredths = (uint16_t)(temp * 100.0f + 0.5f);

if (hundredths > 9999) hundredths = 9999;

sevseg_bin2bcd(hundredths, digits);

if (negative)

digits[3] = 0x0A;

else if (digits[3] == 0)

digits[3] = 0;

ATOMIC_BLOCK(ATOMIC_RESTORESTATE) {

for (uint8_t i = 0; i < 4; i++) disp_digits[i] = digits[i];

}

sevseg_set_dot(2);

sevseg_blank_leading(1);

}

static void go_to_log_end(void) {

nav_pos = meas_no;

if (sd_read_line_at(nav_pos, linebuf, sizeof linebuf) == 0) {

char* e = strchr(linebuf, '\n');

if (e) *e = 0;

lcd_mov_cursor(16);

strip_date(linebuf);

lcd_disp_str((uint8_t*)linebuf);

lcd_disp_str((uint8_t*)" ");

strncpy(scroll_buf, linebuf, sizeof scroll_buf - 1);

scroll_buf[sizeof scroll_buf - 1] = 0;

scroll_len = strlen(scroll_buf);

scroll_ofs = 0;

scroll_t0 = ms_ticks;

}

}

static void go_to_log_start(void) {

nav_pos = 1;

if (sd_read_line_at(nav_pos, linebuf, sizeof linebuf) == 0) {

char* e = strchr(linebuf, '\n');

if (e) *e = 0;

lcd_mov_cursor(16);

strip_date(linebuf);

lcd_disp_str((uint8_t*)linebuf);

lcd_disp_str((uint8_t*)" ");

strncpy(scroll_buf, linebuf, sizeof scroll_buf - 1);

scroll_buf[sizeof scroll_buf - 1] = 0;

scroll_len = strlen(scroll_buf);

scroll_ofs = 0;

scroll_t0 = ms_ticks;

}

}

static inline void uart_putc(char c) {

while (!(UCSRA & (1 << UDRE)));

UDR = c;

}

static void uart_puts(const char* s) {

while (*s) uart_putc(*s++);

}

static void scroll_update(void) {

if (scroll_len <= 16) return;

uint32_t now = ms_ticks;

if (scroll_ofs == 0 && now - scroll_t0 < SCROLL_PAUSE_MS) return;

if (now - scroll_t0 >= SCROLL_STEP_MS) {

scroll_t0 = now;

if (++scroll_ofs > scroll_len - 16) {

scroll_ofs = 0;

scroll_t0 = now;

}

lcd_mov_cursor(16);

for (uint8_t i = 0; i < 16; i++) {

char c = (i + scroll_ofs < scroll_len) ? scroll_buf[i + scroll_ofs]

: ' ';

lcd_send_char(c);

}

}

}

static inline uint8_t pcf_day(const struct pcf_time* t) {

return bcd2dec(t->day & 0x3F);

}

static inline uint8_t pcf_month(const struct pcf_time* t) {

return bcd2dec(t->month & 0x1F);

}

static inline uint8_t pcf_year(const struct pcf_time* t) {

uint8_t yy_compile =

((__DATE__[9] - '0') * 10 + (__DATE__[10] - '0')); // «25» для 2025 г.

uint8_t base = yy_compile & 0xFC; // 24, 28, 32 …

return base + (t->day >> 6); // + YY(1-0)

}

static void show_error(const char* msg) {

lcd_mov_cursor(0);

lcd_disp_str((uint8_t*)msg);

_delay_ms(1000);

}

ISR(TIMER1_COMPA_vect) {

static uint8_t sec_cnt = 0;

flags.one_sec = 1;

if (++sec_cnt >= 1) {

sec_cnt = 0;

flags.ten_sec = 1;

}

}

ISR(TIMER0_OVF_vect) {

if (flags.uart_dump || flags.err)

PORTA = 0x00;

else

sevseg_display_process(disp_digits);

ms_ticks++;

static uint8_t prev = BTN_FWD_MASK | BTN_BWD_MASK | (1 << PC7) | (1 << PC3);

uint8_t cur =

PINC & (BTN_FWD_MASK | BTN_BWD_MASK | (1 << PC7) | (1 << PC3));

uint8_t changed = prev ^ cur;

uint8_t pressed_edge = changed & (~cur);

static uint32_t last_fwd_ms = 0, last_bwd_ms = 0;

static uint8_t fwd_clicks = 0, bwd_clicks = 0;

const uint32_t DOUBLE_CLICK_MS = 70;

if (pressed_edge & BTN_FWD_MASK) {

uint32_t now = ms_ticks;

fwd_clicks =

(now - last_fwd_ms <= DOUBLE_CLICK_MS) ? fwd_clicks + 1 : 1;

last_fwd_ms = now;

if (fwd_clicks == 2) {

nav_end_event = 1;

fwd_clicks = 0;

}

flags.nav_fwd = 1;

fwd_hold_cnt = 0;

fwd_rep_cnt = HOLD_INITIAL_DELAY_MS;

}

if (!(cur & BTN_FWD_MASK)) {

if (fwd_hold_cnt < UINT16_MAX) fwd_hold_cnt++;

if (fwd_hold_cnt >= HOLD_INITIAL_DELAY_MS) {

if (fwd_rep_cnt == 0) {

flags.nav_fwd = 1;

uint32_t delay = REP_DELAY_BASE_MS / (meas_no ? meas_no : 1);

if (delay < REP_DELAY_MIN_MS) delay = REP_DELAY_MIN_MS;

fwd_rep_cnt = delay;

} else

fwd_rep_cnt--;

}

} else

fwd_hold_cnt = 0;

if (pressed_edge & BTN_BWD_MASK) {

uint32_t now = ms_ticks;

bwd_clicks =

(now - last_bwd_ms <= DOUBLE_CLICK_MS) ? bwd_clicks + 1 : 1;

last_bwd_ms = now;

if (bwd_clicks == 2) {

nav_start_event = 1;

bwd_clicks = 0;

}

flags.nav_bwd = 1;

bwd_hold_cnt = 0;

bwd_rep_cnt = HOLD_INITIAL_DELAY_MS;

}

if (!(cur & BTN_BWD_MASK)) {

if (bwd_hold_cnt < UINT16_MAX) bwd_hold_cnt++;

if (bwd_hold_cnt >= HOLD_INITIAL_DELAY_MS) {

if (bwd_rep_cnt == 0) {

flags.nav_bwd = 1;

uint32_t delay = REP_DELAY_BASE_MS / (meas_no ? meas_no : 1);

if (delay < REP_DELAY_MIN_MS) delay = REP_DELAY_MIN_MS;

bwd_rep_cnt = delay;

} else

bwd_rep_cnt--;

}

} else

bwd_hold_cnt = 0;

if (pressed_edge & (1 << PC3)) flags.history = 1;

if (pressed_edge & (1 << PC7)) flags.uart_dump = 1;

prev = cur;

}

static void uart_dump_log(void) {

uint32_t current_entry = 0;

sd_iter_reset();

lcd_mov_cursor(0);

for (uint8_t i = 0; i < 16; i++) lcd_send_char(' ');

uint8_t shown_blocks = 0;

static char current_msg[16];

lcd_mov_cursor(0);

lcd_disp_str((uint8_t*)"UART");

while (current_entry < meas_no) {

++current_entry;

if (current_entry > last_sent_entry) {

sprintf(current_msg, "%lu/%lu", current_entry, meas_no);

sd_read_line_at(current_entry, linebuf, sizeof linebuf);

uart_puts(linebuf);

uart_putc('\n');

}

}

if (current_entry > last_sent_entry) {

last_sent_meas += current_entry - last_sent_entry;

last_sent_entry = current_entry;

}

sd_iter_to_end();

_delay_ms(500);

}

static void uart_init(void) {

UCSRA |= (1 << U2X);

UBRRL = 3;

UCSRC |= (1 << URSEL) | (1 << UCSZ0) | (1 << UCSZ1);

UCSRB |= (1 << RXCIE) | (1 << RXEN) | (1 << TXEN);

}

static void timer0_init(void) {

TCCR0 = (1 << CS01) | (1 << CS00);

TIMSK |= (1 << TOIE0);

}

static void timer1_init(void) {

TCCR1B = (1 << WGM12) | (1 << CS12);

OCR1A = 255;

TIMSK |= (1 << OCIE1A);

}

static void port_init(void) {

DDRC &= ~(BTN_MASK | BTN_FWD_MASK | BTN_BWD_MASK);

PORTC |= (BTN_MASK | BTN_FWD_MASK | BTN_BWD_MASK);

DDRC &= ~(1 << PC7);

PORTC |= (1 << PC7);

}

static uint8_t cnt_err = 0;

static void update_error_display(void) {

if (cnt_err == 0) {

lcd_mov_cursor(0);

lcd_disp_str(" ");

cnt_err = 1;

}

if (error_state & ERR_SD)

show_error("NO SD");

else if (error_state & ERR_RTC)

show_error("NO RTC");

else if (error_state & ERR_TEMP)

show_error("NO TEMP");

}

int main(void) {

float temperature = 0.0f;

uart_init();

port_init();

sevseg_init();

lcd_init();

lcd_disp_str((uint8_t*)"1");

max31865_init(0, 0);

lcd_disp_str((uint8_t*)"2");

lcd_mov_cursor(16);

timer0_init();

timer1_init();

sd_iter_reset();

twi_init();

sei();

pcf_init();

if (sd_erase_sector(1) != 0) {

error_state |= ERR_SD;

}

if (error_state & ERR_SD) show_error("NO SD");

twi_status = TWI_STATUS_READY;

pcf_read_time(&rtc_time);

uint16_t tout = 1000;

while (twi_status == TWI_STATUS_RX_BUSY && tout--) {

_delay_ms(1);

}

if (twi_status != TWI_STATUS_RX_COMPLETE) {

error_state |= ERR_RTC;

}

if (error_state & ERR_RTC)

show_error("NO RTC");

else

twi_status = TWI_STATUS_READY;

meas_no = sd_get_entry_count();

while (1) {

if (flags.one_sec) {

flags.one_sec = 0;

pcf_read_time(&rtc_time);

uint16_t tmo = 1000;

while (twi_status == TWI_STATUS_RX_BUSY && tmo--) {

_delay_ms(1);

}

if (twi_status != TWI_STATUS_RX_COMPLETE) {

error_state |= ERR_RTC;

} else {

error_state &= ~ERR_RTC;

twi_status = TWI_STATUS_READY;

}

temperature = max31865_read_temperature();

if (temperature > 85.0f) {

error_state |= ERR_TEMP;

} else {

error_state &= ~ERR_TEMP;

}

if (error_state == 0) {

temperature_to_digits_tenth(temperature);

char tstr[10], cnt[6];

time2str(&rtc_time, tstr);

sprintf(cnt, "%lu", meas_no + last_sent_meas);

lcd_mov_cursor(0);

lcd_disp_str((uint8_t*)tstr);

lcd_mov_cursor(10);

lcd_disp_str((uint8_t*)"#");

lcd_disp_str((uint8_t*)cnt);

}

}

if (error_state & ERR_SD) {

sd_init();

if (sd_erase_sector(meas_no + 1) == 0) {

error_state &= ~ERR_SD;

// lcd_send_cmd(1 << LCD_CLR);

//_delay_ms(2);

// meas_no = sd_get_entry_count();

// nav_pos = meas_no;

}

}

if (error_state) {

flags.err = 1;

update_error_display();

scroll_update();

continue;

}

if (flags.err == 1) {

sd_init();

pcf_init();

}

cnt_err = 0;

flags.err = 0;

if (flags.ten_sec) {

flags.ten_sec = 0;

if (!flags.btn_lock) {

flags.btn_lock = 1;

int16_t t100 = (int16_t)(temperature * 100.0f + 0.5f);

++meas_no;

sprintf(linebuf, "%lu %02u.%02u.%02u %02u:%02u,%+d.%02u",

meas_no + last_sent_meas, // № измерения

pcf_day(&rtc_time), // ДД

pcf_month(&rtc_time), // ММ

pcf_year(&rtc_time), // ГГ

bcd2dec(rtc_time.hours & 0x3F), // чч

bcd2dec(rtc_time.minutes & 0x7F), // мм

t100 / 100, abs(t100) % 100); // t,xx

memset(linebuf_hist, 0, sizeof linebuf_hist);

strncpy(linebuf_hist, linebuf, sizeof linebuf_hist - 1);

strcat(linebuf, "\n");

if (sd_write_line(linebuf) != 0) {

error_state |= ERR_SD;

} else {

error_state &= ~ERR_SD;

sd_erase_sector(meas_no + 1);

}

if (flags.hist) {

lcd_mov_cursor(16);

strip_date(linebuf_hist);

lcd_disp_str((uint8_t*)linebuf_hist);

lcd_disp_str((uint8_t*)" ");

strncpy(scroll_buf, linebuf_hist, sizeof scroll_buf - 1);

scroll_buf[sizeof scroll_buf - 1] = 0;

scroll_len = strlen(scroll_buf);

scroll_ofs = 0;

scroll_t0 = ms_ticks;

}

flags.btn_lock = 0;

}

}

if (flags.history && !flags.btn_lock) {

flags.history = 0;

flags.hist = !flags.hist;

nav_end_event = nav_start_event = 0;

if (flags.hist) {

lcd_mov_cursor(16);

strip_date(linebuf_hist);

lcd_disp_str((uint8_t*)linebuf_hist);

lcd_disp_str((uint8_t*)" ");

strncpy(scroll_buf, linebuf_hist, sizeof scroll_buf - 1);

scroll_buf[sizeof scroll_buf - 1] = 0;

} else {

sd_iter_reset();

nav_pos = meas_no;

sd_read_line_at(meas_no, linebuf, sizeof linebuf);

char* e = strchr(linebuf, '\n');

if (e) *e = 0;

lcd_mov_cursor(16);

strip_date(linebuf);

lcd_disp_str((uint8_t*)linebuf);

lcd_disp_str((uint8_t*)" ");

strncpy(scroll_buf, linebuf, sizeof scroll_buf - 1);

scroll_buf[sizeof scroll_buf - 1] = 0;

}

scroll_len = strlen(scroll_buf);

scroll_ofs = 0;

scroll_t0 = ms_ticks;

}

if (!flags.hist) {

if (nav_end_event && !flags.btn_lock) {

nav_end_event = 0;

flags.btn_lock = 1;

sd_iter_to_end();

go_to_log_end();

flags.btn_lock = 0;

}

if (nav_start_event && !flags.btn_lock) {

nav_start_event = 0;

flags.btn_lock = 1;

sd_iter_reset();

go_to_log_start();

flags.nav_bwd = 0;

flags.btn_lock = 0;

}

if (flags.nav_fwd && !flags.btn_lock) {

flags.nav_fwd = 0;

if (nav_pos < meas_no &&

sd_read_line_at(++nav_pos, linebuf, sizeof linebuf) == 0) {

char* e = strchr(linebuf, '\n');

if (e) *e = 0;

lcd_mov_cursor(16);

strip_date(linebuf);

lcd_disp_str((uint8_t*)linebuf);

lcd_disp_str((uint8_t*)" ");

strncpy(scroll_buf, linebuf, sizeof scroll_buf - 1);

scroll_buf[sizeof scroll_buf - 1] = 0;

scroll_len = strlen(scroll_buf);

scroll_ofs = 0;

scroll_t0 = ms_ticks;

}

}

if (flags.nav_bwd && !flags.btn_lock) {

flags.nav_bwd = 0;

if (nav_pos > 1 &&

sd_read_line_at(--nav_pos, linebuf, sizeof linebuf) == 0) {

char* e = strchr(linebuf, '\n');

if (e) *e = 0;

lcd_mov_cursor(16);

strip_date(linebuf);

lcd_disp_str((uint8_t*)linebuf);

lcd_disp_str((uint8_t*)" ");

strncpy(scroll_buf, linebuf, sizeof scroll_buf - 1);

scroll_buf[sizeof scroll_buf - 1] = 0;

scroll_len = strlen(scroll_buf);

scroll_ofs = 0;

scroll_t0 = ms_ticks;

}

}

}

if (flags.uart_dump && !flags.btn_lock) {

flags.btn_lock = 1;

lcd_send_cmd(1 << LCD_CLR);

_delay_ms(2);

uart_dump_log();

sd_erase_sector(0);

sd_clear_log(1);

meas_no = 0;

nav_pos = 0;

last_sent_entry = 0;

lcd_send_cmd(1 << LCD_CLR);

_delay_ms(2);

lcd_mov_cursor(10);

lcd_disp_str((uint8_t*)"#0 ");

flags.btn_lock = 0;

flags.uart_dump = 0;

}

scroll_update();

}

}

Файл lcd.h

#ifndef LCD16X2_H

#define LCD16X2_H

#include <avr/io.h>

/* Битовые поля для команд LCD дисплея */

/* Очистка дисплея с установкой курсора в начало первой строки */

#define LCD_CLR 0 // Старший бит инструкции (DB0)

/* Установка курсора в начало первой строки */

#define LCD_HOME 1 // Старший бит инструкции (DB1)

/* Установка направления вывода символов, разрешение сдвига экрана */

#define LCD_MODE 2 // Старший бит инструкции (DB2)

#define LCD_MODE_I_D \

1 // Направление вывода символов (DB1)

// 0: справа налево; 1: слева направо

#define LCD_MODE_SH 0 // Разрешение сдвига экрана при выводе символов (DB0)

/* Включение/выключение дисплея и отображения курсора */

#define LCD_ON 3 // Старший бит инструкции (DB3)

#define LCD_ON_D 2 // Включение дисплея (DB2)

#define LCD_ON_C 1 // Включение курсора (DB1)

#define LCD_ON_B 0 // Включение мигания курсора (DB0)

/* Сдвиг курсора и экрана */

#define LCD_SHIFT 4 // Старший бит инструкции (DB4)

#define LCD_SHIFT_S_C \

3 // Разрешение сдвига экрана (DB3)

// 0: сдвиг только курсора; 1: сдвиг курсора и экрана

#define LCD_SHIFT_R_L \

2 // Направление сдвига (DB2)

// 0: сдвиг влево; 1: сдвиг вправо

/* Настройка интерфейса, количества строк для вывода, размера шрифта ЭТО В

* FUNCTION SET в документации можно посмотреть*/

#define LCD_F 5 // Старший бит инструкции (DB5)

#define LCD_F_DL \

4 // Выбор интерфейса (DB4)

// 0: 4-битный интерфейс; 1: 8-битный интерфейс

#define LCD_F_N \

3 // Количество строк для вывода (DB3)

// 0: 1 строка; 1: 2 строки

#define LCD_F_F 2 // Размер шрифта (DB2) 0: 5х8 пикселей; 1: 5х11 пикселей

/* Запись адреса DDRAM памяти в адресный указатель */

#define LCD_DDRAM 7 // Старший бит инструкции (DB7)

void lcd_init(void); // инициализация дисплея

void lcd_disp_buf(uint8_t *buf, uint8_t size);

void lcd_disp_str(uint8_t *str);

void lcd_mov_cursor(uint8_t new_pos);

void lcd_send_cmd(uint8_t cmd);

void lcd_send_char(uint8_t data);

#endif

/* End File */

Файл lcd.c

#define F_CPU 8000000UL

#include <util/delay.h>

#include "lcd16x2.h"

#define LCD_PORT PORTD // Порт к которому подключен LCD дисплей

#define LCD_DDR DDRD // Выводы данных LCD должны быть подключены к старшим

#define LCD_PIN PIND // выводам порта микроконтроллера

#define LCD_DATA_MASK 0xF0 // Маска выводов данных дисплея

#define LCD_E 3 // Номер вывода E (запись данных в LCD осуществляется по спаду)

#define LCD_RS 2 // Номер вывода RS (1 - данные; 0 - инструкция)

#define LCD_PIN_MASK (LCD_DATA_MASK | (1 << LCD_RS) | (1 << LCD_E))

/**

* Функция отправки полубайта данных/команды на дисплей

* Код полубайта должен находится в старшем полубайте аргумента hfbyte

*

* \param hfbyte код полубайта данных/команды (старший полубайт)

*/

static inline void lcd_send_hfbyte(uint8_t hfbyte) {

LCD_PORT |= (1 << LCD_E);

/* Выводы данных дисплея подключены к старшим разрядам порта МК */

uint8_t temp = LCD_PORT;

temp &= ~LCD_DATA_MASK;

temp |= hfbyte;

LCD_PORT = temp;

LCD_PORT &= ~(1 << LCD_E); // защелкивание данных на дисплее

}

/**

* Функция отправки старшего полубайта команды на дисплей (используется при

* инициализации). Код половины команды должен находится в старшем полубайте

* аргумента hfcmd

*

* \param hfcmd старший полубайт команды

*/

static void lcd_send_hfcmd(uint8_t hfcmd) {

LCD_PORT &= ~(1 << LCD_RS);

lcd_send_hfbyte(hfcmd);

}

/**

* Функция отправки байта данных/команды на дисплей

*

* \param byte байт данных/команды

*/

static void lcd_send_byte(uint8_t byte) {

_delay_us(50);

lcd_send_hfbyte(byte & 0xF0);

lcd_send_hfbyte(byte << 4);

}

/**

* Функция вывода на дисплей символа

* Время выполнения составляет 50 мкс

*

* \param symbol код символа

*/

void lcd_send_char(uint8_t symbol) {

LCD_PORT |= (1 << LCD_RS); // говорим, что будем передавать данные

lcd_send_byte(symbol); // отправляем байт

}

/**

* Функция отправки команды на дисплей

* Время выполнения команд "Очистка дисплея с установкой курсора в начало первой

* строки" и "Установка курсора в начало первой строки" составляет 1.5 мс;

* время выполнения остальных команд составляет 50 мкс.

*

* \param cmd код команды

*/

void lcd_send_cmd(uint8_t cmd) {

LCD_PORT &= ~(1 << LCD_RS); // вывод в 0

lcd_send_byte(cmd);

}

/* Функция инициализации дисплея LCD16x2 */

void lcd_init(void) {

DDRD |= (1 << PD2) | (1 << PD3) | (1 << PD4) | (1 << PD5) | (1 << PD6) |

(1 << PD7);

/* Задержка не менее 15 мс, после подачи питания на дисплей */

_delay_ms(15);

/**

* Инициализация дисплея и перевод его на 4-х битный интерфейс

* согласно порядку, приведенному в datasheet

* Пока не перевели на 4-битный интерфейс отправляем команды по полбайта

* Отправка старшего полубайта команды настройки 8-битного интерфейса

* Задержка не менее 4.1 мс

* Отправка старшего полубайта команды настройки 8-битного интерфейса

* Задержка не менее 100 мкс

* Отправка старшего полубайта команды настройки 8-битного интерфейса

* Задержка не менее 50 мкс

* Отправка старшего полубайта команды настройки 4-битного интерфейса

*/

lcd_send_hfcmd((1 << LCD_F) | (1 << LCD_F_DL));

_delay_ms(5);

lcd_send_hfcmd((1 << LCD_F) | (1 << LCD_F_DL));

_delay_us(100);

lcd_send_hfcmd((1 << LCD_F) | (1 << LCD_F_DL));

_delay_us(50);

lcd_send_hfcmd(1 << LCD_F);

/**

* Перевод дисплея на 4-битный интерфейс завершен. Теперь можно посылать

* команды/данные по полному байту

*/

/* Подтверждение 4-битного интерфейса */

lcd_send_cmd((1 << LCD_F) | (1 << LCD_F_N));

/* Очистка дисплея, дисплей очищается не менее 1.5 мс */

lcd_send_cmd(1 << LCD_CLR);

_delay_ms(2);

/* Включение экрана дисплея */

lcd_send_cmd((1 << LCD_ON) | (1 << LCD_ON_D));

}

/**

* Функция вывода на дисплей массива символов

*

* \param buf указатель на массив

* \param size размер массива

*/

void lcd_disp_buf(uint8_t *buf, uint8_t size) {

do {

lcd_send_char(*buf++); // каждый раз отправляем символ через указатель

// массива операция по передаче в функцию *buf++

// эквивалетно: cd_send_char(*buf); buf++;

} while (--size); // сравниваем с нулем здесь преддекремент сначала

// вычитаем единицу, потом сравниваем с 0 сначала надо

// уменьшить символ, потом уже проверить

}

/**

* Функция вывода на дисплей строки

*

* \param str указатель на строку

*/

void lcd_disp_str(uint8_t *str) {

do {

lcd_send_char(*str);

} while (*++str);

}

/**

* Функция изменения позиции курсора дисплея

*

* \param new_pos новая позиция курсора дисплея

*/

void lcd_mov_cursor(uint8_t new_pos) {

/* code */

uint8_t addr;

// new_pos от 0 до 31 (0-15 первая строка, 16-31 вторая)

if (new_pos < 16) {

addr = new_pos;

} else {

addr = (new_pos - 16) + 0x40;

}

lcd_send_cmd((1 << LCD_DDRAM) | addr);

}

/* End File */

Файл max31865.h

#ifndef MAX31865_H

#define MAX31865_H

#include <avr/io.h>

#define F_CPU 8000000UL

#include <stdint.h>

#include <util/delay.h>

/* ===== Register Map ===== */

#define MAX31865_REG_CONFIG 0x00

#define MAX31865_REG_RTD_MSB 0x01

#define MAX31865_REG_RTD_LSB 0x02

#define MAX31865_REG_HFT_MSB 0x03

#define MAX31865_REG_HFT_LSB 0x04

#define MAX31865_REG_LFT_MSB 0x05

#define MAX31865_REG_LFT_LSB 0x06

#define MAX31865_REG_FAULT_STATUS 0x07

/* ===== Configuration Bits ===== */

#define MAX31865_CFG_BIAS (1 << 7)

#define MAX31865_CFG_MODE_AUTO (1 << 6)

#define MAX31865_CFG_1SHOT (1 << 5)

#define MAX31865_CFG_3WIRE (1 << 4)

#define MAX31865_CFG_FAULT_CYCLE_NONE (0 << 2)

#define MAX31865_CFG_FAULT_CYCLE_AUTO (1 << 2)

#define MAX31865_CFG_FAULT_CYCLE_MAN1 (2 << 2)

#define MAX31865_CFG_FAULT_CYCLE_MAN2 (3 << 2)

#define MAX31865_CFG_CLEAR_FAULT (1 << 1)

#define MAX31865_CFG_FILT50HZ (1 << 0)

/* ===== Conversion Constants ===== */

#define MAX31865_RREF 425.0f

#define MAX31865_R0 100.0f

#define MAX31865_A 3.9083e-3f

#define MAX31865_B -5.775e-7f

#define MAX31865_C -4.18301e-12f

#define MAX31865_CS_PORT PORTB

#define MAX31865_CS_DDR DDRB

#define MAX31865_CS_PIN PB4 /* SS */

/* ===== Public API ===== */

void max31865_init(uint8_t three_wire, uint8_t filter50Hz);

float max31865_read_temperature(void);

uint16_t max31865_read_raw(void);

uint8_t max31865_read_fault(void);

void max31865_clear_fault(void);

#endif // MAX31865_H

//

Файл max31865.c

#include "max31865.h"

#include "sdcard.h"

#include "spi.h"

static inline void cs_low(void) { MAX31865_CS_PORT &= ~(1 << MAX31865_CS_PIN); }

static inline void cs_high(void) { MAX31865_CS_PORT |= (1 << MAX31865_CS_PIN); }

static void write_reg(uint8_t addr, uint8_t val) {

cs_low();

spi_transfer(addr | 0x80); /* write flag */

spi_transfer(val);

cs_high();

}

static uint8_t read_reg(uint8_t addr) {

cs_low();

spi_transfer(addr & 0x7F);

uint8_t v = spi_transfer(0xFF);

cs_high();

return v;

}

/* Read 16‑bit register (RTD value, thresholds). */

static uint16_t read_reg16(uint8_t addr) {

cs_low();

spi_transfer(addr & 0x7F);

uint8_t msb = spi_transfer(0xFF);

uint8_t lsb = spi_transfer(0xFF);

cs_high();

return ((uint16_t)msb << 8) | lsb;

}

void max31865_init(uint8_t three_wire, uint8_t filter50Hz) {

/* Configure CS pin */

MAX31865_CS_DDR |= (1 << MAX31865_CS_PIN);

cs_high();

spi_init(); /* in spi.c */

sd_init();

sd_clear_log(1);

SPSR |= (1 << SPI2X);

SPCR &= ~((1 << SPR1) | (1 << SPR0));

uint8_t cfg = 0;

if (three_wire) cfg |= MAX31865_CFG_3WIRE;

if (filter50Hz) cfg |= MAX31865_CFG_FILT50HZ;

write_reg(MAX31865_REG_CONFIG, cfg | MAX31865_CFG_BIAS); /* Enable bias */

_delay_ms(10);

/* Start automatic conversions */

write_reg(MAX31865_REG_CONFIG,

cfg | MAX31865_CFG_BIAS | MAX31865_CFG_MODE_AUTO);

}

uint16_t max31865_read_raw(void) {

uint16_t v = read_reg16(MAX31865_REG_RTD_MSB);

return (v >> 1) & 0x7FFF;

}

float max31865_read_temperature(void) {

uint16_t raw = max31865_read_raw();

float Rt = (float)raw * MAX31865_RREF / 32768.0f;

/* Callendar‑Van Dusen, simplify for >=0 °C */

float Z = Rt / MAX31865_R0;

float temp;

if (Rt >= MAX31865_R0) {

/* quadratic formula */

float d = (MAX31865_A * MAX31865_A) - (4 * MAX31865_B * (1 - Z));

temp = (-MAX31865_A + sqrtf(d)) / (2 * MAX31865_B);

} else {

/* Use full equation with C term for <0 °C */

/* Solve iteratively (Newton) */

temp = -50.0f; /* initial */

for (uint8_t i = 0; i < 6; i++) {

float f = MAX31865_R0 *

(1 + MAX31865_A * temp + MAX31865_B * temp * temp +

MAX31865_C * (temp - 100) * temp * temp * temp) -

Rt;

float df = MAX31865_R0 *

(MAX31865_A + 2 * MAX31865_B * temp +

3 * MAX31865_C * temp * temp - 200 * MAX31865_C * temp);

temp -= f / df;

}

}

return temp;

}

uint8_t max31865_read_fault(void) {

return read_reg(MAX31865_REG_FAULT_STATUS);

}

void max31865_clear_fault(void) {

uint8_t cfg = read_reg(MAX31865_REG_CONFIG);

cfg &= ~MAX31865_CFG_MODE_AUTO; /* halt conv */

write_reg(MAX31865_REG_CONFIG, cfg | MAX31865_CFG_CLEAR_FAULT);

/* restart */

write_reg(MAX31865_REG_CONFIG,

cfg | MAX31865_CFG_BIAS | MAX31865_CFG_MODE_AUTO);

}

// asd

Файл sdcard.h

#ifndef SDCARD_H

#define SDCARD_H

#include <avr/io.h>

#include <stdint.h>

/* Chip-select */

#define SD_CS_PORT PORTC

#define SD_CS_DDR DDRC

#define SD_CS_PIN PC4

void sd_init(void);

void sd_dump_log(void);

uint8_t sd_write_line(const char *str);

void sd_iter_reset(void);

uint8_t sd_read_line(int8_t dir, char *dst, uint8_t dst_size);

void sd_flush(void);

uint32_t sd_get_entry_count(void);

uint8_t sd_read_line_at(uint32_t line_num, char *dst, uint8_t dst_sz);

void sd_iter_to_end(void);

uint8_t sd_erase_sector(uint32_t lba);

void sd_clear_log(uint16_t n_sectors);

#endif

Файл sdcard.c

#include <avr/eeprom.h>

#include <string.h>

#include "sdcard.h"

#include "spi.h"

#define F_CPU 8000000UL

#include <util/delay.h>

/* -------------------------- SPI helpers -------------------------------- */

static inline void sd_select(void) { SD_CS_PORT &= ~(1 << SD_CS_PIN); }

static inline void sd_deselect(void) { SD_CS_PORT |= (1 << SD_CS_PIN); }

static uint8_t spi_x(uint8_t v) { return spi_transfer(v); }

/* ------------------------- Global state -------------------------------- */

static uint8_t sec_buf[512];

static uint8_t card_sdhc = 0;

static uint32_t next_sector = 1; /* куда писать следующую строку */

static uint32_t it_sector; /* курсор при чтении */

uint32_t EEMEM eeprom_next_sector;

/* ====================================================================== */

static uint8_t sd_cmd(uint8_t cmd, uint32_t arg, uint8_t crc) {

sd_deselect();

spi_x(0xFF); /* 8†такт SCK с CS=1 */

sd_select();

spi_x(cmd | 0x40);

spi_x(arg >> 24);

spi_x(arg >> 16);

spi_x(arg >> 8);

spi_x(arg);

spi_x(crc);

for (uint8_t i = 0; i < 10; i++) {

uint8_t r = spi_x(0xFF);

if (!(r & 0x80)) return r;

}

return 0xFF; /* timeout */

}

static uint8_t wait_token(uint8_t token, uint16_t tout_ms) {

while (tout_ms--) {

if (spi_x(0xFF) == token) return 0;

_delay_us(200);

}

return 1;

}

static uint8_t wait_ready(uint16_t tout_ms) {

while (tout_ms--) {

if (spi_x(0xFF) == 0xFF) return 0;

_delay_us(200);

}

return 1;

}

static uint8_t read_sector(uint32_t lba) {

if (lba == 0) return 1; /* защита MBR */

uint32_t addr = card_sdhc ? lba : (lba << 9);

if (sd_cmd(17, addr, 0xFF)) return 2; /* READ_SINGLE_BLOCK */

if (wait_token(0xFE, 100)) return 3; /* data token */

for (uint16_t i = 0; i < 512; i++) sec_buf[i] = spi_x(0xFF);

spi_x(0xFF);

spi_x(0xFF); /* dummy CRC */

sd_deselect();

spi_x(0xFF);

return 0;

}

uint32_t sd_get_entry_count(void) {

return (next_sector > 1) ? (next_sector - 1) : 0;

}

static uint8_t write_sector(uint32_t lba) {

if (lba == 0) return 5; /* защита MBR */

uint32_t addr = card_sdhc ? lba : (lba << 9);

if (wait_ready(250)) return 6;

if (sd_cmd(24, addr, 0xFF)) return 1; /* WRITE_BLOCK */

spi_x(0xFE); /* start token */

for (uint16_t i = 0; i < 512; i++) spi_x(sec_buf[i]);

spi_x(0xFF);

spi_x(0xFF); /* dummy CRC */

uint8_t resp = spi_x(0xFF) & 0x1F;

if (resp != 0x05) return 2; /* data?resp error */

if (wait_ready(250)) return 3; /* busy timeout */

sd_deselect();

spi_x(0xFF);

return 0;

}

/* ------------------------- Tail detector -------------------------------- */

static void find_tail(void) {

// uint32_t s = 1;

// while (1) {

// if (read_sector(s)) break; /* ошибка чтени¤†Ц хвост=1 */

// if (sec_buf[0] == 0xFF) break; /* пустой сектор ? хвост */

// ++s;

// }

// next_sector = s;

next_sector = 1;

}

/* ====================================================================== */

void sd_init(void) {

SD_CS_DDR |= (1 << SD_CS_PIN);

SD_CS_PORT |= (1 << SD_CS_PIN);

for (uint8_t i = 0; i < 10; i++) spi_x(0xFF); /* 80†тактов на пробуждение */

if (sd_cmd(0, 0, 0x95) != 0x01) return; /* CMD0 GO_IDLE */

uint8_t r = sd_cmd(8, 0x1AA, 0x87); /* CMD8 */

if (r == 0x01) {

for (uint8_t i = 0; i < 4; i++) spi_x(0xFF);

}

do { /* ACMD41 */

sd_cmd(55, 0, 0x65);

r = sd_cmd(41, 0x40000000, 0x77);

} while (r != 0);

if (sd_cmd(58, 0, 0xFF) == 0) { /* CMD58 OCR */

uint32_t ocr = 0;

for (uint8_t i = 0; i < 4; i++) ocr = (ocr << 8) | spi_x(0xFF);

card_sdhc = (ocr & (1UL << 30)) ? 1 : 0;

}

sd_deselect();

spi_x(0xFF);

uint32_t stored = eeprom_read_dword(&eeprom_next_sector);

if (stored >= 1 && stored < 0xFFFFFFFF) {

next_sector = stored;

} else {

find_tail();

}

}

void sd_clear_log(uint16_t n_sectors) {

memset(sec_buf, 0xFF, 512);

for (uint16_t i = 0; i < n_sectors; i++) write_sector(1 + i);

next_sector = 1;

}

/* --------------------------- WRITE line -------------------------------- */

uint8_t sd_write_line(const char *str) {

uint16_t len = strlen(str);

if (!len || len > 510) return 4; /* 0†/ слишком длинно */

memset(sec_buf, 0xFF, 512);

memcpy(sec_buf, str, len);

sec_buf[len] = '\n';

uint8_t res = write_sector(next_sector);

if (res == 0) {

++next_sector;

eeprom_update_dword(&eeprom_next_sector, next_sector);

}

return res;

}

void sd_flush(void) { /* no?op: всегда пишем полный сектор */ }

/* --------------------------- READ iterator ------------------------------ */

void sd_iter_reset(void) { it_sector = 1; }

static uint8_t copy_line(char *dst, uint8_t dst_sz) {

uint16_t i = 0;

while (i < dst_sz - 1 && i < 512 && sec_buf[i] != 0xFF &&

sec_buf[i] != '\n') {

dst[i] = sec_buf[i];

i++;

}

dst[i] = 0;

return 0;

}

uint8_t sd_read_line(int8_t dir, char *dst, uint8_t dst_sz) {

/* -------- вперед -------- */

if (dir > 0) {

if (read_sector(it_sector)) return 1;

if (sec_buf[0] == 0xFF) return 2; /* конец журнала */

uint8_t r = copy_line(dst, dst_sz);

++it_sector;

return r;

}

/* -------- назад --------- */

if (it_sector <= 1) return 3; /* уже в начале */

do {

--it_sector;

if (read_sector(it_sector)) return 1;

} while (sec_buf[0] == 0xFF && it_sector > 1);

return copy_line(dst, dst_sz);

}

uint8_t sd_read_line_at(uint32_t line_num, char *dst, uint8_t dst_sz) {

// допустимый диапазон: [1, next_sector-1]

if (line_num < 1 || line_num >= next_sector) return 1;

// читаем нужный сектор

if (read_sector(line_num)) return 2;

// копируем строку из сектора в dst (останавливаемс¤ на '\n' или 0xFF)

return copy_line(dst, dst_sz);

}

void sd_iter_to_end(void) { it_sector = next_sector; }

uint8_t sd_erase_sector(uint32_t lba) {

// заполн¤ем буфер сектора 0xFF

memset(sec_buf, 0xFF, sizeof(sec_buf));

// записываем буфер в сектор lba

return write_sector(lba);

}

Файл twi.h

#ifndef TWI_H

#define TWI_H

#include <avr/io.h>

enum twi_status {

TWI_STATUS_NOT_INIT = 0,

TWI_STATUS_READY,

TWI_STATUS_TX_BUSY,

TWI_STATUS_TX_COMPLETE,

TWI_STATUS_RX_BUSY,

TWI_STATUS_RX_COMPLETE,

TWI_STATUS_ERROR,

};

extern volatile enum twi_status twi_status;

void twi_init(void);

void twi_write(uint8_t slaw, uint8_t reg_addr, uint8_t *buf, uint8_t size);

void twi_read(uint8_t slaw, uint8_t reg_addr, uint8_t *buf, uint8_t size);

#endif

/* End File */

Файл twi.c

#include <avr/pgmspace.h>

#include <avr/interrupt.h>

#include "twi.h"

#define LINE_FREQ 100000UL // Частота обмена в Гц

#define F_CPU 8000000UL

volatile enum twi_status twi_status = TWI_STATUS_NOT_INIT;

static struct twi

{

uint8_t slaw;

uint8_t reg_addr;

uint8_t *data;

uint8_t count;

} twi;

/**

* Функция инициализации модуля TWI.

* По окончанию инициализации устанавливается статус TWI_STATUS_READY.

* Частота обмена в Гц: LINE_FREQ.

* Используется прерывание по событиям на шине TWI.

*/

void twi_init(void)

{

TWBR = (F_CPU / LINE_FREQ - 16) / 2;

TWCR |= (1 << TWEN) | (1 << TWIE);

twi_status = TWI_STATUS_READY;

}

/**

* Функция записи/чтения в/из регистра ведомого устройства

*

* \param slaw адрес ведомого устройства SLA+W

* \param reg_addr адрес начального регистра для записи/чтения

* \param buf указатель на буфер для записи/чтения

* \param size размер буфера для записи/чтения

*/

static inline void twi_txrx(

uint8_t slaw, uint8_t reg_addr, uint8_t *buf, uint8_t size)

{

twi.slaw = slaw;

twi.reg_addr = reg_addr;

twi.data = buf;

twi.count = size;

TWCR = (1<<TWINT) | (1<<TWSTA) | (1<<TWEN) | (1<<TWIE);

}

/**

* Функция записи в регистр ведомого устройства.

* Во время записи устанавливается статус TWI_STATUS_TX_BUSY, после записи

* устанавливается статус TWI_STATUS_TX_COMPLETE.

*

* \param slaw адрес ведомого устройства SLA+W

* \param reg_addr адрес начального регистра для записи

* \param buf указатель на буфер для записи

* \param size размер буфера для записи

*/

void twi_write(uint8_t slaw, uint8_t reg_addr, uint8_t *buf, uint8_t size)

{

twi_txrx(slaw, reg_addr, buf, size);

twi_status = TWI_STATUS_TX_BUSY;

}

/**

* Функция чтения из регистра ведомого устройства.

* Во время чтения устанавливается статус TWI_STATUS_RX_BUSY, после чтения

* устанавливается статус TWI_STATUS_RX_COMPLETE.

*

* \param slaw адрес ведомого устройства SLA+W

* \param reg_addr адрес начального регистра для чтения

* \param buf указатель на буфер для чтения

* \param size размер буфера для чтения

*/

void twi_read(uint8_t slaw, uint8_t reg_addr, uint8_t *buf, uint8_t size)

{

twi_txrx(slaw, reg_addr, buf, size);

twi_status = TWI_STATUS_RX_BUSY;

}

/* Конечный автомат линии TWI */

enum line_status

{

LINE_BUS_ERROR = 0, // Ошибка на шине в результате некорректного формирования

// состояния СТАРТ или СТОП

LINE_START = 1, // Сформировано состояние СТАРТ

LINE_REP_START = 2, // Сформировано состояние ПОВСТАРТ

LINE_TX_SLA_ACK = 3, // Передан пакет SLA+W и принято подтверждение (ACK)

LINE_TX_SLA_NACK = 4, // Передан пакет SLA+W, а подтверждение не принято (NACK)

LINE_TX_DATA_ACK = 5, // Передан пакет данных и принято подтверждение (ACK)

LINE_TX_DATA_NACK = 6, // Передан пакет данных, а подтверждение не принято (NACK)

LINE_ARB_LOST = 7, // Потеря приоритета при передаче пакета адреса или данных

LINE_RX_SLA_ACK = 8, // Передан пакет SLA+R и принято подтверждение (ACK)

LINE_RX_SLA_NACK = 9, // Передан пакет SLA+R и принято неподтверждение (NACK)

LINE_RX_DATA_ACK = 10, // Принят байт данных и передано подтверждение (ACK)

LINE_RX_DATA_NACK = 11, // Принят байт данных и передано неподтверждение (NACK)

LINE_CNT

};

static void line_error_stop(void)

{

TWCR |= (1 << TWSTO);

twi_status = TWI_STATUS_ERROR;

}

static void line_send_slaw(void)

{

TWDR = twi.slaw;

TWCR &= ~(1 << TWSTA);

}

static void line_send_slar(void)

{

uint8_t twi_slar = twi.slaw | 0x01;

TWDR = twi_slar;

TWCR &= ~(1 << TWSTA);

}

static void line_send_reg_addr(void)

{

TWDR = twi.reg_addr;

}

static void line_tx_data(void)

{

switch (twi_status)

{

case TWI_STATUS_RX_BUSY:

TWCR |= (1 << TWSTA);

break;

case TWI_STATUS_TX_BUSY:

TWDR = *twi.data++;

if (twi.count-- == 0)

{

TWCR |= (1 << TWSTO);

twi_status = TWI_STATUS_TX_COMPLETE;

}

break;

default:

break;

}

}

static void line_rx_set_ack(void)

{

if (--twi.count)

{

TWCR |= (1 << TWEA); // ACK

}

else

{

TWCR &= ~(1 << TWEA); // NACK

}

}

static void line_rx_data(void)

{

*twi.data++ = TWDR;

line_rx_set_ack();

}

static void line_rx_last_data(void)

{

*twi.data++ = TWDR;

TWCR |= (1 << TWSTO);

twi_status = TWI_STATUS_RX_COMPLETE;

}

typedef void (*vfptr_t)(void);

const vfptr_t line_actions_table[LINE_CNT] PROGMEM = {

[LINE_BUS_ERROR] = line_error_stop,

[LINE_START] = line_send_slaw,

[LINE_REP_START] = line_send_slar,

[LINE_TX_SLA_ACK] = line_send_reg_addr,

[LINE_TX_SLA_NACK] = line_error_stop,

[LINE_TX_DATA_ACK] = line_tx_data,

[LINE_TX_DATA_NACK] = line_error_stop,

[LINE_ARB_LOST] = line_error_stop,

[LINE_RX_SLA_ACK] = line_rx_set_ack,

[LINE_RX_SLA_NACK] = line_error_stop,

[LINE_RX_DATA_ACK] = line_rx_data,

[LINE_RX_DATA_NACK] = line_rx_last_data,

};

/* Прерывание используется для обработки события на линии TWI */

ISR(TWI_vect)

{

enum line_status status = (TWSR & 0xF8) >> 3;

vfptr_t func = (vfptr_t)pgm_read_word(&line_actions_table[status]);

if (func != 0)

{

func();

}

else

{

TWCR |= (1 << TWSTO);

}

TWCR |= (1 << TWINT);

}

/* End File */

Файл sevseg.h

#ifndef SEVSEG_H

#define SEVSEG_H

#include <avr/io.h>

void sevseg_init(void);

void sevseg_bin2bcd(uint16_t number, uint8_t *digits);

void sevseg_display_process(const volatile uint8_t *digits);

void sevseg_off(void);

void sevseg_set_dot(uint8_t position);

void sevseg_blank_leading(uint8_t on);

#endif

/* End File */

Файл secseg.c

#include <avr/pgmspace.h>

#include "sevseg.h"

#define DATA_PORT PORTA // Порт данных к которому подключены

#define DATA_DDR DDRA // семисегментные индикаторы.

#define CTRL_PORT PORTB // Управляющий порт к которому подключены общие

#define CTRL_DDR DDRB // катоды/аноды семисегментных индикаторов

#define CTRL_PIN3 3 // Номер вывода общего а/к четвертого индикатора

#define CTRL_PIN2 2 // Номер вывода общего а/к третьего индикатора

#define CTRL_PIN1 1 // Номер вывода общего а/к второго индикатора

#define CTRL_PIN0 0 // Номер вывода общего а/к первого индикатора

#define CTRL_PIN_MASK \

((1 << CTRL_PIN3) | (1 << CTRL_PIN2) | (1 << CTRL_PIN1) | (1 << CTRL_PIN0))

static uint8_t dot_pos = 0xFF; /* по умолчанию точка выключена */

static uint8_t blank_leading = 0; /* гасить ли ведущие нули */

#define SEVSEG_MINUS_CODE 0b00000010

void sevseg_set_dot(uint8_t position) { dot_pos = position; }

void sevseg_blank_leading(uint8_t on) { blank_leading = on; }

const uint8_t ctrl_pins[4] PROGMEM = {

(1 << CTRL_PIN0),

(1 << CTRL_PIN1),

(1 << CTRL_PIN2),

(1 << CTRL_PIN3),

};

/* Таблица перекодировки символов в памяти программ */

const uint8_t dec2sevseg[10] PROGMEM = {

0b11111100, // код "0"

0b01100000, // код "1"

0b11011010, // код "2"

0b11110010, // код "3"

0b01100110, // код "4"

0b10110110, // код "5"

0b10111110, // код "6"

0b11100000, // код "7"

0b11111110, // код "8"

0b11110110 // код "9"

};

/**

* Функция инициализации 4-х семисегментных индикаторов

* Выводы данных подключены к DATA_PORT

* Выводы управления подключены к CTRL_PORT

*/

void sevseg_init(void) {

/* Выводы данных и управления - выходы */

DATA_DDR = 0xFF;

DATA_PORT = 0x00;

CTRL_DDR |= CTRL_PIN_MASK;

CTRL_PORT &= ~CTRL_PIN_MASK;

// TODO проверить нужна ли данная строчка

CTRL_PORT |= (1 << CTRL_PIN0);

}

/**

* Функция перевода 2-х байтного числа в 4-х разрядное двоично-десятичное число.

*

* \param value исходное 2-х байтное число

* \param digits указатель на 4-х байтный буфер, в который записываются разряды

* двоично-десятичного числа.

*/

void sevseg_bin2bcd(uint16_t value, uint8_t *digits) {

/* Установка указателя на последний (старший) разряд */

digits += 4 - 1;

/* Вычисление разрядов числа, начиная со старшего */

*digits-- = value / 1000;

value %= 1000;

*digits-- = value / 100;

value %= 100;

*digits-- = value / 10;

value %= 10;

*digits-- = value / 1;

value %= 1; // ?

}

/**

* Функция циклически инкрементирует номер отображаемого разряда

* 4-х разрядного числа

*

* \return номер следующего отображаемого разряда

*/

static uint8_t inc_number_digit(void) {

static uint8_t num_dig = 0;

num_dig = (num_dig + 1) & 0x03;

return num_dig;

}

/**

* Функция отображения разряда 4-х разрядного числа на семисегментном

* индикаторе. Для преобразования разряда числа в код семисегментного индикатора

* используется таблица перекодировки символов dec2sevseg в памяти программ.

*

* \param digits указатель на 4-х байтное двоично-десятичное число

* \param num_dig номер отображаемого разряда

*/

static void display_digit(const volatile uint8_t *digits, uint8_t num_dig) {

DATA_PORT = 0x00;

CTRL_PORT &= ~CTRL_PIN_MASK;

uint8_t d = digits[num_dig];

/* гасим лидирующие нули, кроме младшего разряда */

if (blank_leading && num_dig > 0) {

uint8_t higher_nonzero = 0;

for (uint8_t i = 3; i > num_dig; --i)

if (digits[i]) higher_nonzero = 1;

if (!higher_nonzero && d == 0) { /* просто не включаем индикатор */

return;

}

}

uint8_t seg;

if (d <= 9) { /* цифра */

seg = pgm_read_byte(&dec2sevseg[d]);

} else if (d == 0x0A) { /* «минус» */

seg = SEVSEG_MINUS_CODE;

} else { /* пусто */

return;

}

if (num_dig == dot_pos) seg |= 0x01; /* точка */

DATA_PORT = seg;

CTRL_PORT |= pgm_read_byte(&ctrl_pins[num_dig]);

}

/**

* Функция отображения 4-х разрядного двоично-десятичного числа на

* 4-х семисегментных индикаторах.

* При каждом вызове отображается один разряд, поэтому для отображения всего

* числа, функцию необходимо переодически вызывать.

*

* \param digits указатель на 4-х байтное двоично-десятичное число

*/

void sevseg_display_process(const volatile uint8_t *digits) {

uint8_t num_dig = inc_number_digit();

display_digit(digits, num_dig);

}

/**

* Функция выключения семисегментных индикаторов

*/

void sevseg_off(void) { DATA_PORT = 0x00; }

/* End File */

Файл spi.h

/* ----------------------------- spi.h ------------------------------ */

#ifndef SPI_H

#define SPI_H

#include <avr/io.h>

void spi_init(void);

uint8_t spi_transfer(uint8_t data);

#endif

//

Файл spi.c

/* ----------------------------- spi.c ------------------------------ */

#include "spi.h"

#include <avr/io.h>

void spi_init(void)

{

/* MOSI – PB5, MISO – PB6, SCK – PB7 */

DDRB |= (1<<PB5)|(1<<PB7); /* outputs */

DDRB &= ~(1<<PB6); /* MISO input */

SPCR = (1<<SPE)|(1<<MSTR)|(1<<CPOL)|(1<<CPHA)|(1<<SPR0); /* fosc/16, mode 1 */

}

uint8_t spi_transfer(uint8_t data)

{

SPDR = data;

while(!(SPSR & (1<<SPIF)));

return SPDR;

}

//
