NikitaSM5/ATmega-16-RTD/Altium project/ATmega16-RTD/ATmega16-RTD.pdf

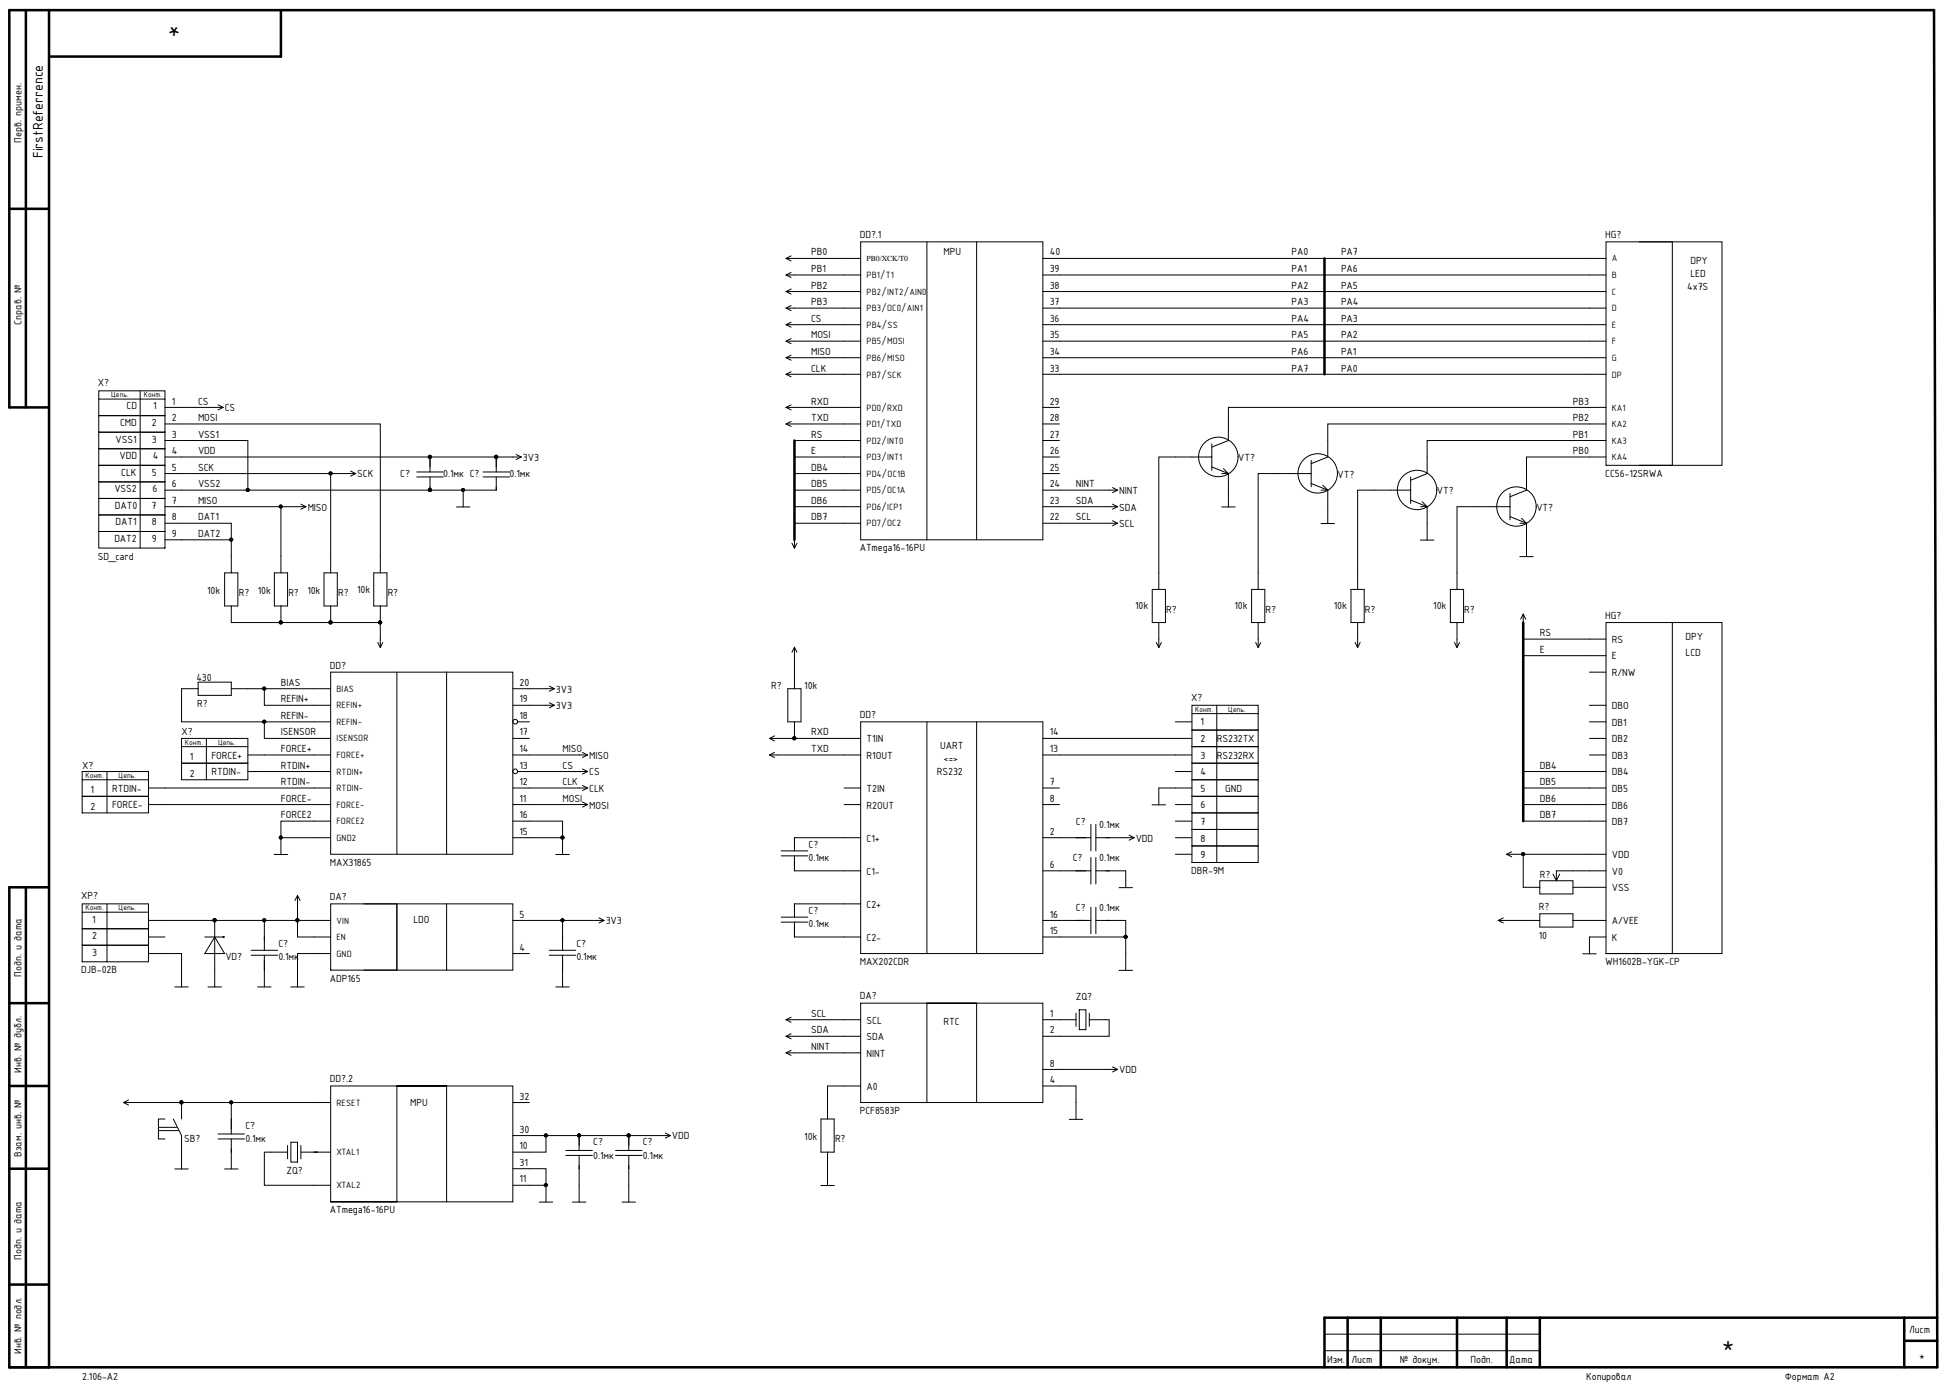
[picture p52: page 1]

Инв. № подл. Инв. № дубл. Подп. и дата Взам. инв. № Подп. и дата Перв. примен. Справ. №

C D | 1
C M D | 2
VSS1 | 3
VDD | 4
C L K | 5

VSS2 | 6
DAT0 | 7
DAT1 | 8
DAT2 | 9

DAT2

HG? WH1 RS E R/NW DBO DB1 DB2 DB3 DB4 DB5 DB6 DB7 VDD V 0 VSS A / V E E K | DPY LCD

Лист | № докум. | Подп. | Дата | * Изм.

Лист*

# Board Sta
