NikitaSM5/ATmega-16-RTD/(list of files, drawings)

Other design files:
Altium project/ATmega16-RTD/ATmega16_RTD.SchDoc
Altium project/ATmega16-RTD/ATmega16_RTD.SchLib
dz.pdsprj
