NikitaSM5/ATmega-16-RTD/(commit log)

2025-04-26 Показывает говно, но SPI работает
    [dz.pdsprj]
2025-04-26 БЛЯ ОНО РАБОТАЕТ
    [dz.pdsprj]
2025-04-26 Отрицательная температура
    [dz.pdsprj]
2025-04-26 Added rtc
    [dz.pdsprj]
2025-04-26 Added LCD
    [dz.pdsprj]
2025-04-26 Added sd card write
    [dz.pdsprj]
2025-04-27 Все работает, остался uart
2025-04-28 Stand working
    [dz.pdsprj]
2025-04-29 All working on stand
    [ATmega16_RTD.SchDoc, ATmega16_RTD.SchLib]
2025-04-29 Блок схема алгоритма.pdf
2025-05-03 Блок схема алгоритма max31865.cdw
2025-05-03 Работает все кроме sd
    [dz.pdsprj]
2025-05-03 Лучше не стало
2025-05-04 Все работает
2025-05-04 Блок схема алгоритма SD.cdw
2025-05-04 Блок схема алгоритма.cdw
2025-05-04 Блок схема алгоритма full.pdf
2025-05-05 Отчет
    [ATmega16_RTD.SchDoc, ATmega16_RTD.SchLib]
2025-05-06 Вроде все работает
2025-05-07 Все супер работает
2025-05-07 Ласт супер рабочая
2025-05-07 Бегущая строка
2025-05-13 Как я его сильно люблю не описать словами
    [dz.pdsprj]
2025-05-13 Секс
2025-05-25 Отчет новый
    [dz.pdsprj]
2025-06-17 Правки
